steam228/GROUU/ARDUINO/GROUU_V3/docs/Board-Design.md

---
tags: [wellbouy, hardware, kicad]
---

# WellBouy — Board Design Notes

Keep-modular vs bring-on-board, one item per block, in bring-up order.
Companion to [[Bringup-Plan]]. ✅ decided · 🟡 mid-decision · ❓ needs info.

## 01 · MCU + LoRaWAN radio
- **Modules:** XIAO ESP32-S3 (socketed) + Wio-SX1262.
- **On-board:** header sockets, decoupling, BOOT/RST access, USB-C reachable.
- ✅ Both stay as modules (RF + USB + antenna already done/certified). Bare SX1262 only considered for a later rev.

## ADC (shared front-end)
- **Module:** ADS1115 16-bit I²C — Seeed Grove 4-ch (plug-and-play) or Adafruit PID 1085. Phidgets does **not** include an ADC, so this is required.
- **On-board:** ADS at 3.3 V, addr 0x48, I²C pullups; all sensor outputs scaled to ≤3.3 V before its inputs.
- ✅ Use ADS. ⚠️ Changes firmware pin map: analog sensors → ADS A0–A3, XIAO gains I²C, DS18B20 stays digital.
- 🔁 **ADS history:** the DFRobot Gravity I²C ADS1115 (the earlier "DFR0553" — it *is* the ADC, **not** a solar manager, so the solar-manager slot is still open) **died in bring-up**: reverse-polarity from the DFRobot-Gravity ↔ Grove **connector pinout mismatch** (they mate but VCC/GND differ). Confirmed dead — powered, bus healthy, wiring correct, **zero I²C ACK** (bit-bang verified). → Switching to a **Grove ADS1115** (Grove-to-Grove keyed = no mismatch), buying 2026-07-03.
- ⚠️ **Lessons → board TODO:** (1) **reverse-polarity protection** on every rail; (2) **keyed connectors**, and never mix Gravity↔Grove without checking pinout; (3) firmware **I²C bus-recovery / watchdog** — a bad device can hang the hardware `Wire` driver (bit-bang probe + bus-level check now live in `b03_tds` for debugging).

## 02 · Temperature — DS18B20
- **Module:** none (probe on cable).
- **On-board:** 4.7 kΩ pullup, probe connector, 3.3 V powered.
- ✅ Settled.

## 03 · TDS — DFRobot Gravity
- **Module:** DFRobot Gravity TDS conditioner board.
- **On-board:** 5 V (switched) feed, output divider to ADS, probe connector.
- 🟡 Module for rev A; integrating the AC-excitation front-end is a rev-B maybe.

## 04 · Turbidity — Seeed Grove
- **Module:** Seeed Grove turbidity sensor head/driver (replaced the DFRobot SEN0189).
- **On-board:** 10k/6.8k divider, 5 V (switched) feed, probe connector (U5 → A1).
- ✅ Divider on-board; head stays cabled.

## 05 · pH — Phidgets 1130
- **Module:** Phidgets 1130 adapter (analog conditioner, 0–5 V out, pH7 ≈ 2.5 V).
- **On-board:** 5 V (switched) feed, output divider to ADS, BNC/probe connector.
- 🟡 Keep module rev A (gigaΩ front-end + guard is easy to get wrong); integrate later only if needed.

## Connectors (all probes)
- ✅ Screw terminals / IP-rated (steady closed well, no Grove needed in the field). Grove only for bench.

## Power — Solar panel + battery + rails
- **Rails:** 3.3 V always-on (MCU, radio, ADS, DS18B20) + 5 V **switched** (analog conditioners, on ~1 s/cycle via GPIO load switch).
- **Test-phase module:** ❓ **DFR0553** — confirm it has MPPT/solar input and which rails (5 V only vs 5 V+3.3 V). If it's a real Solar Power Manager, it's the power core.
- **Fallback charger:** 🟡 **DFR1026** (Li-ion + 5 V boost, no MPPT). ⚠️ Bench-only until verified its 5 V **auto-restarts after full battery cutoff** (button/latch risk = no field auto-recovery).
- **On-board (custom rev):** our own high-side load switch for the 5 V sensor branch; later swap module for low-Iq buck/boost.
- **Battery:** 🟡 leaning 1S Li-ion 18650 (LiFePO4 if cold). Share battery node with XIAO BAT for the 3.3 V.
- **Panel:** ❓ none yet — size **after** bring-up measures sleep/active current; pick voltage to match the chosen charger.

## Rev-B feedback (from well-bouy01 fabrication + bring-up, 2026-07)
Lessons from building and bringing up the fabricated rev-A boards — the change list for rev-B.

- **ADS1115 hand-soldering is the #1 casualty. ✅ fix in rev-B.** The VSSOP-10 (0.5 mm pitch)
  ADS is brutal to hand-solder/rework — **3 boards damaged**, one ADS pad lifted during rework
  and killed a whole board mid-bring-up. → **Have JLCPCB SMT-assemble the ADS** (and the other
  fine-pitch/QFN parts), or move to a pre-assembled ADS1115 module footprint. If kept hand-built:
  larger/thermal-relieved pads + a paste stencil. This single change removes most of the build risk.
- **Terminal silk shows refdes (U2–U5), not function. ✅ fix in rev-B.** During bring-up the Grove
  turbidity got wired into **U3 (which is electrically the pH channel, A2)** because the silk only
  says "U3" — the numbering doesn't follow the sensor order. → Silk each screw terminal with its
  **function + ADS channel + pin order**, e.g. `TEMP 3V3·DAT·GND`, `TDS A0 5V·SIG·GND`,
  `TURB A1 5V·SIG·GND`, `pH A2 5V·SIG·GND`; label CN3 as `5V IN` and CN1/CN2 as `GROVE`.
- **Reverse-polarity P-FET (q_revp) is unprotected + easy to lose. 🟡 rev-B.** It burned when a
  live board was probed for continuity, and with it gone there's no reverse protection. → Add a
  **resettable fuse + TVS** on the 5 V input, and **test points** on v5v / v5v_sw / the ADS
  channels / SDA·SCL so bring-up doesn't require probing bare nets. Silk a "measure unpowered" note.
- **Turbidity sensor changed: DFRobot SEN0189 → Seeed Grove.** Same 5 V range, same 10k/6.8k
  divider, so no board change — but the BOM/labels reference Grove now (see §04).
- **Keep (worked well):** socketed XIAO + Wio-SX1262 as modules, switched-5 V load switch,
  3V3 always-on split, screw-terminal probes, single shared ADS front-end.
