steam228/GROUU/docs/index.md

---
layout: default
title: GROUU BOM PT_PT wip
---

# Set V0 GROUU
- - - -

## 1. Sonda de Solo - *Soil Probe*
- - - -
*Um conjunto de componentes formam um sensor wireless de medição de humidade e temperatura do solo. Os dados enviados por este sensor possibilitam tomada de decisão no que toca a opções de rega, entre outras informações importantes para o desenvolvimento das Plantas.*
*Dividido em dois componentes ligados por um fio, o primeiro será o corpo principal e o segundo apenas o encapsulamento de dois eletrodos adicionais, que quando ligados por fio ao corpo principal permitem a avaliação de humidade do solo, a uma profundidade superior.*

##### Componente Principal (corpo) contém:
- 2 electrodos;
- 1 Microcontrolador + Chip Wireless (dependendo do protocolo de comunicação pode assumir diferentes formas, neste caso apenas um ESP12)
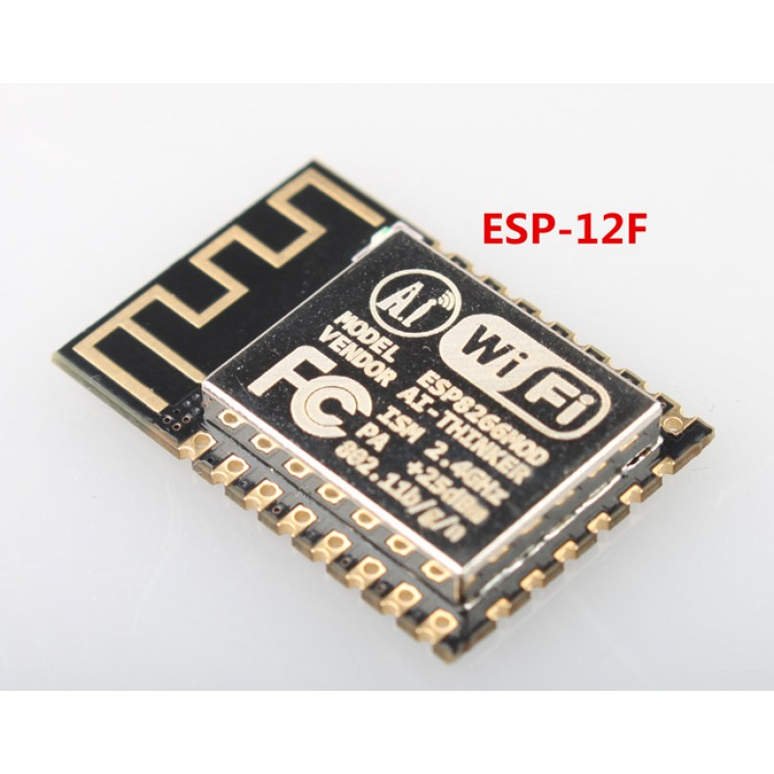
[picture p6: docs/Set V0 GROUU/00CDE53B-2D0E-4704-A9E1-9CB0C4399E5F 2.png]

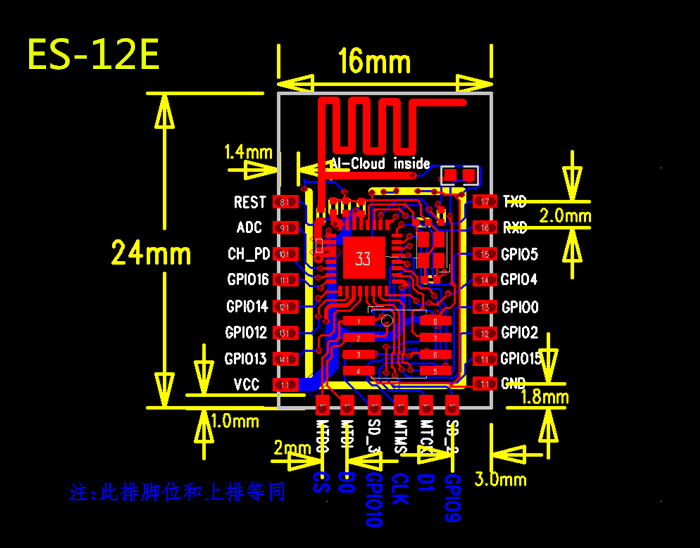
[picture p7: docs/Set V0 GROUU/8B35F060-8294-48BE-A186-7AB80FA3CB3D 2.png]


- Um termometro digital:
	- Com encapsulamento pp: [1pcs Direct waterproof DS18B20 digital temperature sensor (probe) a large number of original spot can be customised in Sensors from Electronic Components & Supplies on Aliexpress.com |
Alibaba Group](https://www.aliexpress.com/item/1pcs-Direct-waterproof-DS18B20-digital-temperature-sensor-probe-a-large-number-of-original-spot-can-be/32675444739.html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,searchweb201602_1_10065_10068_319_317_10696_453_10084_454_10083_433_10618_431_10304_10307_10820_10821_10301_537_536_10902_10059_10884_10887_321_322_10103,searchweb201603_16,ppcSwitch_0&algo_expid=053b9263-dde6-4dbb-8d99-83143a31b1db-0&algo_pvid=053b9263-dde6-4dbb-8d99-83143a31b1db) ou;
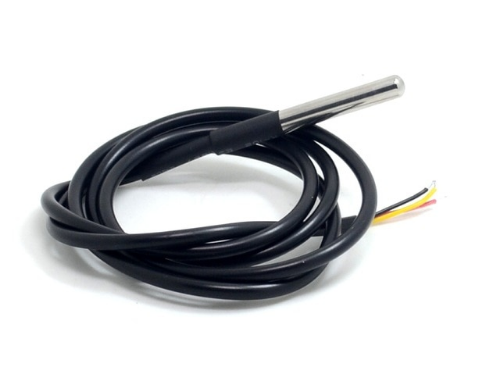
[picture p8: docs/Set V0 GROUU/Screenshot_2019-01-30 US $1 06 8% OFF 1pcs Direct waterproof DS18B20 digital temperature sensor (probe) a large number of o... 2.png]

	- integrar no desenho utilizando apenas componente: [Free Shipping 10pcs DALLAS DS18B20 18B20 TO 92 IC CHIP Thermometer Temperature Sensor-in Sensors from Electronic Components & Supplies on Aliexpress.com | Alibaba Group](https://www.aliexpress.com/item/Free-Shipping-10pcs-DALLAS-DS18B20-18B20-18S20-TO-92-IC-CHIP-Thermometer-Temperature-Sensor/32523899337.html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)*
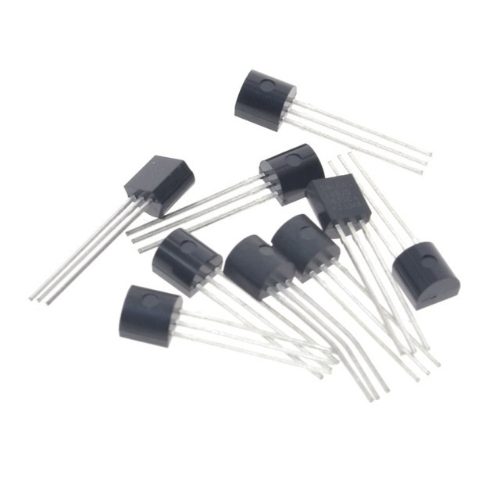
[picture p9: docs/Set V0 GROUU/Screenshot_2019-01-30 US $5 8 Free Shipping 10pcs DALLAS DS18B20 18B20 TO 92 IC CHIP Thermometer Temperature Sensor-in Sens... 2.png]


- Alguns componentes complementares: Resistências, condensadores e afins que podem compor a forma da restante placa de muitas formas diferentes, fazendo com que a maior condicionante seja o pp ESP12E;

##### Componente Secundária apenas com dois eletrodos ligados por fio à componente principal. esta é opcional e permite a mediação da humidade do solo a maior profundidade.


*Exemplos de outros formatos e configurações de Soil Moisture Sensors*
- - - -

## 2. “Encaminhador de Água” - *Water Router 1/4*
- - - -
*Serve para direccionar a água dividindo-a de um para 4. Assim, podemos juntar quantos quisermos em serie podendo desta forma aumentar a distribuição da água por mais zonas de rega.*

- Placa de Controle com:
	- ESP12E;
	- Alguns componentes complementares: Resistências, condensadores e afins que podem compor a forma da restante placa de muitas formas diferentes, fazendo com que a maior condicionante seja o pp ESP12E;
- Solenoid Valves: 1 para 4 12V NC (normally closed) [1Pcs DC 12V DN20 G3/4” 1 in 4 out Plastic Electromagnetic Valve Normally Closed Water Drain Valve-in Valve from Home Improvement on Aliexpress.com | Alibaba Group](https://www.aliexpress.com/item/1Pcs-DC-12V-DN20-G3-4-1-in-4-out-Plastic-Electromagnetic-Valve-Normally-Closed-Water/32897483874.html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,searchweb201602_1_10065_10068_319_317_10696_453_10084_454_10083_433_10618_431_10304_10307_10820_10821_10301_537_536_10902_10059_10884_10887_321_322_10103,searchweb201603_16,ppcSwitch_0&algo_expid=76eabde3-c4e3-4ab8-a5b5-27f0efe548b0-33&algo_pvid=76eabde3-c4e3-4ab8-a5b5-27f0efe548b0)
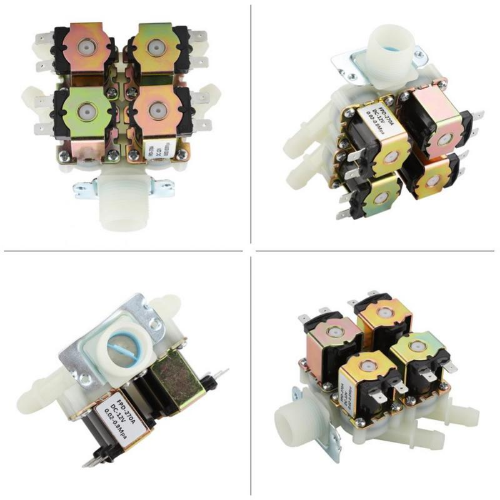
[picture p10: docs/Set V0 GROUU/Screenshot_2019-01-30 US $16 17 37% OFF 1Pcs DC 12V DN20 G3 4 1 in 4 out Plastic Electromagnetic Valve Normally Closed Wate... 2.png]

- - - -

## 3. Sensor de Nível da Água (Para adaptar a qualquer tanque de água) - *Water Level Sensor - Smart Tank*
- - - -
*Pretende-se a criação de uma unidade de sensor que possa ser adaptada à medição do volume existente em qualquer tanque. Bastará instalar e calibrar.*

- Placa de Controle com:
	- ESP12E;
	- Alguns componentes complementares: Resistências, condensadores e afins que podem compor a forma da restante placa de muitas formas diferentes, fazendo com que a maior condicionante seja o pp ESP12E;
- Sensor de nível de água pode ser conseguido de diferentes formas: (explos)
	- aplicar diferentes interruptores ligados por fio:[100V Liquid Water Level Sensor Horizontal Float Switch For Aquariums Fish Tank-in Flow Sensors from Tools on Aliexpress.com | Alibaba Group](https://www.aliexpress.com/item/100V-Liquid-Water-Level-Sensor-Horizontal-Float-Switch-For-Aquariums-Fish-Tank/32947871632.html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,searchweb201602_1_10065_10068_319_317_10696_453_10084_454_10083_433_10618_431_10304_10307_10820_10821_10301_537_536_10902_10059_10884_10887_321_322_10103,searchweb201603_6,ppcSwitch_0&algo_expid=cd4f33f5-30f1-44e8-972c-3e771defacdd-1&algo_pvid=cd4f33f5-30f1-44e8-972c-3e771defacdd)
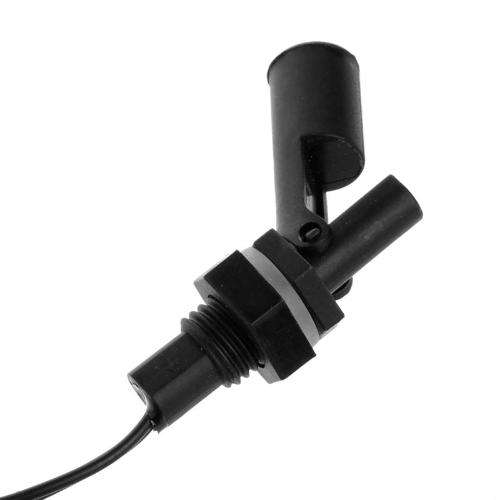
[picture p11: docs/Set V0 GROUU/Screenshot_2019-01-30 US $1 11 15% OFF 100V Liquid Water Level Sensor Horizontal Float Switch For Aquariums Fish Tank-in Fl... 2.png]


	- Usar um sensor InfraRed no topo: [Newest 15mA 5V Optical Infrared Water Liquid Level Sensor Liquid Water Level Control Switch Favorable Level Sensors-in Sensors from Electronic Components & Supplies on Aliexpress.com | Alibaba Group](https://www.aliexpress.com/item/Newest-15mA-5V-Optical-Infrared-Water-Liquid-Level-Sensor-Liquid-Water-Level-Control-Switch-Favorable-Level/32748475170.html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)
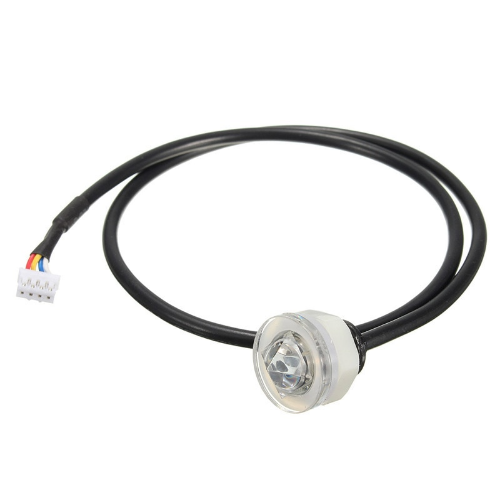
[picture p12: docs/Set V0 GROUU/Screenshot_2019-01-30 US $2 74 10% OFF Newest 15mA 5V Optical Infrared Water Liquid Level Sensor Liquid Water Level Control... 2.png]

- - - -

## 4. Controlador de Bomba de Água - *Water Motor Controller (to fit most 12V Solar water pumps)*
- - - -

*Trata-se de um controlador simples de motor, a colocar como interruptor na alimentação do Motor*

- Placa de Controle com:
	- ESP12E;
	- Alguns componentes complementares: Resistências, condensadores e afins que podem compor a forma da restante placa de muitas formas diferentes, fazendo com que a maior condicionante seja o pp ESP12E
- - - -

## 5. Bomba Doseadora Peristáltica - *Peristaltic Pump*
- - - -
*É uma bomba de pequenas dimensões que faz uma dosagem mais fina e precisa. Pode ser usado para regar um vaso ou para dosear outras substancias liquidas na água. Por exemplo um corrector de pH ou um fertilizante.*

- Placa de Controle com:
	- ESP12E;
	- Alguns componentes complementares: Resistências, condensadores e afins que podem compor a forma da restante placa de muitas formas diferentes, fazendo com que a maior condicionante seja o pp ESP12E
- Sistema de rolos ou elemento excêntrico que ao rodar pressione uma mangueira de silicone do tipo:
- NEMA14 ￼
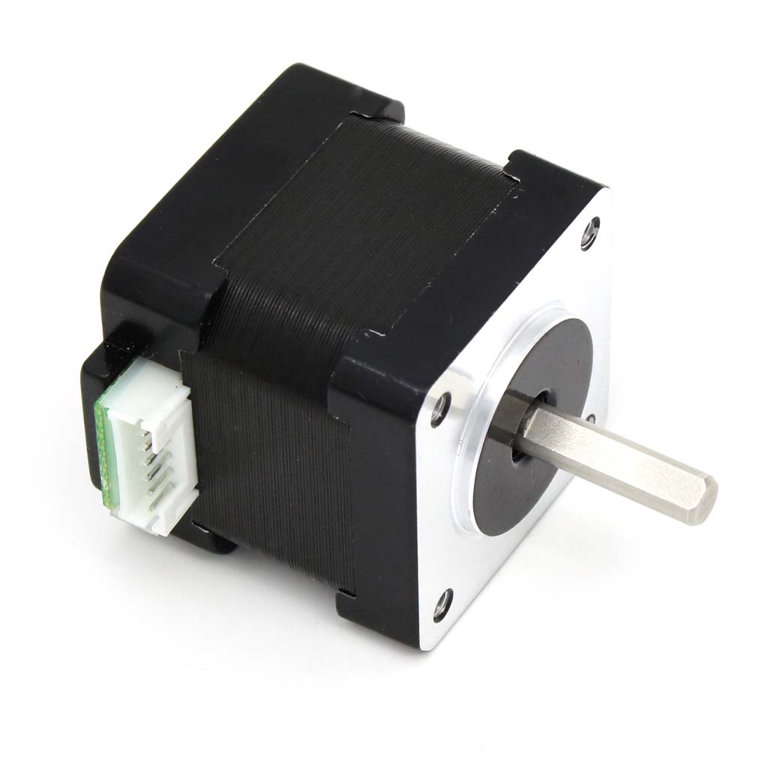
[picture p13: docs/Set V0 GROUU/MotorSide 2.jpg]

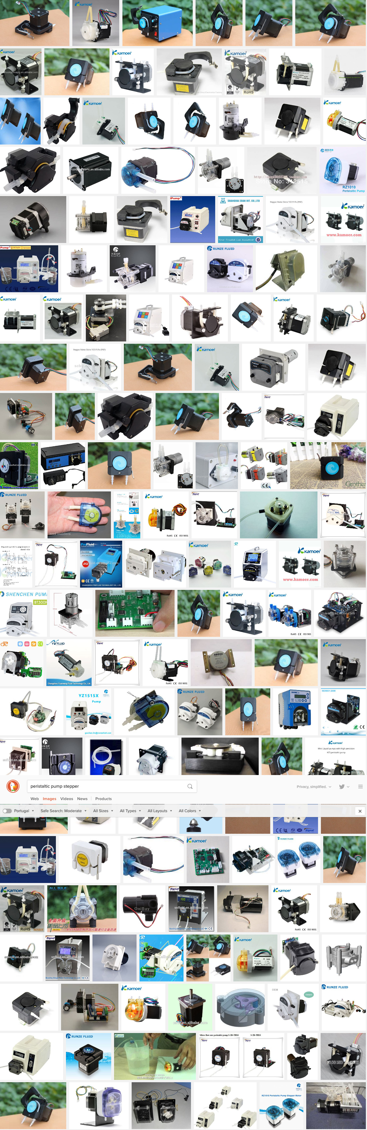
[picture p14: docs/Set V0 GROUU/Screenshot_2019-02-02 peristaltic pump stepper at DuckDuckGo.jpg]

*Exemplos de outros formatos e configurações de bombas peristalticas*

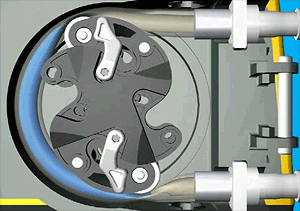
[picture p15: docs/Set V0 GROUU/Peristaltic_pump.gif]

*Como Funciona uma Bomba Peristática*
- - - -

￼
## 6. Carregador de Indução - *(Solar) Inductive Charger*
- - - -

- Placa de Controle com:
	- ESP12E;
	- Alguns componentes complementares: Resistências, condensadores e afins que podem compor a forma da restante placa de muitas formas diferentes, fazendo com que a maior condicionante seja o pp ESP12E
- Uma Bateria de Back-up;
- **Alimentação:**
	- Pode estar ligado à corrente eléctrica 220V e aí terá que ter um conversor ou transformador, tipo carregador de telemóvel;
	- Possui painéis solares: [198E 4W 5.5V Polysilicon Solar Panel Cell Sunlight Charger Road Lamps Outdoors  | eBay](https://www.ebay.com/itm/198E-4W-5-5V-Polysilicon-Solar-Panel-Cell-Sunlight-Charger-Road-Lamps-Outdoors-/273681207899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)
*Specification:
Colour: Black
Material: Polysilicon
Length: 18.5cm
Width: 7.4cm
Thickness: 0.2
Maximum power: 4 (W)
Operating current: 720 (A)
Operating voltage: 5.5 (V)
Working temperature: -20 ℃ - + 85 ℃
Mainly used in solar power road lights, garden lamps, uninterruptible power supply, solar mobile power gifts, etc.*
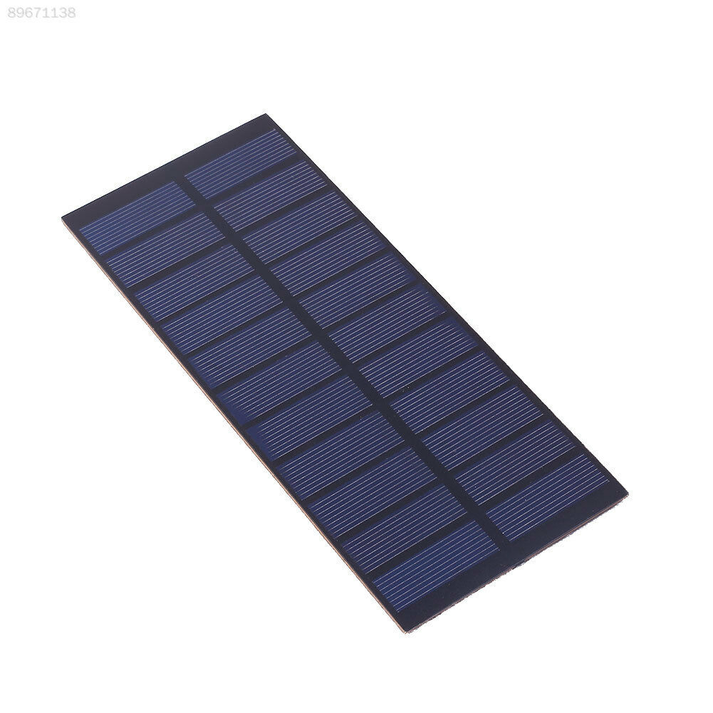
[picture p16: docs/Set V0 GROUU/s-l1600.jpg]

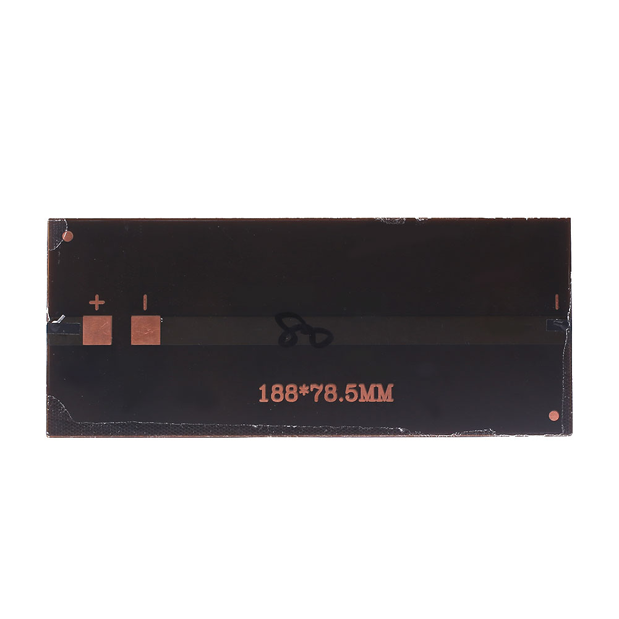
[picture p17: docs/Set V0 GROUU/158244_3.jpg]

- - - -

## 7. Núcleo - *Core*
- - - -
*Apenas um computador ligado à rede por Wireless*

- Raspberry Pi Zero W alimentado por transformador ou com bateria pp.
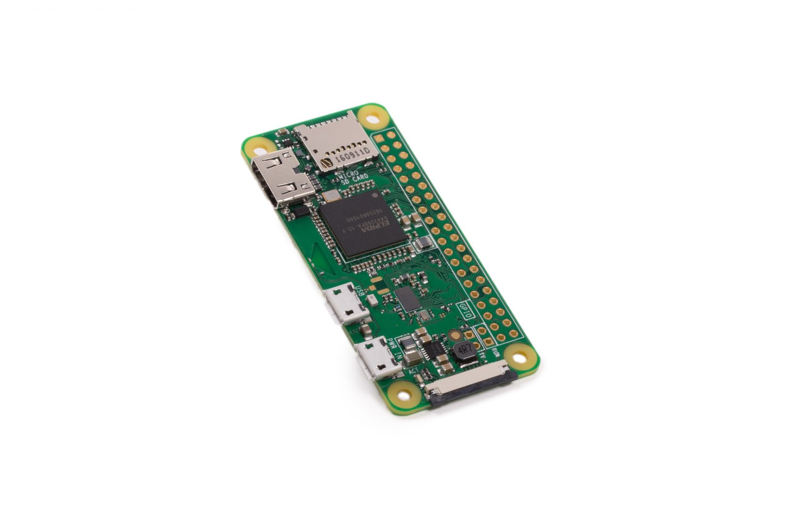
[picture p18: docs/Set V0 GROUU/Pi-Zero-W-Tilt-1-1620x1080.jpg]

(modelo 3D no GrabCAD) [3D CAD Model Collection | GrabCAD Community Library](https://grabcad.com/library/raspberry-pi-zero-w-board-1)
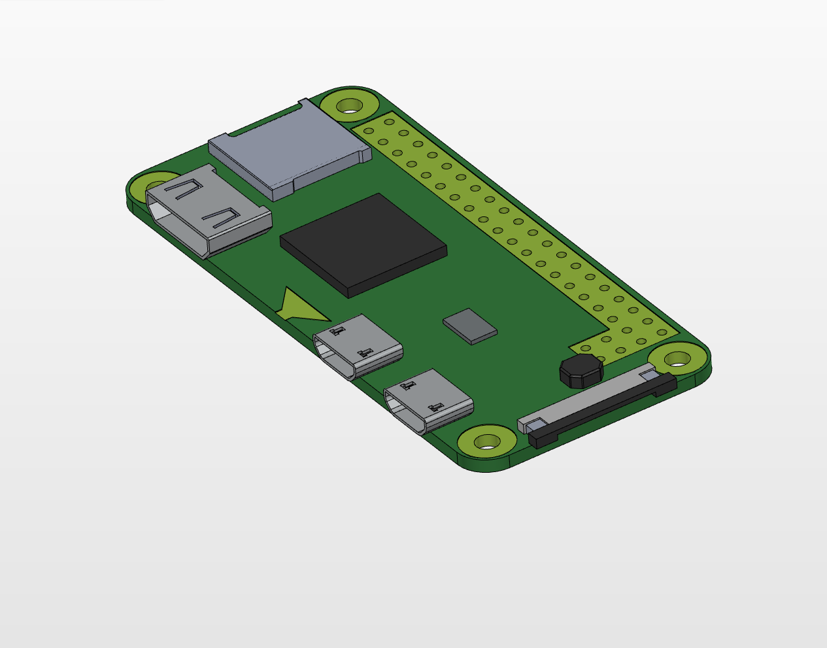
[picture p19: docs/Set V0 GROUU/Screenshot 2019-02-02 at 19.34.35.png]

- - - -

## Elementos Comuns a todos os módulos excepto Carregador.
- - - -

- 1 Inductive Charger - apenas o lado que recebe a carga:
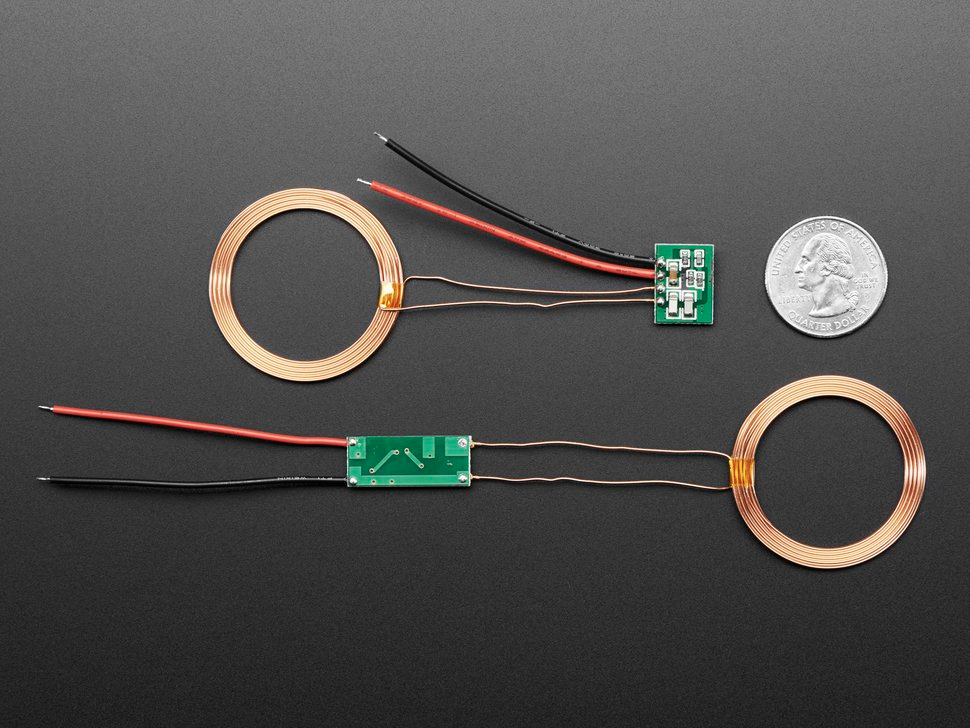
[picture p20: docs/Set V0 GROUU/C57A9D53-3890-4C2B-9CDF-74C4127D9533 2.png]

- 1 Bateria Li-On ou Li-Po 3,7V
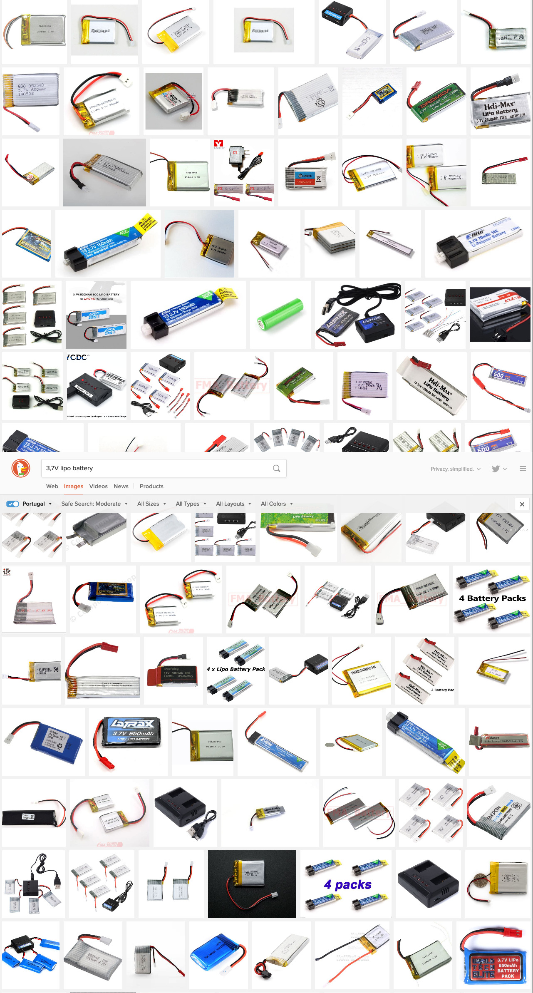
[picture p21: docs/Set V0 GROUU/Screenshot_2019-02-02 3,7V lipo battery at DuckDuckGo.jpg]


#phd #grouu
