steam228/GROUU/docs/docs_new/project/uploads/FEUP-presentation.md

---
title: "FEUP Presentation — 1st-Person Design & the Well-Water Sensor"
date: 2026-07-06
tags: [phd, coursework, presentation, feup, tech-lab, 1st-person-design, slides]
cssclasses: []
---

# 1st-Person Design in Practice

### An open-source well-water sensor

André Rocha
Technologies Lab · FEUP
*provisional status*

---

## Designing *within*

- **Tomico et al. (2012):** designer as inhabitant and **primary user**
- Knowledge is **situated** — produced through sustained, lived engagement
- Not designing *for* others, nor only *with* them

Why it works as a **research mode**:

- Accountability — you live the failure
- Authentic edge cases, need-driven inquiry

> 1st-person *research method* = the lens on a 1st-person *design practice*

<!-- → transition A→B: "I didn't pick this position — a trajectory delivered me to it." -->

---

## GROUU: one inward shift

<!-- Frame as a progression, not a taxonomy -->

- **3rd person** — universal greenhouse automation, open hardware at scale · *for*
- **2nd person** — FarmLabs: gathering community, open design's social-movement dimension · *with*
- **1st person** — researcher-as-practitioner · *within*

<small>1st / 2nd / 3rd-person perspectives: **Menichinelli (2025)**; origin Tomico et al. (2012)</small>

---

## Where it led — the question

- Open source design is theorised as **collective and distributed**
- So: is individually-situated **1st-person practice part of it — or outside it?**
- Hypothesis: the situated maker is a **node in the open ecosystem**, not a departure from it
- A register of participation **invisible to project-centric instruments** → *ecosystemic participation*

<!-- → transition B→C: "Not past tense — it's the live work of the prototype." -->

---

## The artifact

**Open-source well water sensor**

- Measures: TDS · turbidity · temperature · pH
- **XIAO ESP32-S3 + Wio-SX1262 (LoRaWAN)**
- → The Things Network → **RPi 4** pipeline
  (Mosquitto · Node-RED · InfluxDB · Grafana)
- Deployed at **my own well** — 1st-person by construction

---

## Status & goals

**Goal:** a working, field-deployed node.

| Milestone | State |
|---|---|
| Proposal · kits purchased | ✅ done |
| M1 — sensor integration (5V→3.3V, calibration) | ▶ next |
| M2 — enclosure & power | ◻ |
| M3 — well deployment + ≥1 week data | ◻ |

<small>Companion Media Tech survey (open hardware + AI-assisted making) uses this as its case study.</small>

---

## What it opens

- **Dual framing:** first-person *method* studying first-person *practice*
- **Enablers:** open hardware + LLM coding assistance make solo, technically-grounded work viable
- **Tensions:** AI dependency · sample-of-one

<!-- → transition C→D: "How I study this — linking making to analysis — is still being built." -->

---

## Process — *in progress*

<!-- placeholder, to be developed -->

Structured memory-digging
→ autoethnographic narrative
→ read through the person-perspective framework
→ where open hardware / AI intervened

**Next:** integration → enclosure → deployment

*[to be developed]*
