steam228/GROUU/docs/docs_new/project/uploads/Projects/GROUUWAN-LoRaWAN.md

---
tags: [grouu, lorawan, ttn, grouuwan, sensors]
status: moved
---

# GROUUWAN — LoRaWAN Sensor Network

> **This content has been moved to [[SensorNodes/LoRaWAN|LoRaWAN Sensor Network]].**
>
> Consolidated into `/SensorNodes/` alongside WiFi and Meshtastic node docs.
