steam228/GROUU/docs/docs_new/project/uploads/Projects/YouTube/Episode-01-Script.md

---
tags: [grouu, youtube, script, episode, portuguese]
status: done
---

# 🥦 Episode 01 — O Terreno da Verdade (Script)

← [[GROUU-Youtube|🌽 YouTube Channel]] · [[../../HOME|🌿 HOME]]

---

## Episode Info

| Field | Value |
|---|---|
| Title | Episódio 1: O Terreno da Verdade |
| Language | Portuguese |
| Status | ✅ Script complete |
| Theme | Honest accounting — 15 years of theory, abandoned land |

---

## Script

---

**[SEQUÊNCIA DE ABERTURA — PARA USAR EM TODOS OS EPISÓDIOS]**

*[Música rústica e envolvente]*

**HOST:** *(caminhando pelo terreno)* Bem-vindos ao GROUU. O meu nome é André Rocha, sou designer, professor e investigador, e isto é a história de como 15 anos de investigação sobre agricultura open-source finalmente encontram o seu terreno de teste. Literalmente.

**[TÍTULO DO EPISÓDIO: "Episódio 1: O Terreno da Verdade"]**

---

**[CUT PARA HOST NA SECRETÁRIA MAKER — SETUP PODCAST]**

**HOST:** *(olhando diretamente para a câmara)* Vou ser brutalmente honesto convosco. Há 15 anos que ando a investigar a aplicação de hardware e design open-source a agricultura... E sabem onde é que todo esse conhecimento tem estado a aplicar-se? Em documentos, em bookmarks do browser, em conversas de café, em pequenas experiências, em workshops com crianças...

*(pausa, sorriso irónico)*

O meu terreno? Está praticamente abandonado.

---

**[MONTAGEM DE IMAGENS DO TERRENO ATUAL]**

**HOST (VOICEOVER):** Esta é a realidade. Anos de boas intenções, alguns sucessos pontuais, algumas culturas que correram bem, mas depois... a vida acontece. O trabalho, os projetos, as desculpas.

---

**[VOLTA À SECRETÁRIA MAKER]**

**HOST:** Mas o GROUU vai mudar isso. Esta série não é sobre mostrar-vos a horta, o pomar ou o galinheiro perfeitos. É sobre finalmente pôr as mãos na terra e aplicar tudo o que tenho andado a estudar. É sobre compromisso real, não apenas teórico.

E vocês vão ver tudo. Os sucessos, os falhanços, as descobertas, e provavelmente umas quantas crises existenciais pelo caminho.

---

**[TRANSIÇÃO PARA EXTERIOR — ENTRADA DO TERRENO]**

**HOST:** *(com iPhone na mão, gravação próxima)* Então, este é o terreno. Não é grande, não é pequeno, é... nosso. E está numa situação interessante.

*(caminhando, mostrando árvores de fruto)*

Estas árvores de fruto já viram dias melhores. Digamos que precisam de atenção.

**[CLOSE-UP COM IPHONE DAS ÁRVORES]**

**HOST:** *(voz próxima, documental)* Vou documentar tudo desta forma também. Os detalhes, o que funciona, o que não funciona. Sem filtros.

---

**[VOLTA À CÂMARA PRINCIPAL]**

**HOST:** *(aproximando-se do poço)* Este poço sempre foi a nossa âncora. Água própria significa independência, mas também responsabilidade. Vamos ter de testar o caudal, a qualidade, e integrar isto num sistema de rega inteligente.

*(movendo-se para a eira)*

E isto aqui é uma eira tradicional portuguesa. Antigamente servia para secar e debulhar cereais. Agora? Talvez painéis solares, talvez uma estação meteorológica, talvez simplesmente um local para montar equipamento.

---

**[ENTRANDO NO PEQUENO CELEIRO]**

**HOST:** Esta estrutura já albergou galinhas, ovelhas, cabras. Agora está vazia, mas tem potencial enorme. Pode voltar a ter animais, ou pode manter-se como um espaço de armazenamento de pequenas alfaias. Mas precisa de alguns cuidados.

---

**[ÁREA FLORESTAL SOMBREADA]**

**HOST:** E finalmente, esta zona com pinheiros e oliveiras antigas. É o pulmão do terreno. Sombra, biodiversidade, e uma lição constante de que nem tudo tem de ser produtivo no sentido tradicional.

---

**[VOLTA À SECRETÁRIA MAKER]**

**HOST:** A ironia não me escapa. Quinze anos a estudar isto, e o meu próprio terreno está abandonado. Mas é precisamente por isso que o GROUU faz sentido.

Não vou fingir que sou um especialista. Vou mostrar-vos a minha jornada de aplicar conhecimento teórico à realidade prática. E a realidade prática é teimosa, imprevisível, e às vezes frustrante.

---

**[MOSTRANDO MAPAS E NOTAS]**

**HOST:** Aqui tenho anos de investigação. Artigos sobre sensores de solo open-source, sistemas de rega, monitorização ambiental... E ali fora tenho o laboratório perfeito para testar tudo isto.

---

**[ÚLTIMO PLANO EXTERIOR — PANORÂMICA DO TERRENO]**

**HOST (VOICEOVER):** Os meus vizinhos têm abordagens diferentes. Uns fazem agricultura tradicional, outros já a abandonaram há uns anos, alguns experimentam métodos biológicos. Vamos aprender com todos.

---

**[VOLTA À SECRETÁRIA]**

**HOST:** Então, o que vem a seguir? Nas próximas semanas vamos:
- Fazer análises ao solo
- Testar o poço
- Criar um plano de recuperação do terreno
- E lançar os primeiros projetos

O objetivo não é criar a quinta perfeita. É documentar honestamente como se transforma conhecimento teórico em ação prática. Com todos os tropeções pelo caminho.

Se têm experiência semelhante, se já passaram por isto, ou se simplesmente querem acompanhar esta jornada de compromisso tardio mas real, subscrevam e comentem.

Até à próxima. E desta vez, vai mesmo haver próxima.

**[SEQUÊNCIA FINAL COM INFO DO CANAL E PREVIEW DO PRÓXIMO EPISÓDIO]**

---

## 🔗 Related

- [[GROUU-Youtube|YouTube Channel]] — production plan + episode list
- [[../GROUU-Setup-Loureiro|GROUU Loureiro]] — the farm shown in this episode

---

## 🏷️ Tags

`#script` `#youtube` `#grouu` `#episode-01` `#portuguese` `#farming`
