steam228/GROUU/ARCHIVE/grouu-v0/photos/README.md

# V0 photos

Curated, **web-sized** build photos of GrouuPro — the greenhouse (built &amp; in
construction), the ventilation hatch, the fertigation cabinet, peristaltic pumps,
water/electricity inlets, the Arduino Yún control unit, sensor probes, and the
raised beds.

The **full-res originals** stay on the OneDrive backup (`FOTO/` + `DP/`) — see
[`../MANIFEST.md`](../MANIFEST.md). The same web-sized set is served on the docs
page at `docs/site/img/v0/`.
