steam228/GROUU/ARCHIVE/grouu-v0/drawings/apresentação 1.pdf

# estufa

# lab

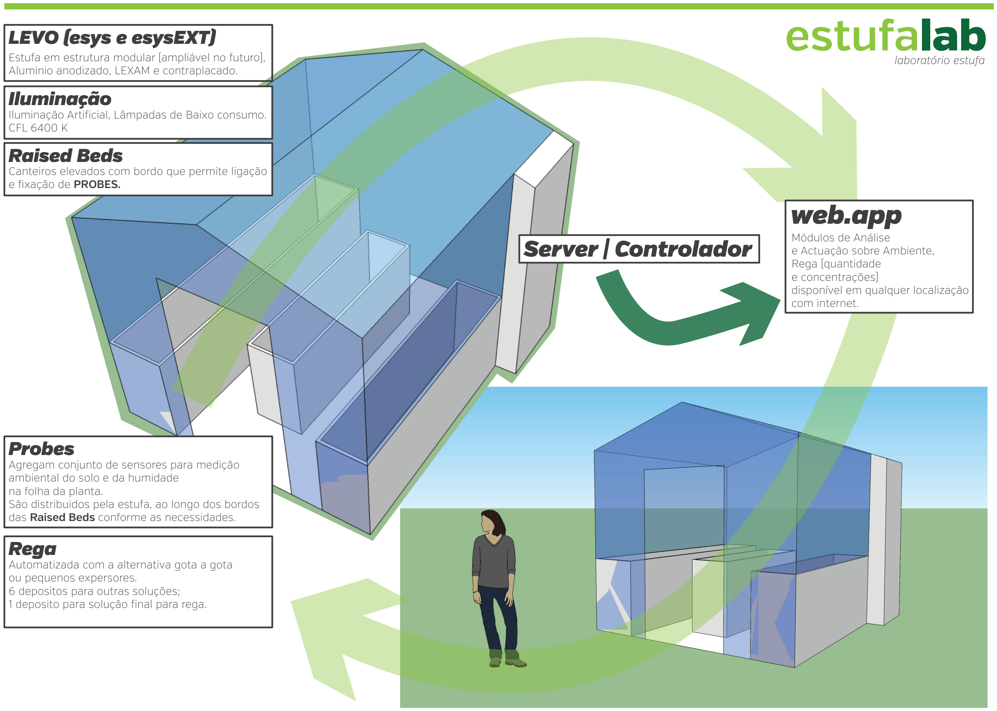
[picture p22: page 1]

laboratório estufa

# web.app

Módulos de Análise
e Actuação sobre Ambiente,
Rega (quantidade
e concentrações)
disponível em qualquer localização com internet.

# LEVO (esys e esysEXT)

Estufa em estrutura modular (ampliável no futuro), Aluminio anodizado, LEXAM e contraplacado.

# Iluminação

Iluminação Artificial, Lâmpadas de Baixo consumo. CFL 6400 K

# Raised Beds

Canteiros elevados com bordo que permite ligação e fixação de PROBES.

# Probes

Agregam conjunto de sensores para medição ambiental do solo e da humidade
na folha da planta.
São distribuidos pela estufa, ao longo dos bordos das Raised Beds conforme as necessidades.

# Rega

Automatizada com a alternativa gota a gota
ou pequenos expersores.
6 depositos para outras soluções;
1 deposito para solução final para rega.

# Server | Controlador
