steam228/GROUU/ARDUINO/GROUU_V3/hardware/processImgs/process01.jpg

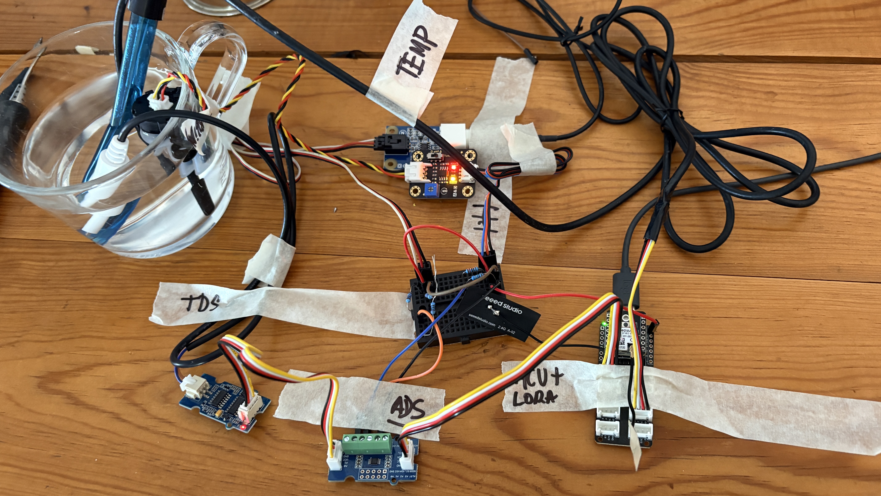
ARDUINO/GROUU_V3/hardware/processImgs/process01.jpg
