steam228/GROUU/docs/docs_new/project/uploads/Projects/1stPerson/Attachments/Screenshot 2026-04-01 at 11.31.33.png

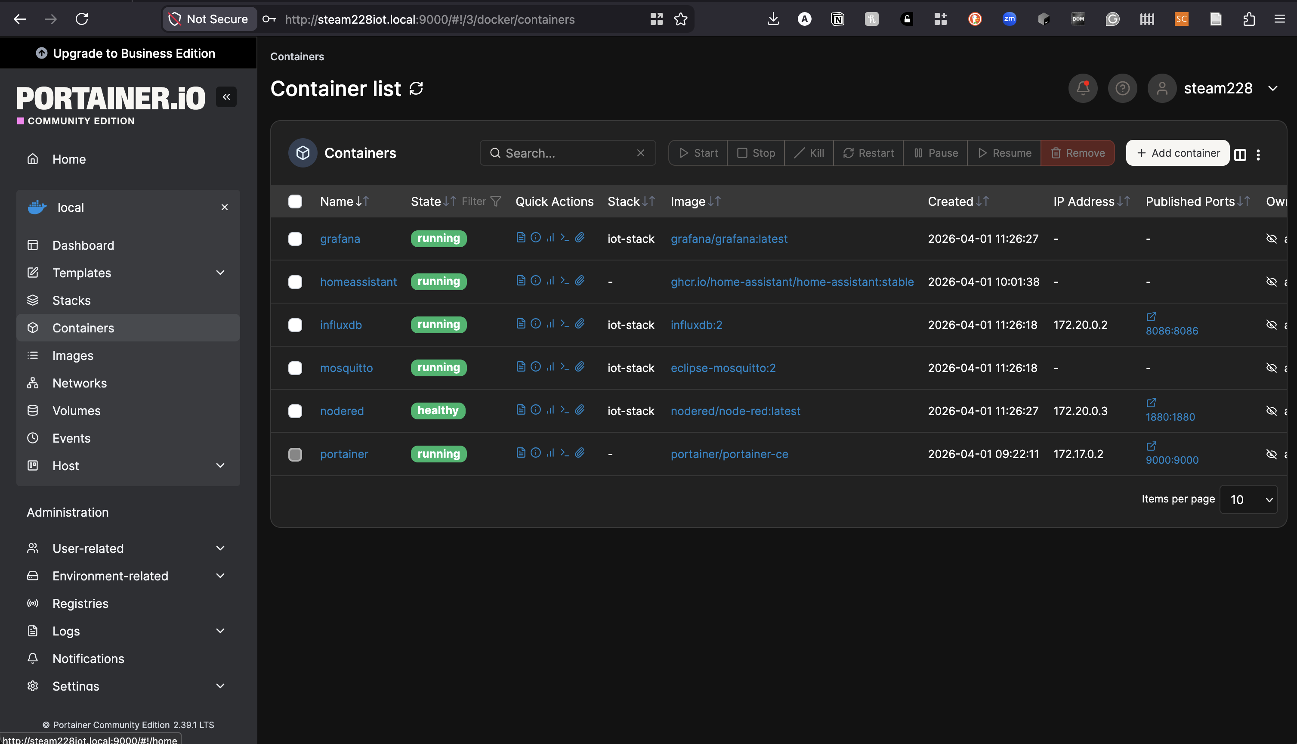
docs/docs_new/project/uploads/Projects/1stPerson/Attachments/Screenshot 2026-04-01 at 11.31.33.png
