steam228/GROUU/docs/site/img/alface/circuit-final.png

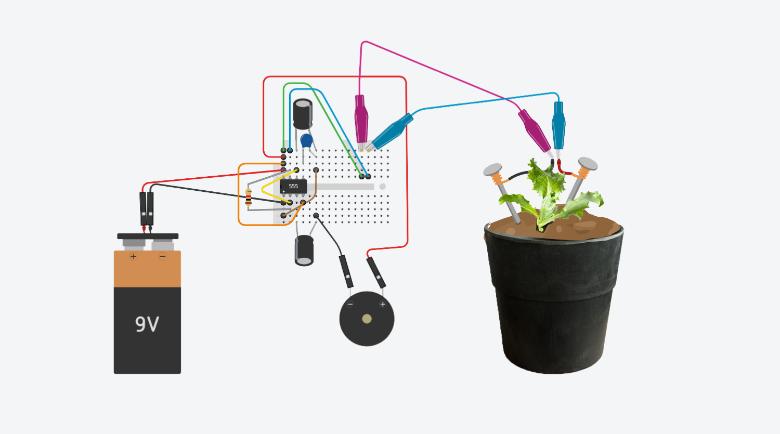
docs/site/img/alface/circuit-final.png
