steam228/GROUU/docs/site/img/alface/circuit-osc.png

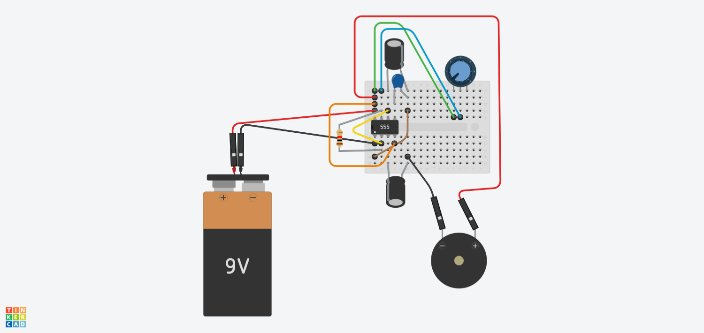
docs/site/img/alface/circuit-osc.png
