steam228/GROUU/docs/site/img/alface/hero.jpg

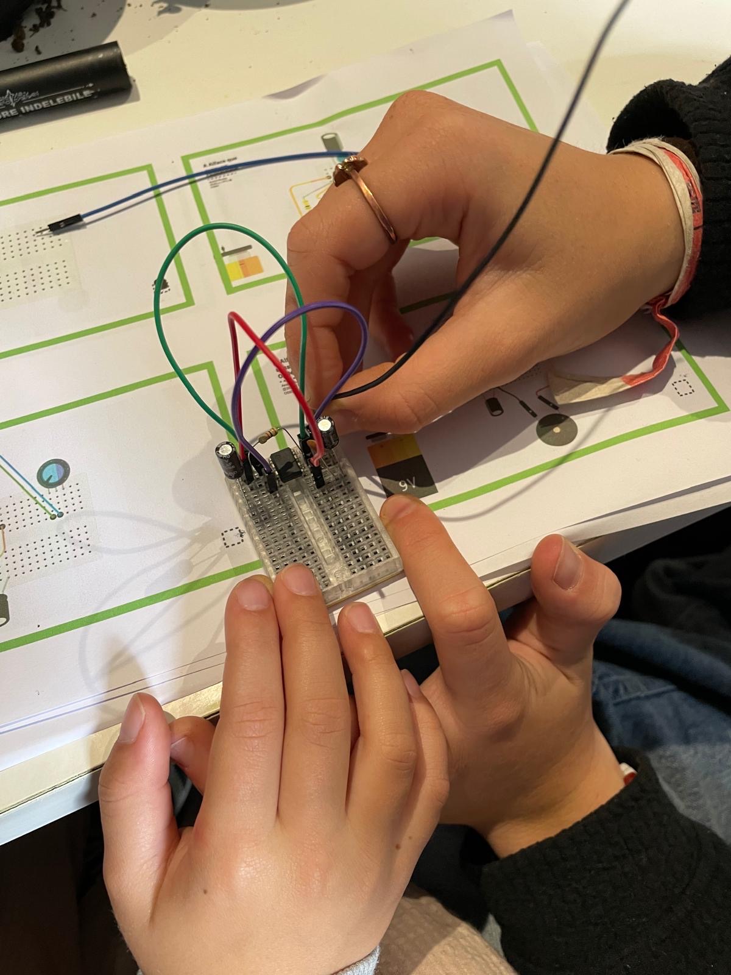
docs/site/img/alface/hero.jpg
