steam228/GROUU/docs/site/img/alface/osso-01.jpg

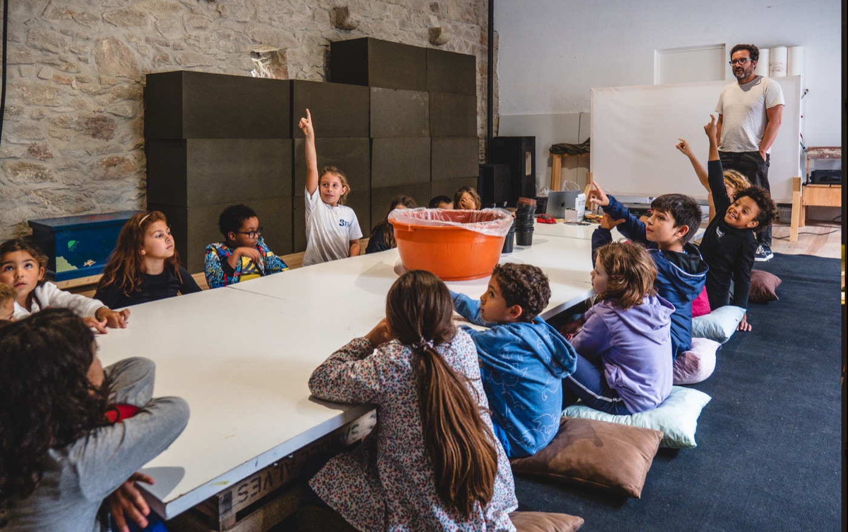
docs/site/img/alface/osso-01.jpg
