steam228/GROUU/docs/site/img/alface/osso-02.jpg

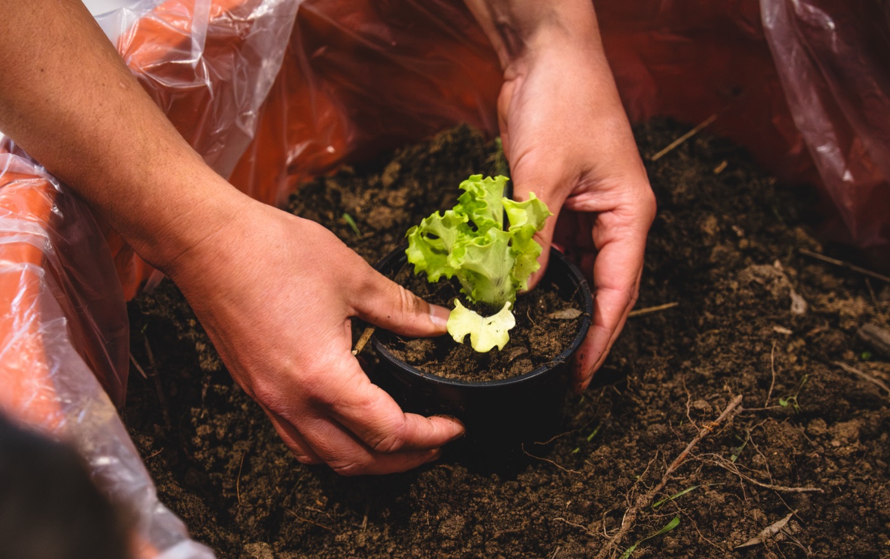
docs/site/img/alface/osso-02.jpg
