steam228/GROUU/docs/site/img/alface/osso-03.jpg

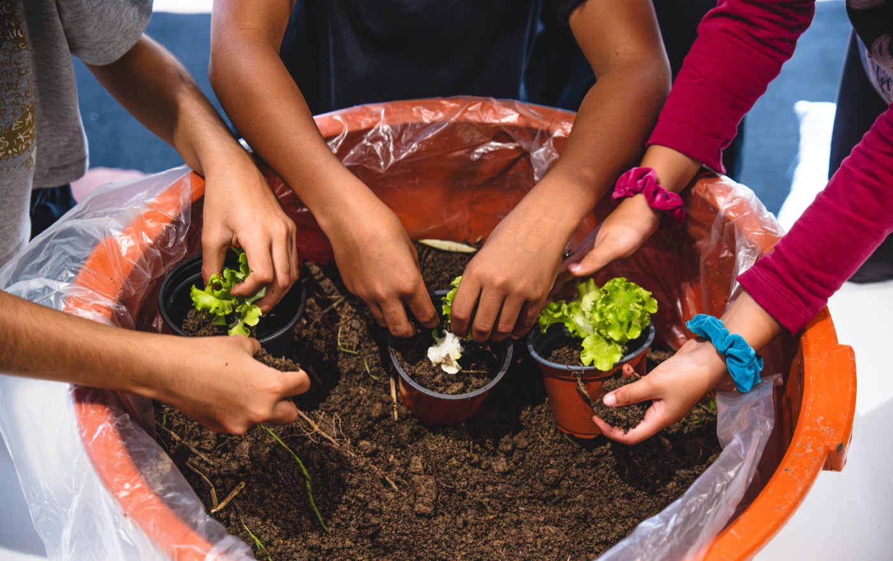
docs/site/img/alface/osso-03.jpg
