steam228/GROUU/docs/site/img/alface/osso-04.jpg

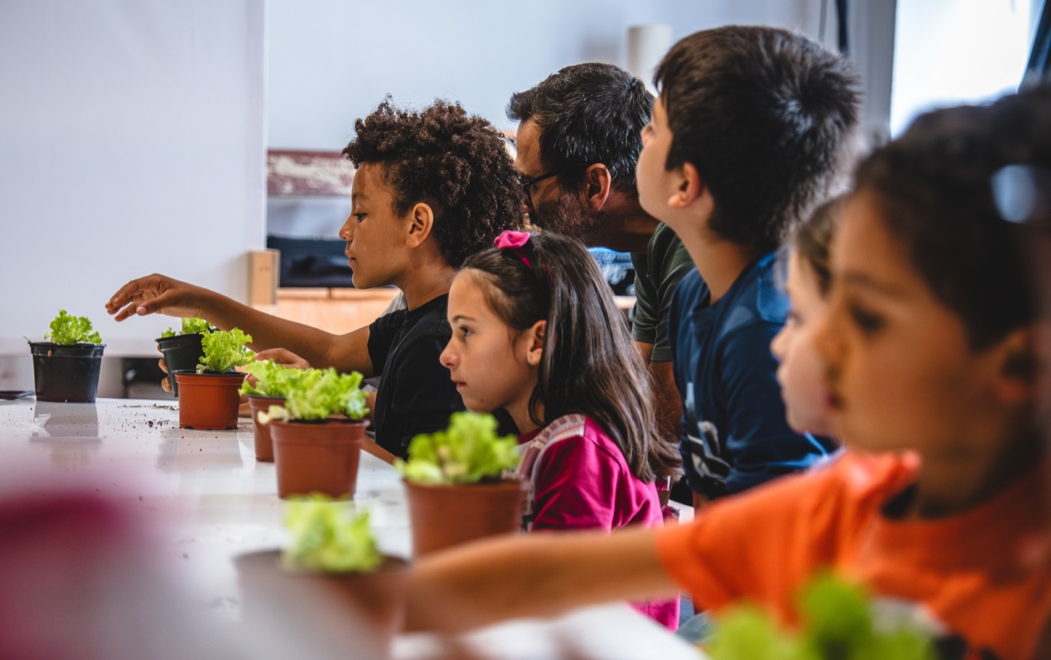
docs/site/img/alface/osso-04.jpg
