steam228/GROUU/docs/site/img/alface/osso-05.jpg

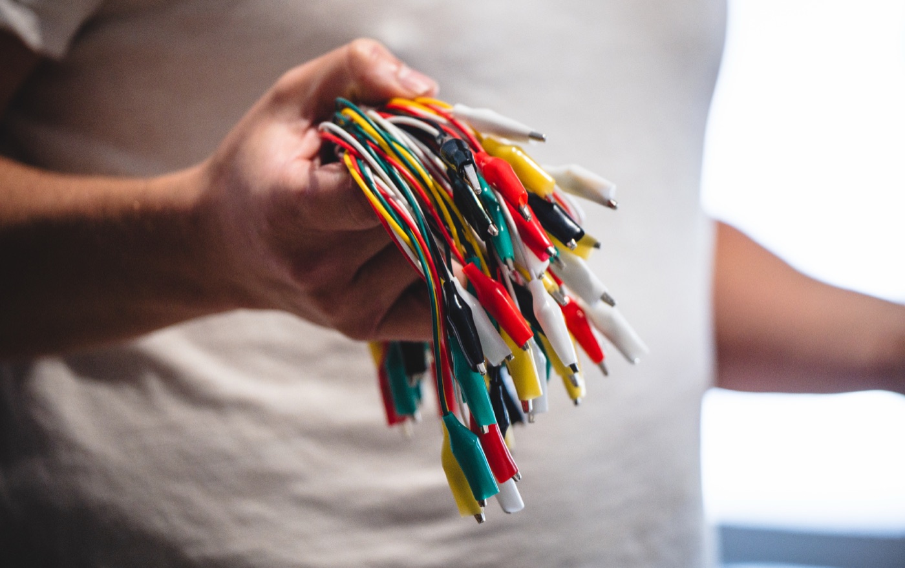
docs/site/img/alface/osso-05.jpg
