steam228/GROUU/docs/site/img/alface/osso-06.jpg

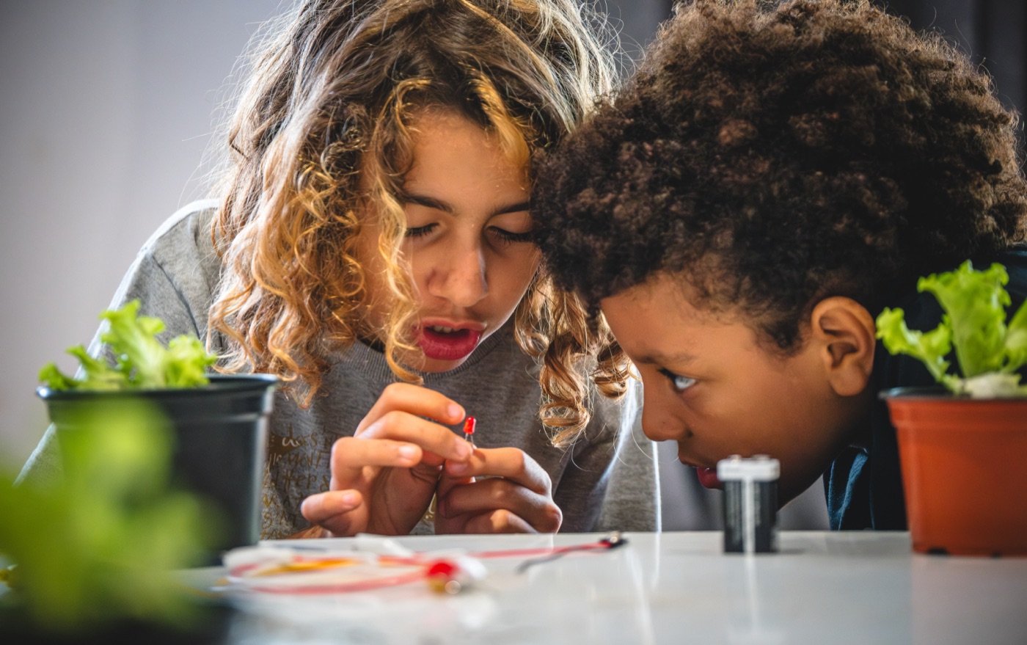
docs/site/img/alface/osso-06.jpg
