steam228/GROUU/docs/site/img/alface/osso-07.jpg

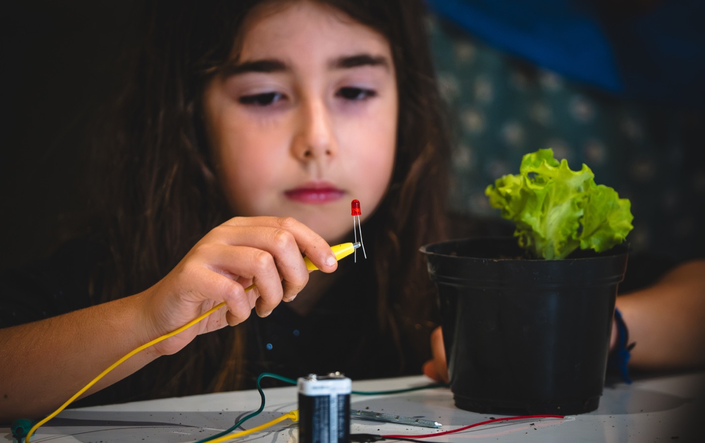
docs/site/img/alface/osso-07.jpg
