steam228/GROUU/docs/site/img/alface/osso-08.jpg

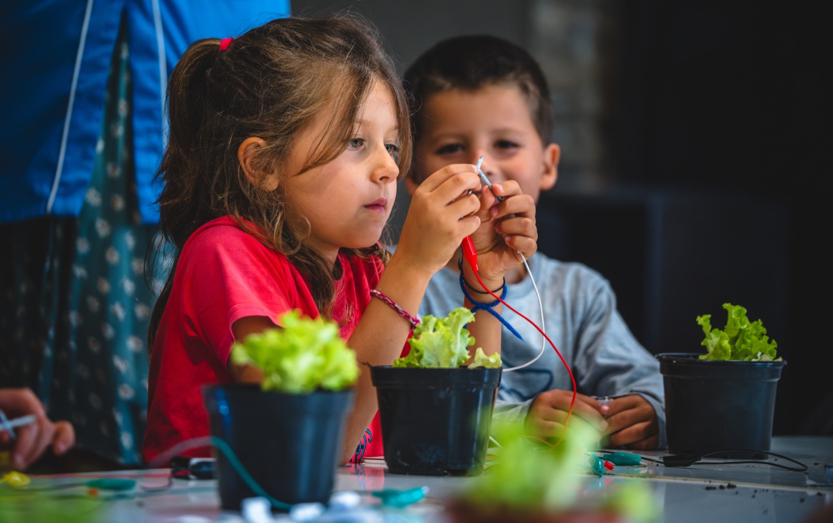
docs/site/img/alface/osso-08.jpg
