steam228/GROUU/docs/site/img/alface/osso-09.jpg

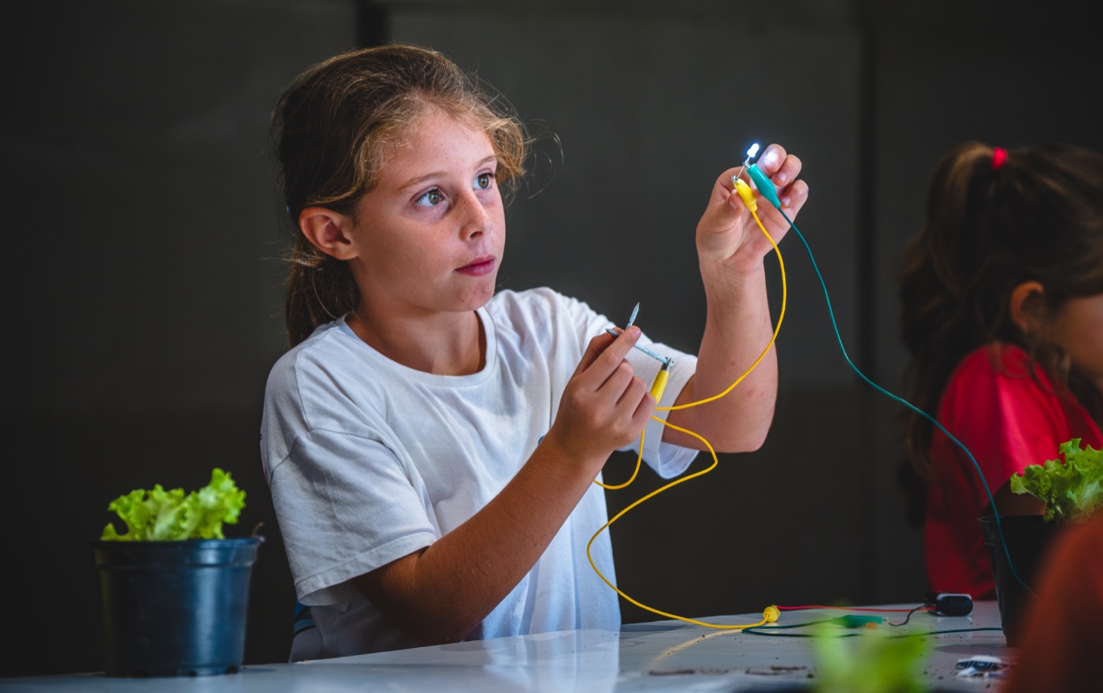
docs/site/img/alface/osso-09.jpg
