steam228/GROUU/docs/site/img/alface/osso-10.jpg

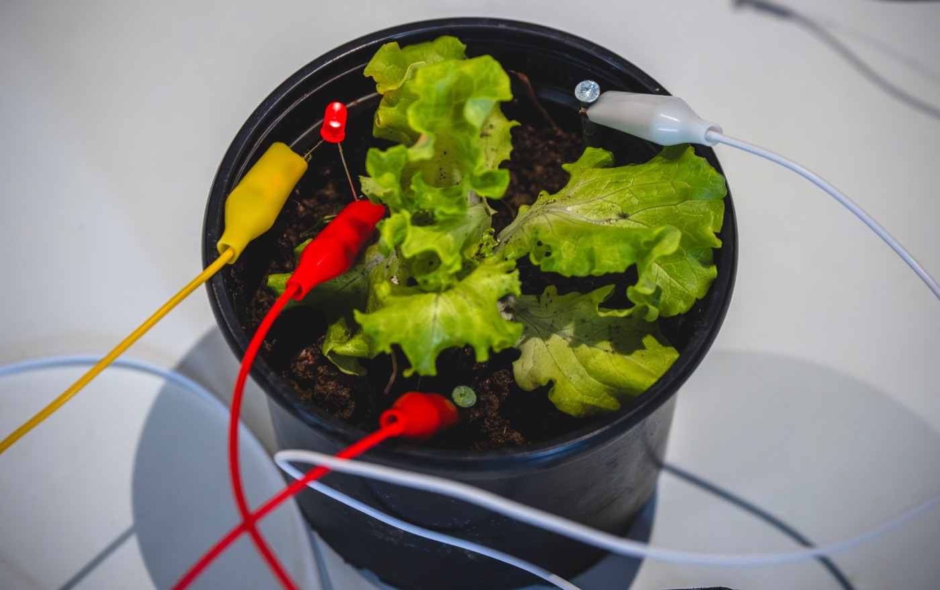
docs/site/img/alface/osso-10.jpg
