steam228/GROUU/docs/site/img/alface/osso-11.jpg

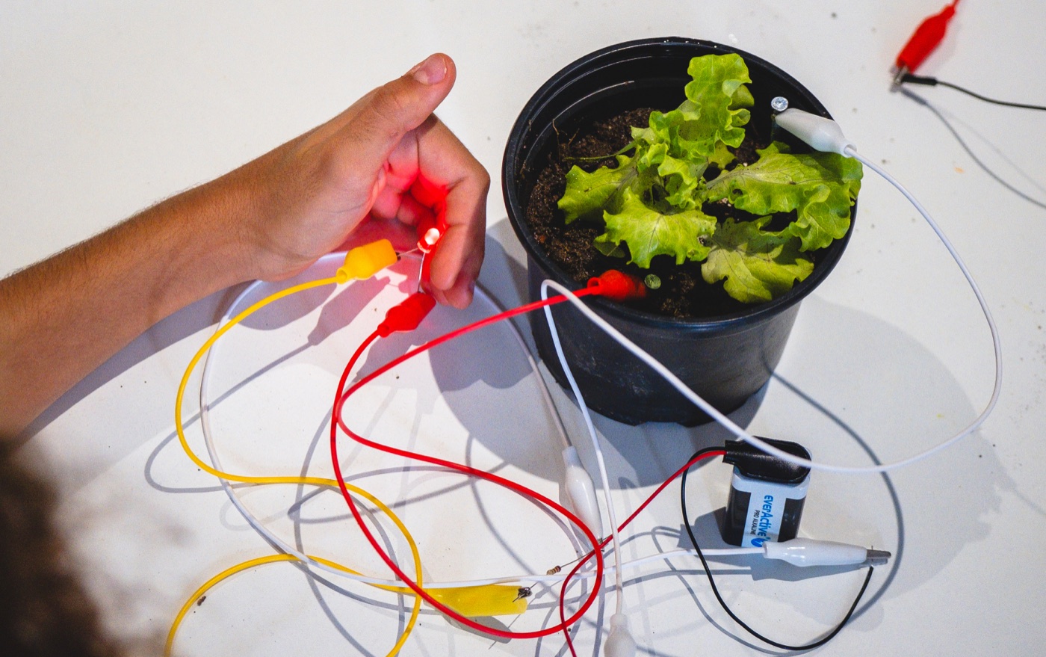
docs/site/img/alface/osso-11.jpg
