steam228/GROUU/docs/site/img/alface/osso-12.jpg

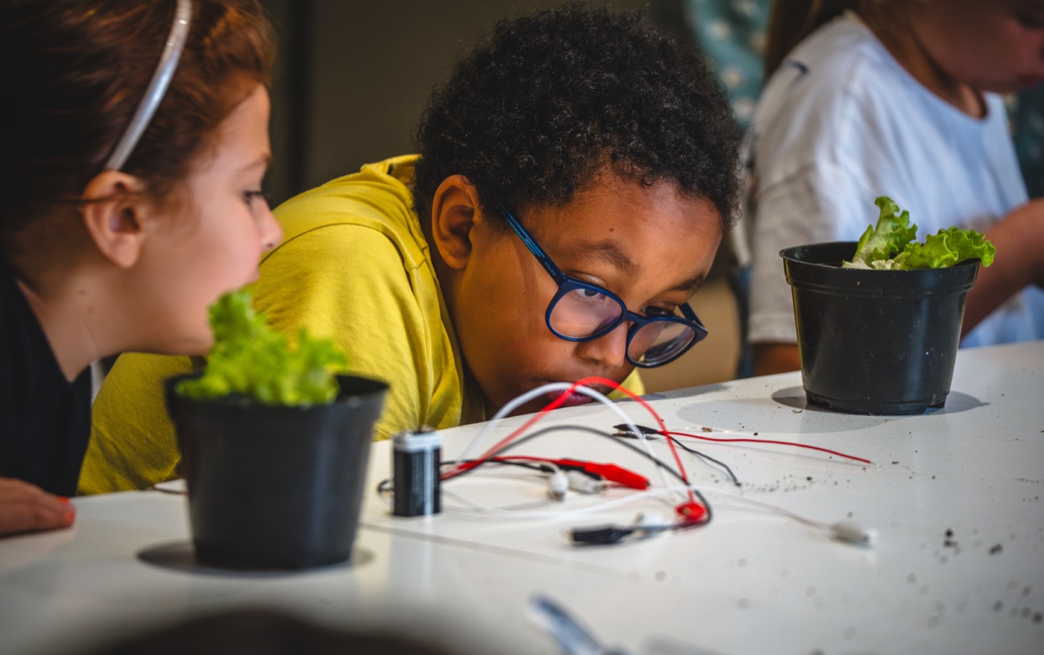
docs/site/img/alface/osso-12.jpg
