steam228/GROUU/docs/site/img/alface/osso-13.jpg

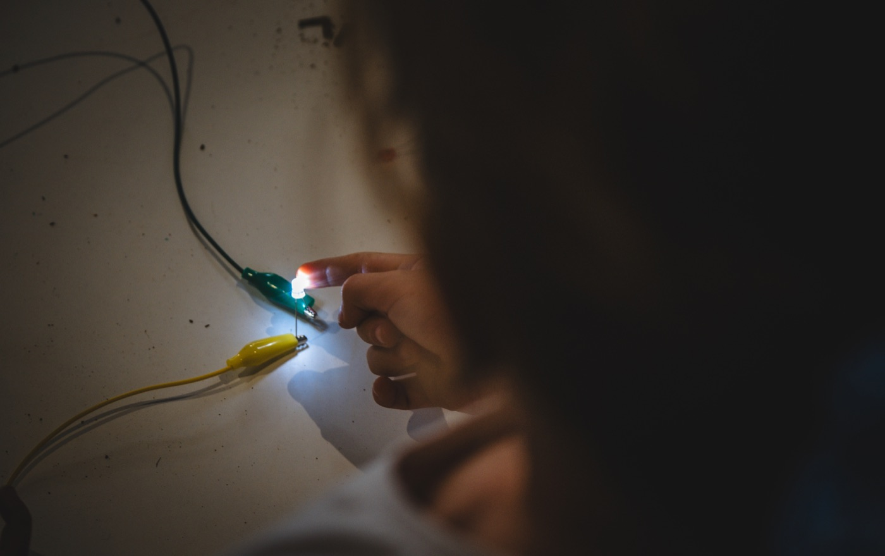
docs/site/img/alface/osso-13.jpg
