steam228/GROUU/docs/site/img/alface/osso-14.jpg

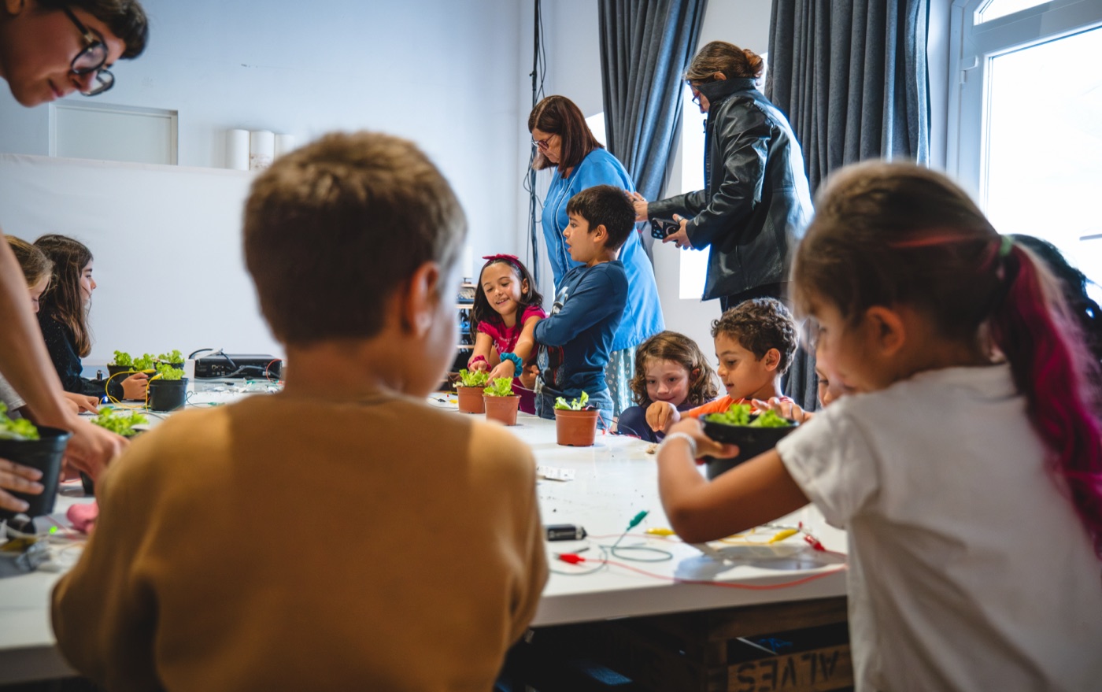
docs/site/img/alface/osso-14.jpg
