steam228/GROUU/docs/site/img/basic-node/node.jpg

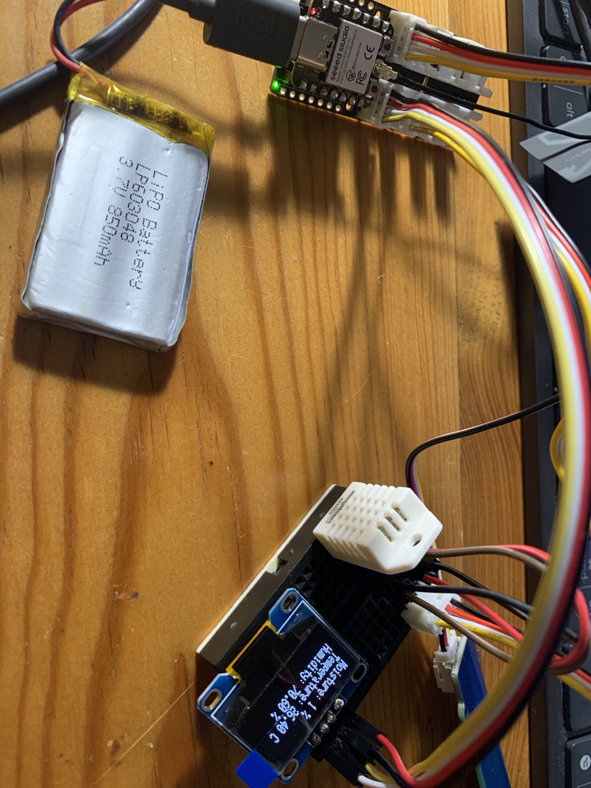
docs/site/img/basic-node/node.jpg
