steam228/GROUU/docs/site/img/basic-node/sketch.jpg

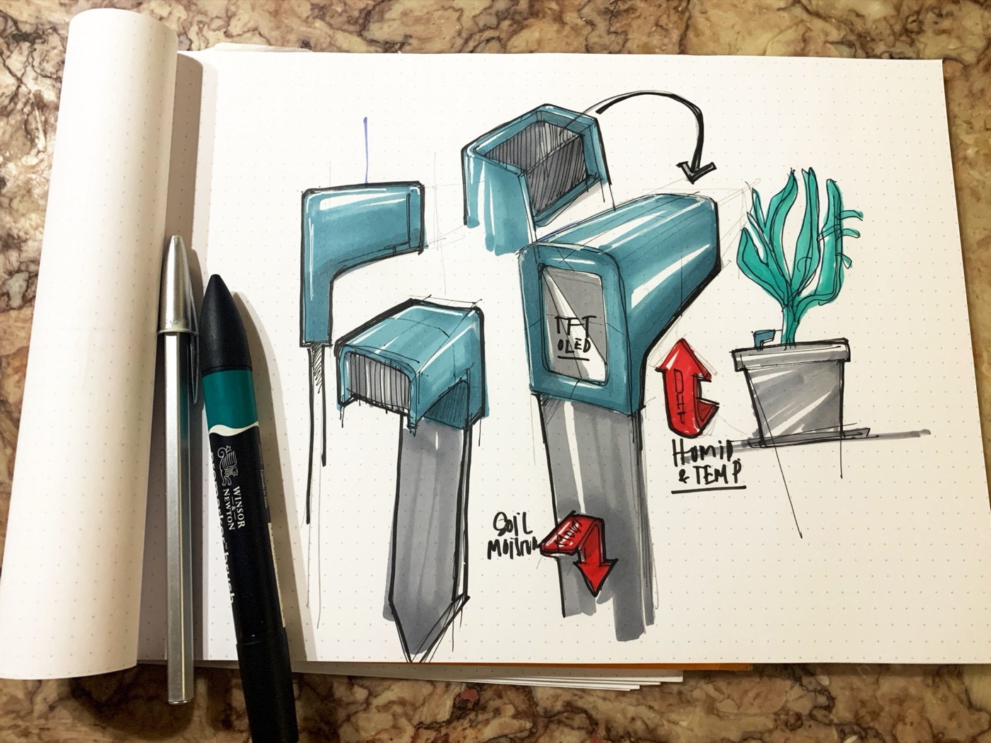
docs/site/img/basic-node/sketch.jpg
