steam228/GROUU/docs/site/img/nursery/3d.jpg

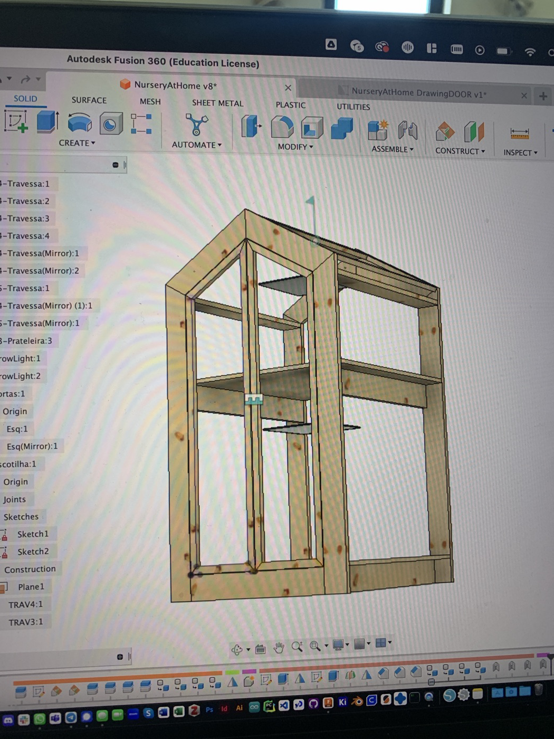
docs/site/img/nursery/3d.jpg
