steam228/GROUU/docs/site/img/nursery/hero.jpg

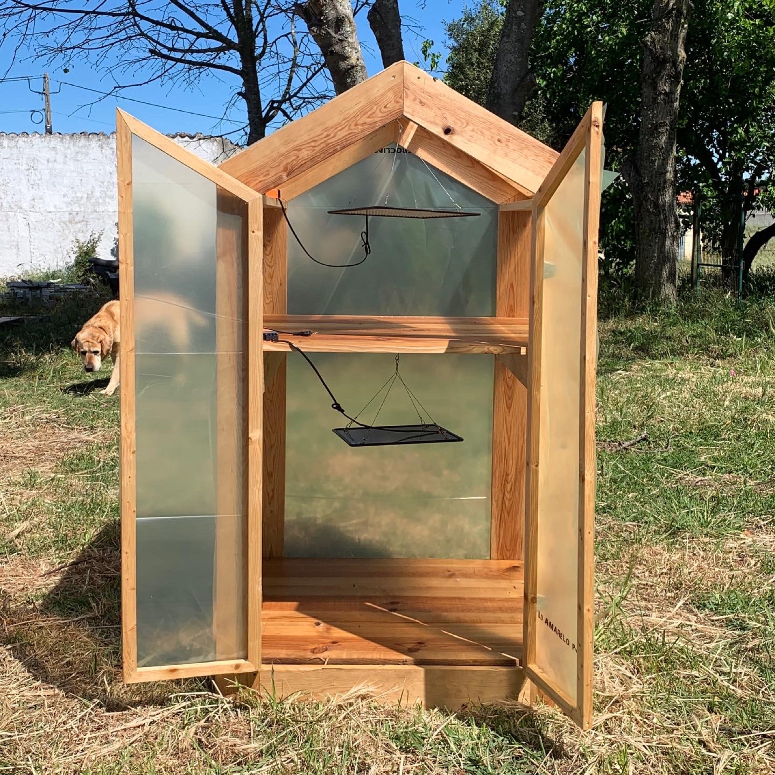
docs/site/img/nursery/hero.jpg
