steam228/GROUU/docs/site/img/server/dashboard.jpg

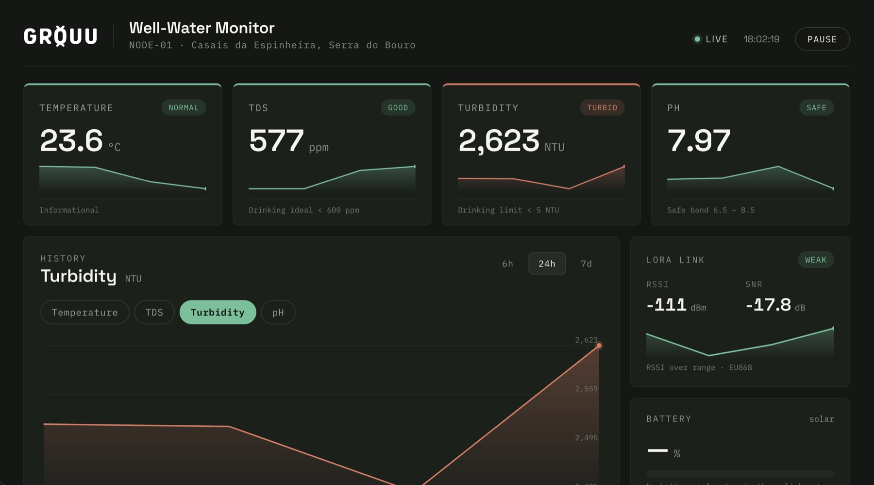
docs/site/img/server/dashboard.jpg
