steam228/GROUU/docs/site/img/v0/built2.jpg

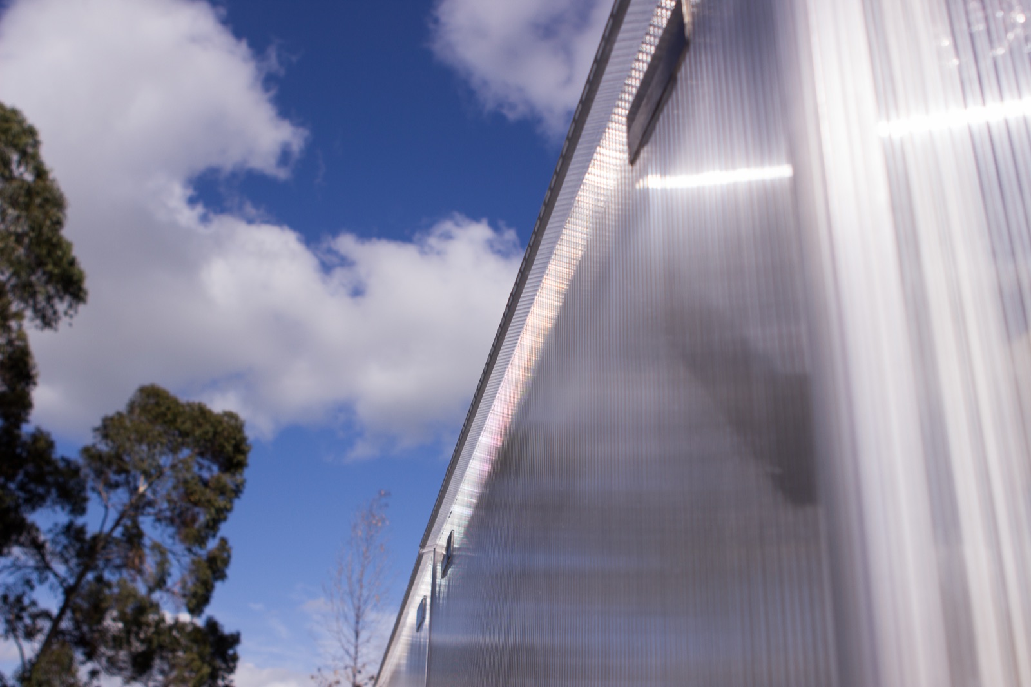
docs/site/img/v0/built2.jpg
