steam228/GROUU/docs/site/img/v0/built3.jpg

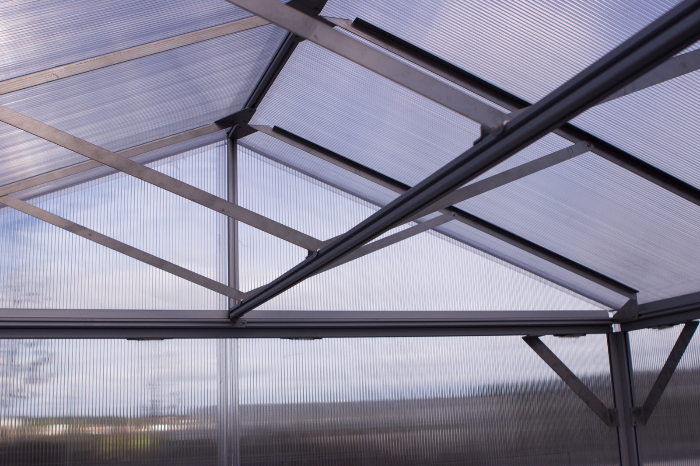
docs/site/img/v0/built3.jpg
