steam228/GROUU/docs/site/img/v0/built.jpg

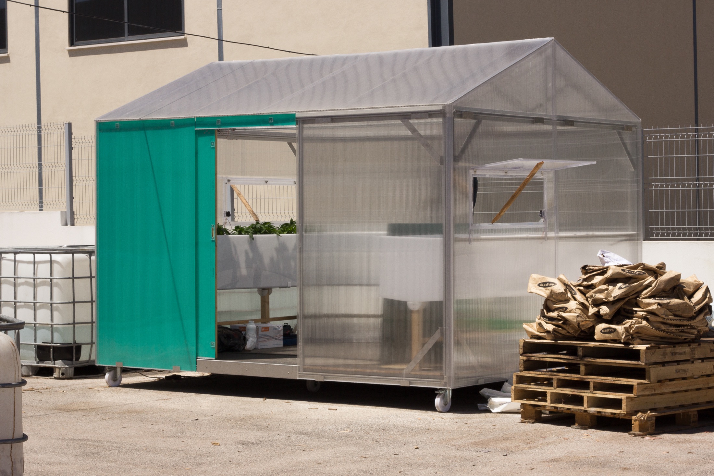
docs/site/img/v0/built.jpg
