steam228/GROUU/docs/site/img/v0/fertirrigation.jpg

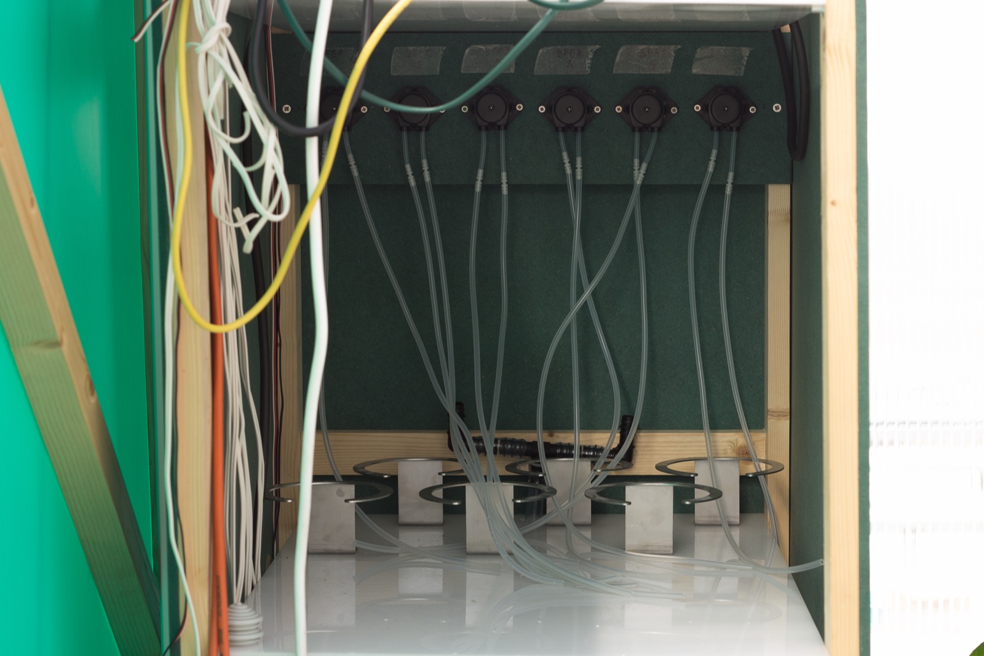
docs/site/img/v0/fertirrigation.jpg
