steam228/GROUU/docs/site/img/v0/probe2.jpg

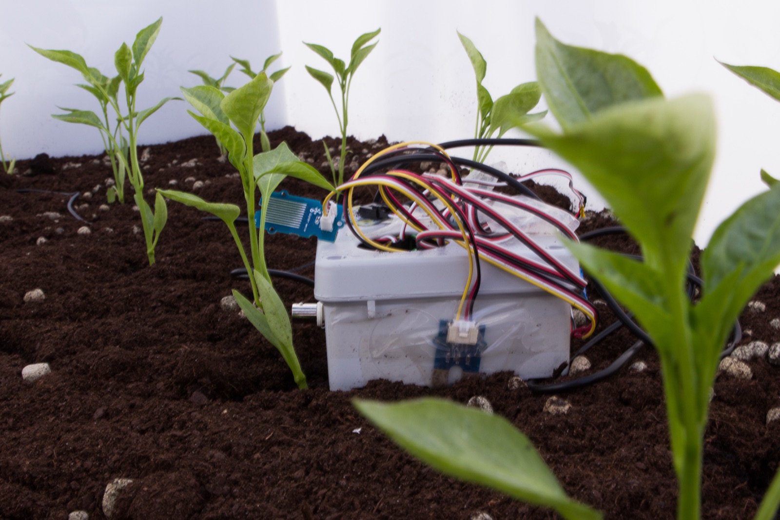
docs/site/img/v0/probe2.jpg
