steam228/GROUU/docs/site/img/v0/probe.jpg

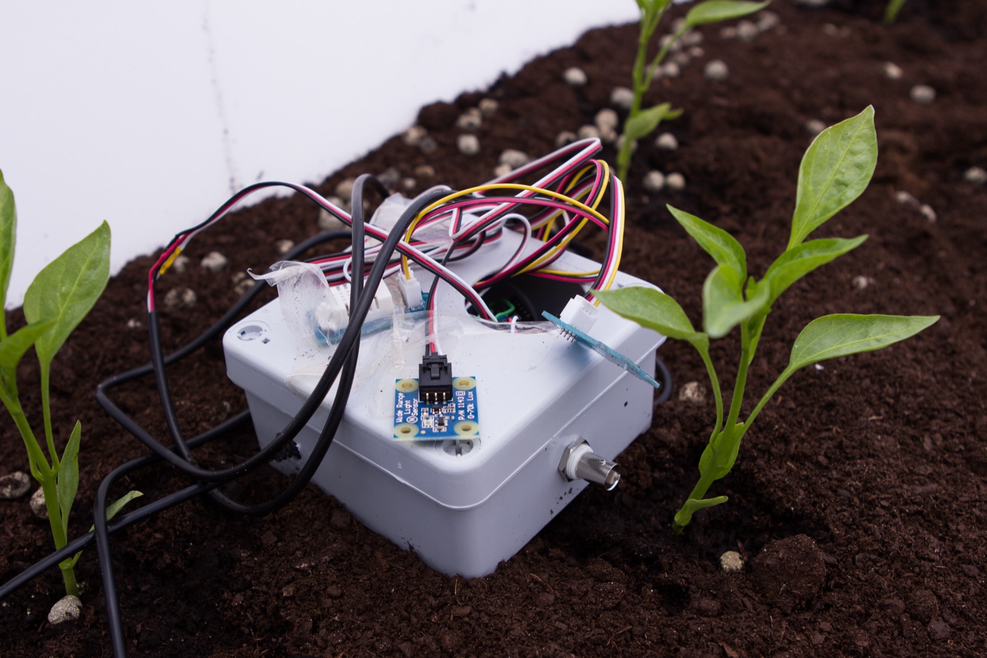
docs/site/img/v0/probe.jpg
