steam228/GROUU/docs/site/img/v0/pumps1.jpg

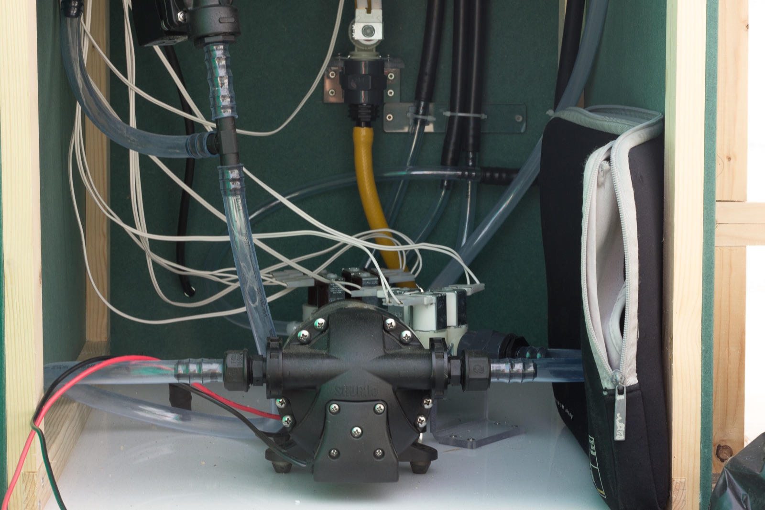
docs/site/img/v0/pumps1.jpg
