steam228/GROUU/docs/site/img/v0/raisedBeds1.jpg

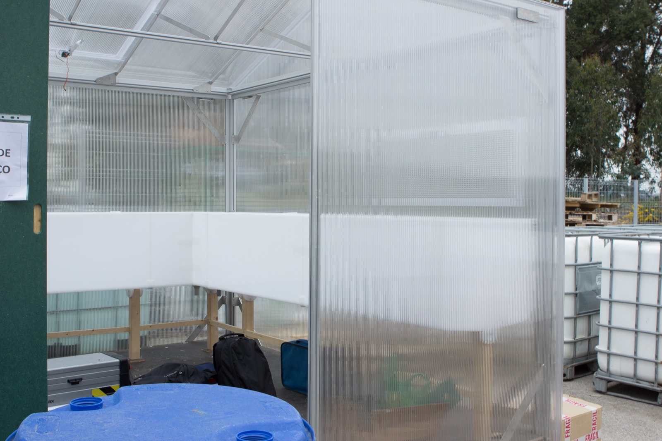
docs/site/img/v0/raisedBeds1.jpg
