steam228/GROUU/docs/site/img/v0/raisedBeds2.jpg

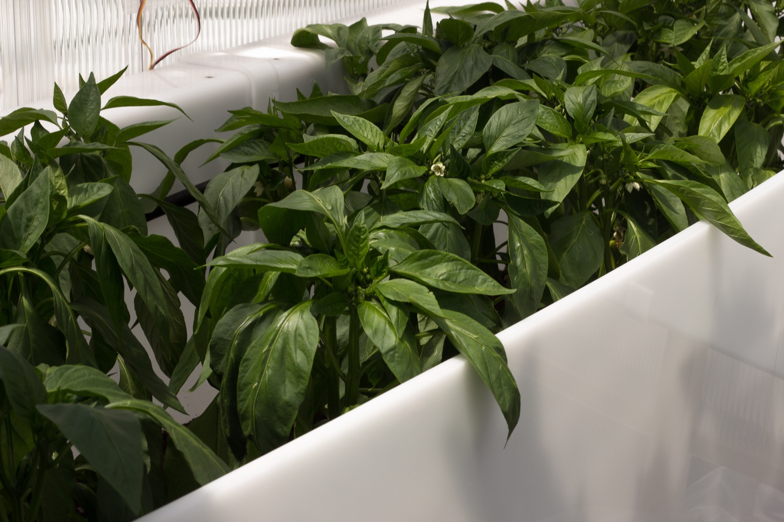
docs/site/img/v0/raisedBeds2.jpg
