steam228/GROUU/docs/site/img/v0/raisedBeds3.jpg

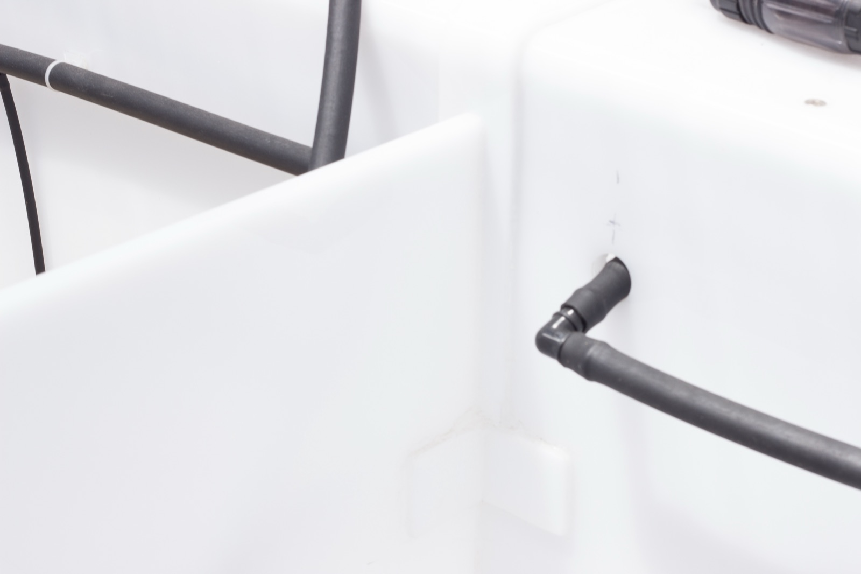
docs/site/img/v0/raisedBeds3.jpg
