steam228/GROUU/docs/site/img/v0/waterElectricityinlets.jpg

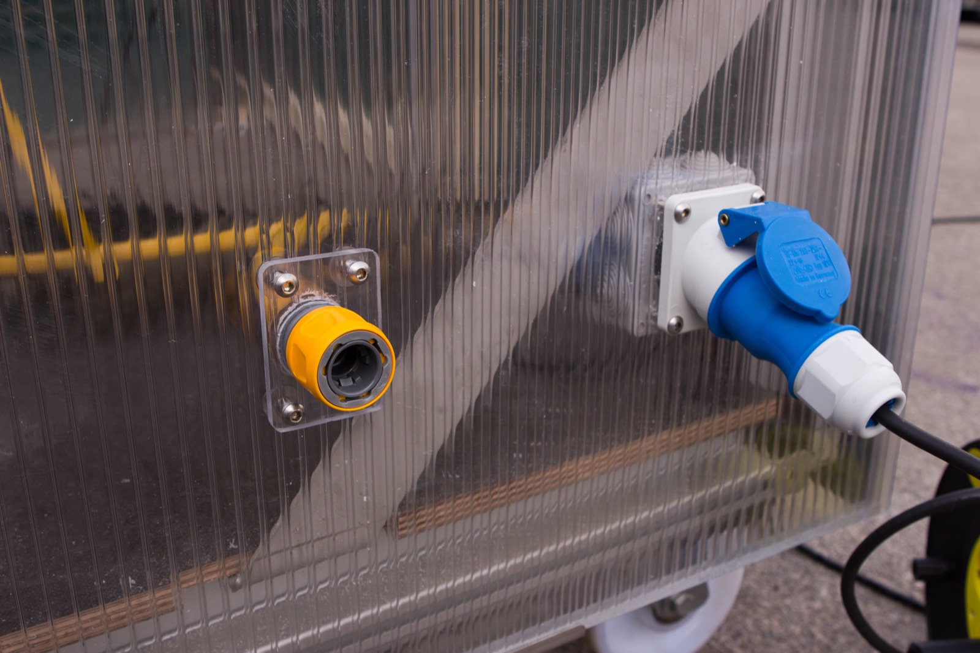
docs/site/img/v0/waterElectricityinlets.jpg
