steam228/GROUU/docs/site/img/v0/window1.jpg

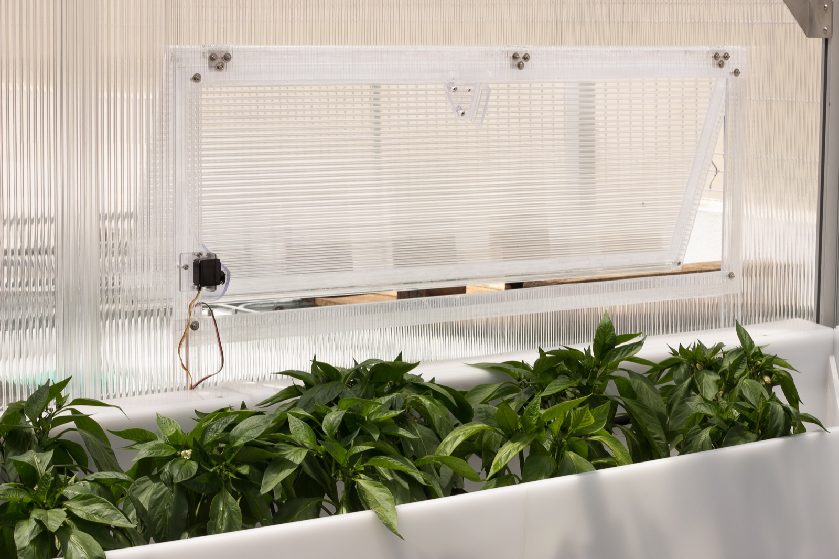
docs/site/img/v0/window1.jpg
