steam228/GROUU/docs/site/img/v0/window2.jpg

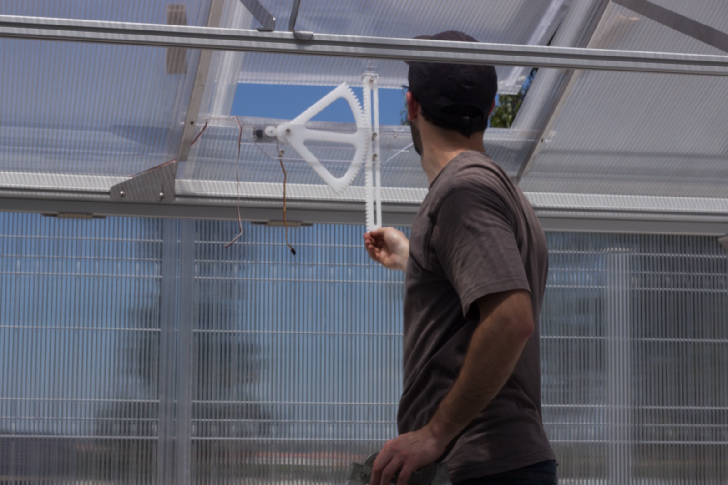
docs/site/img/v0/window2.jpg
