steam228/GROUU/docs/site/img/v0/yuncontrolUnit.jpg

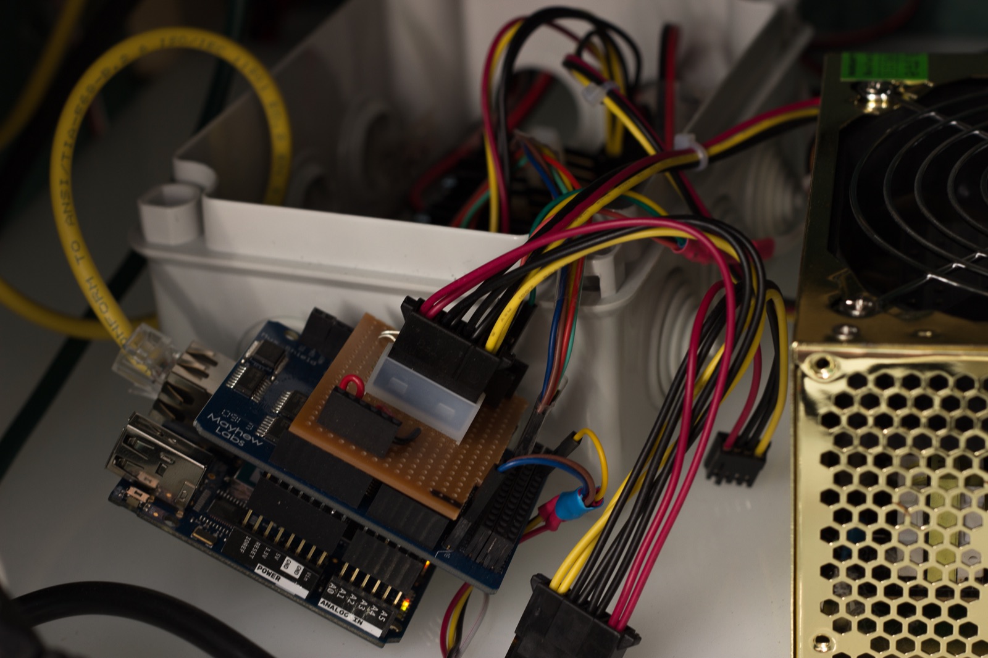
docs/site/img/v0/yuncontrolUnit.jpg
