steam228/GROUU/docs/site/img/wellbouy-board.png

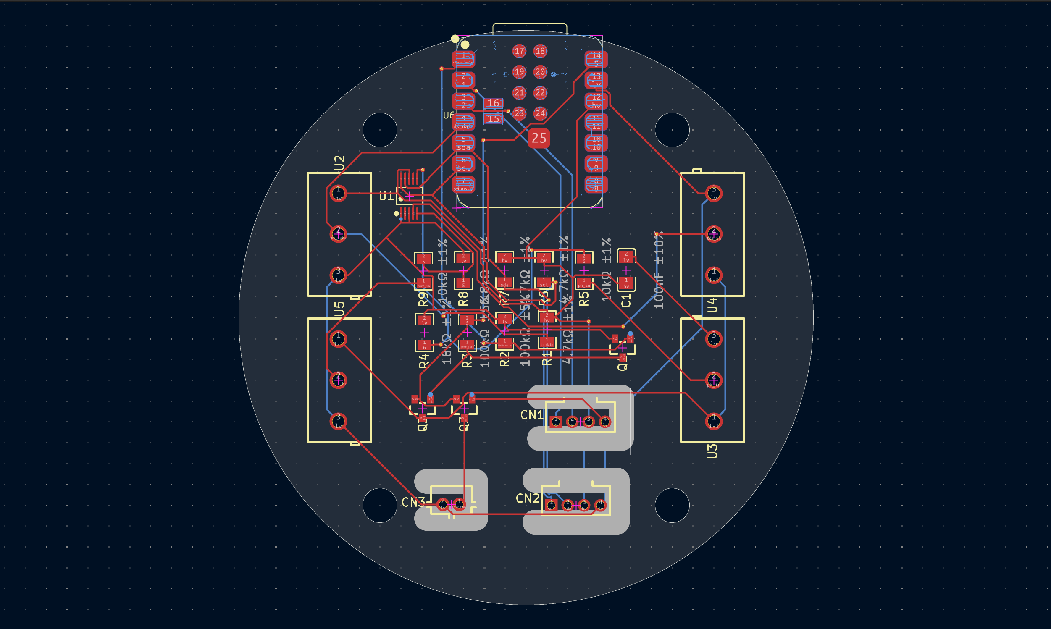
docs/site/img/wellbouy-board.png
