steam228/GROUU/docs/site/img/wellbouy/turbidity-sensor-open.jpg

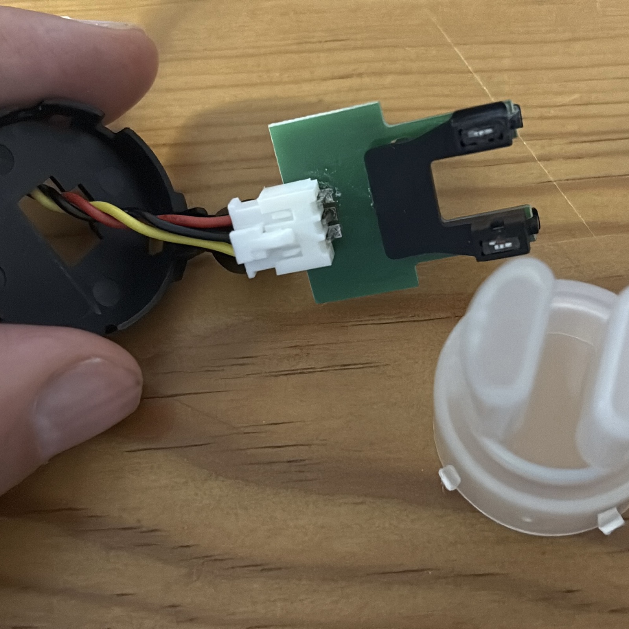
docs/site/img/wellbouy/turbidity-sensor-open.jpg
