steam228/GROUU/images/grouuPlants.png

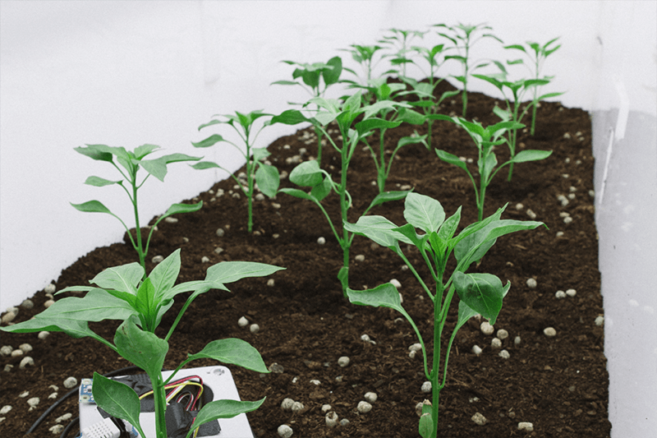
images/grouuPlants.png
