steam228/GROUU/images/IMG_0813.JPG

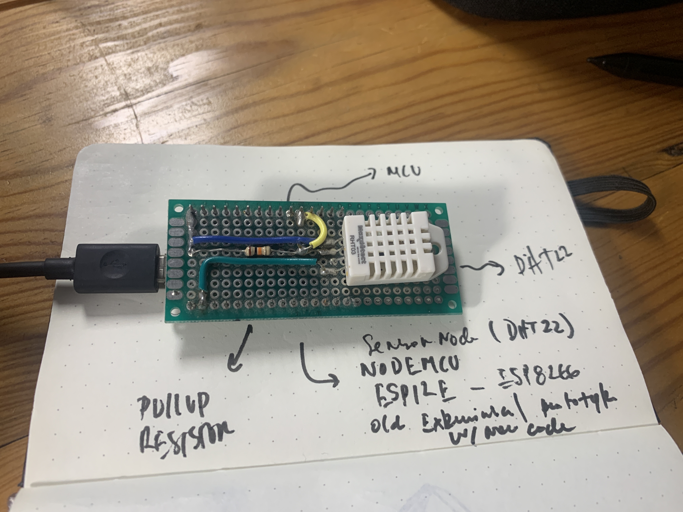
images/IMG_0813.JPG
