steam228/GROUU/images/jlcpcbBoards.jpg

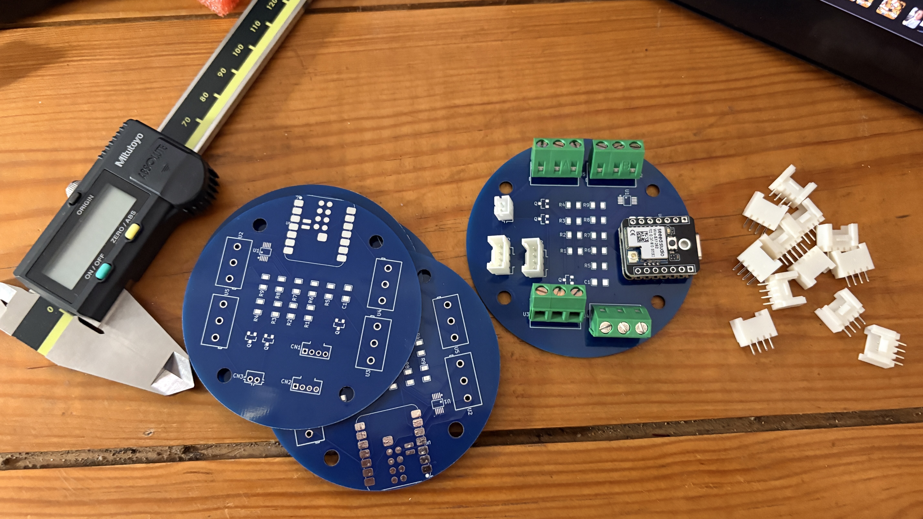
images/jlcpcbBoards.jpg
