steam228/GROUU/images/pcb1_2026-Jul-10_08-50-04PM-000_CustomizedView73725708349_jpg.jpg

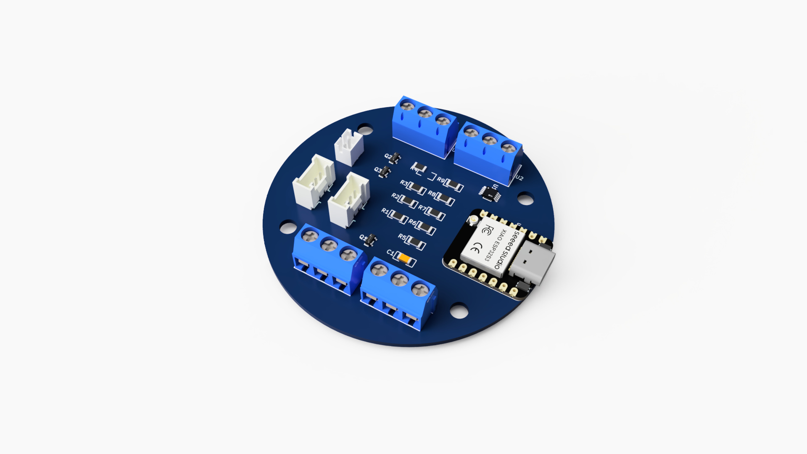
images/pcb1_2026-Jul-10_08-50-04PM-000_CustomizedView73725708349_jpg.jpg
