steam228/GROUU/images/pHCallibration.jpg

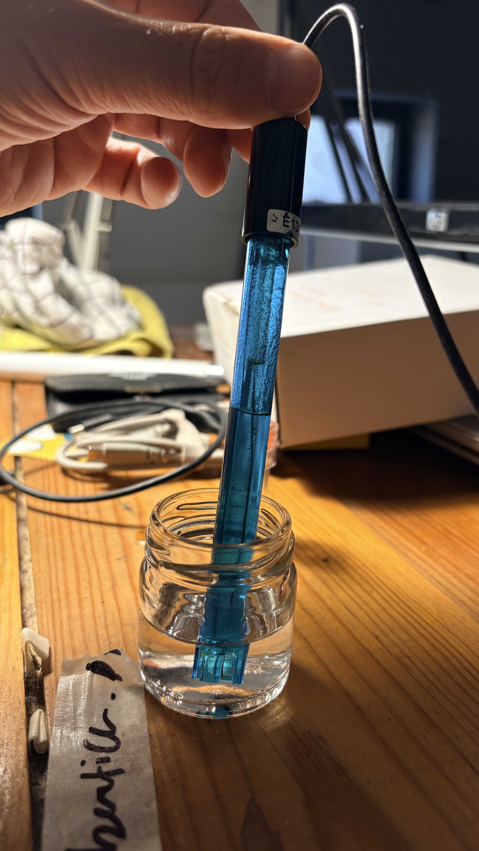
images/pHCallibration.jpg
