steam228/GROUU/images/sketch.jpg

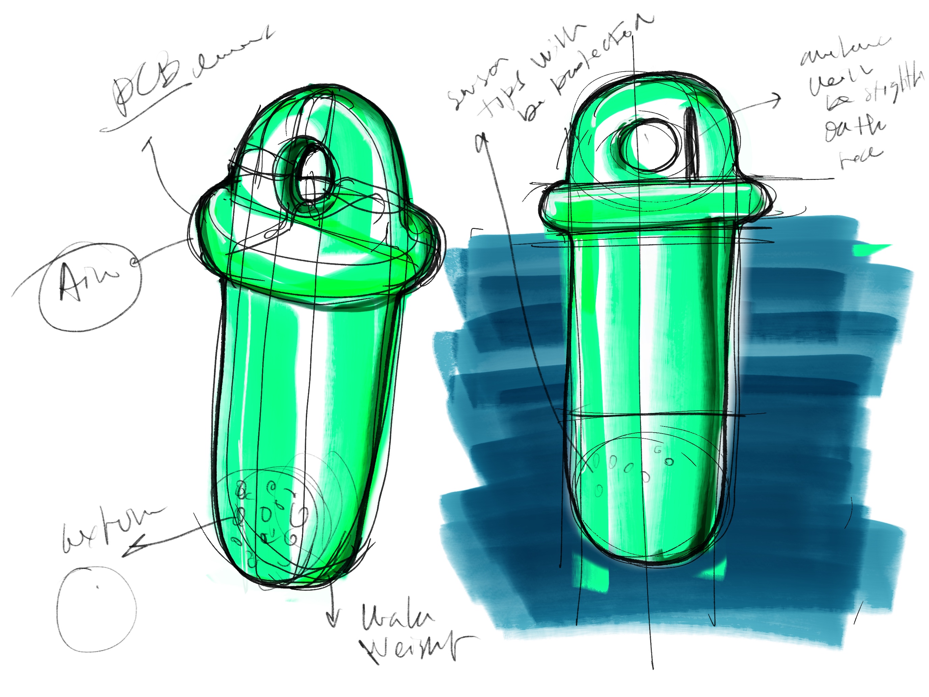
images/sketch.jpg
