steam228/GROUU/WORKSHOPS/AAlfaceOHM/Osso-Labirintos-WKS/imagens/555Metro001(1).png

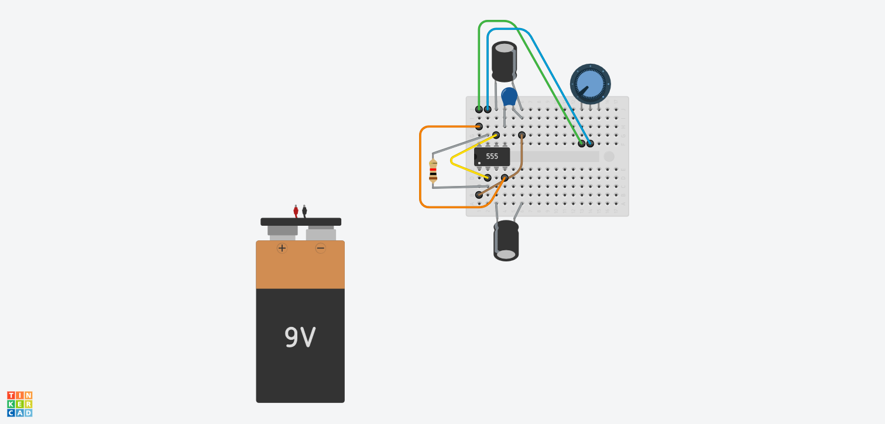
WORKSHOPS/AAlfaceOHM/Osso-Labirintos-WKS/imagens/555Metro001(1).png
