steam228/GROUU/WORKSHOPS/AAlfaceOHM/Osso-Labirintos-WKS/imagens/555Metro001(10).png

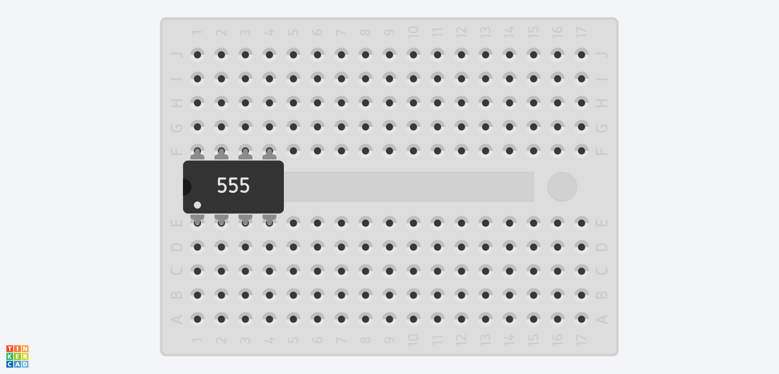
WORKSHOPS/AAlfaceOHM/Osso-Labirintos-WKS/imagens/555Metro001(10).png
