steam228/GROUU/WORKSHOPS/AAlfaceOHM/Osso-Labirintos-WKS/diagrams/03 - 555sqWaveGenV2 BOM.csv

Name | Quantity | Component
U1 | 1 | Timer
BAT1 | 1 | 9V Battery
C1, C2 | 2 | 10 uF, 16 V Polarized Capacitor
Rpot1, Rpot2 | 2 | 100 kΩ Potentiometer
PIEZO1 | 1 | Piezo
C3 | 1 | 100 nF Capacitor
