steam228/GROUU/design/3D/GROUU_V3/WellBouy/renders/components04.jpg.jpg

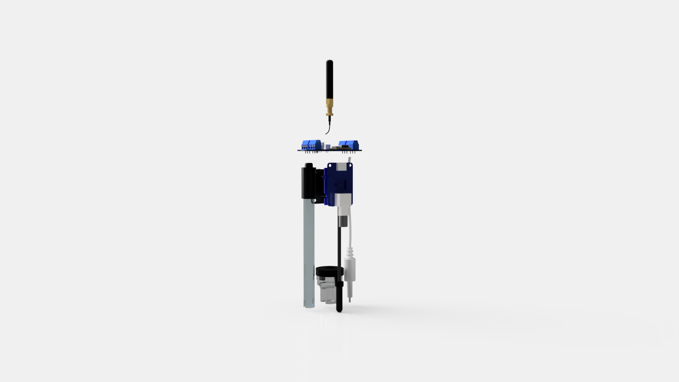
design/3D/GROUU_V3/WellBouy/renders/components04.jpg.jpg
