steam228/GROUU/design/3D/GROUU_V3/WellBouy/renders/components05.jpg.jpg

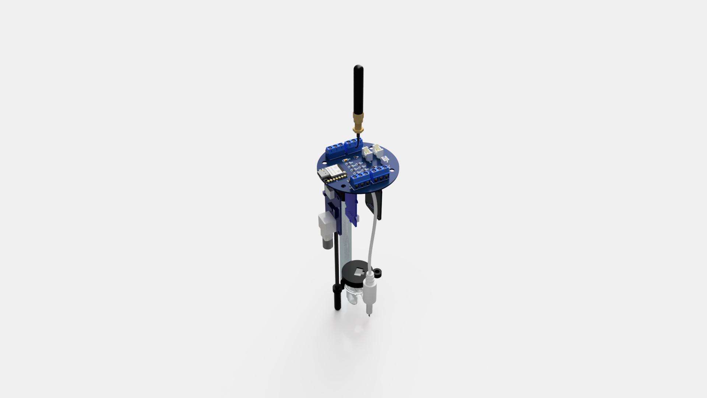
design/3D/GROUU_V3/WellBouy/renders/components05.jpg.jpg
