steam228/GROUU/docs/site/img/wellbouy/components-01.jpg

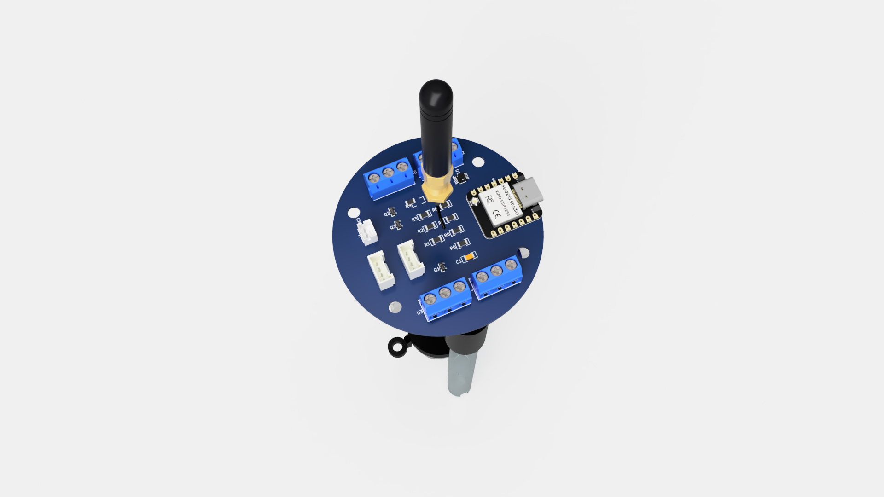
docs/site/img/wellbouy/components-01.jpg
