steam228/GROUU/docs/site/img/wellbouy/components-02.jpg

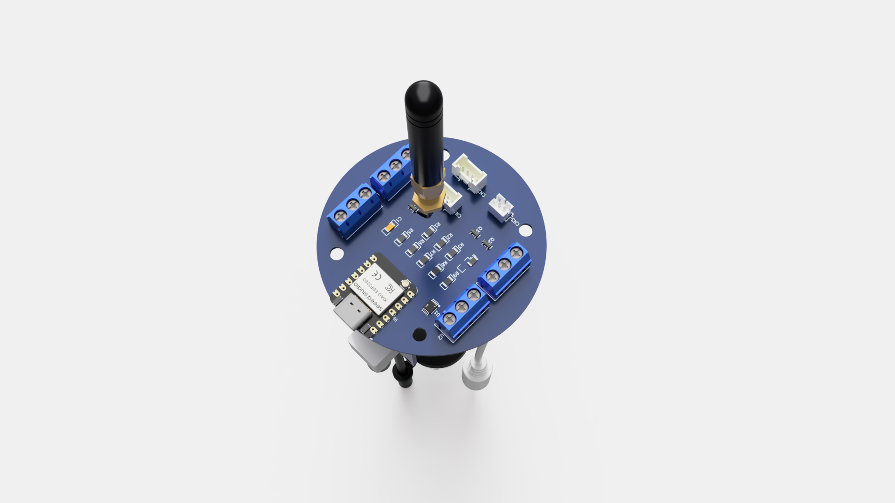
docs/site/img/wellbouy/components-02.jpg
