steam228/GROUU/ARDUINO/GROUU_V3/hardware/well-bouy01/mech/template_outline.dxf

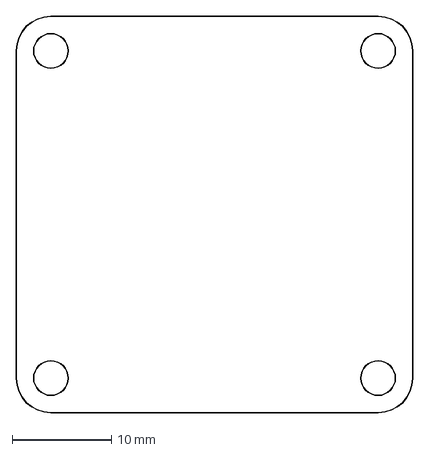
[picture p76: CAD file, 2026-07-10]
ARDUINO/GROUU_V3/hardware/well-bouy01/mech/template_outline.dxf
40.0 x 40.0 mm
