steam228/GROUU/ARDUINO/GROUU_V3/hardware/well-bouy01/mech/template_40x40.dxf

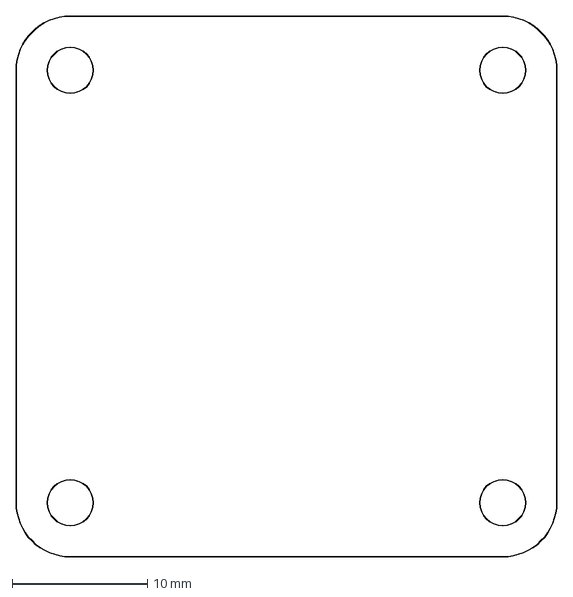
[picture p77: CAD file, 2026-07-10]
ARDUINO/GROUU_V3/hardware/well-bouy01/mech/template_40x40.dxf
40.0 x 40.0 mm
