steam228/GROUU/ARCHIVE/grouu-v0/solidworks/2013.09.28 Modelo Base de Estufa_AR.SLDASM

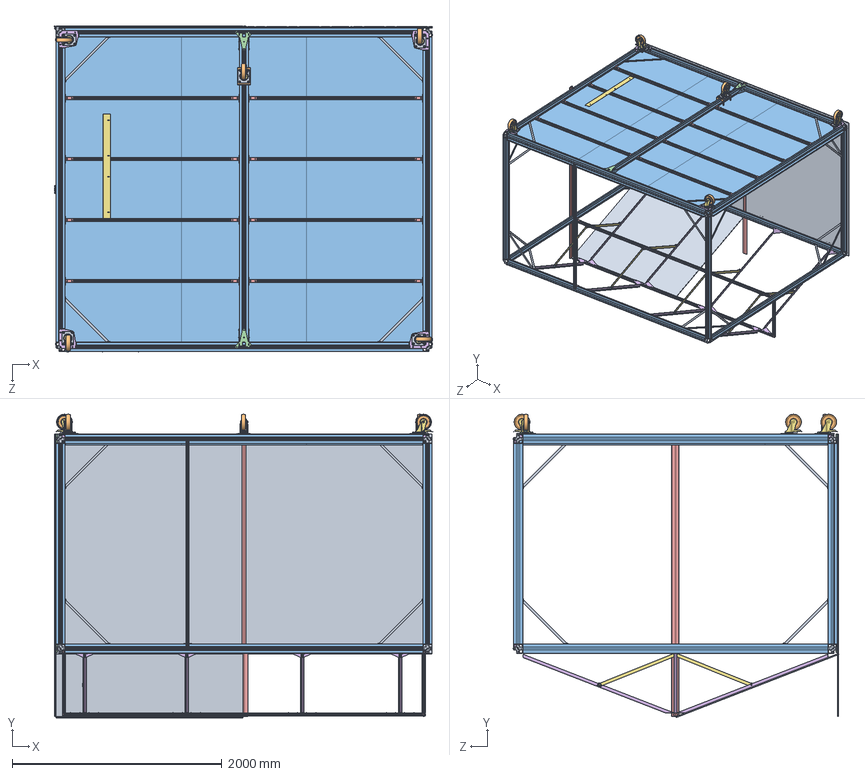
[picture p78: CAD file, 2026-07-17, an earlier design]
ARCHIVE/grouu-v0/solidworks/2013.09.28 Modelo Base de Estufa_AR.SLDASM
3605.4 x 2895.4 x 3109.3 mm
EXT1.C1 x 81
socket button head screw_iso x 340
EXT1.X x 52
E.3.1 CASQUILHO KERB x 104
spring pin slotted_hd_iso x 104
E1.X x 65
E1.CA x 112
E.3.3 PORCA DE CANAL x 200
EXT1.CC.1.A x 24
EXT1.CC.1.B x 48
EXT1.C2.1 x 4
EXT1.C2.2 x 2
EXT1.TAE1 x 20
EXT1.WFS.1 x 4
Suporte x 5
socket thin pilot cap screw_din x 16
prevailing torque nut thin insert_din x 16
E1.C1 x 4
Reforço de águas x 8
Reforço de águas II x 8
hex nut gradec_iso x 8
LT2UV102RS17_lateral1 x 3
EXT1.WFS.2
Pavimento Estufa x 6
BWF ESX108
BWF HSX108 x 2
Suporte150LEXAN
Suporte1000LEXAN
