steam228/GROUU/ARCHIVE/grouu-v0/solidworks/Dependencies/E1 ESYS + 2x E3.1.SLDASM

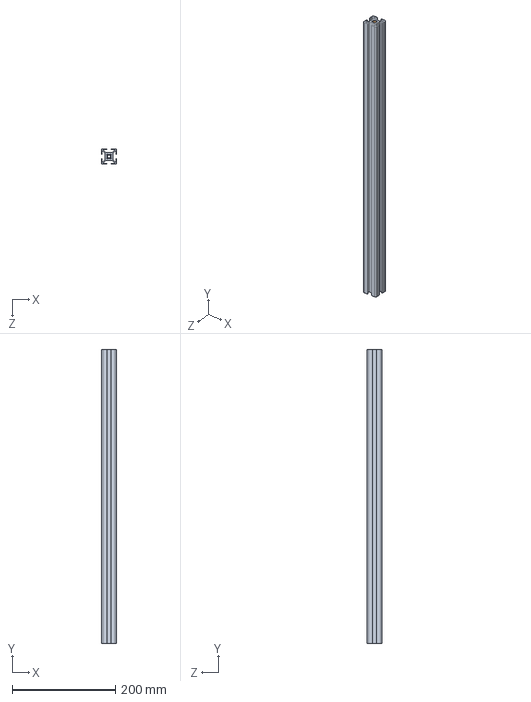
[picture p79: CAD file, 2026-07-17, an earlier design]
ARCHIVE/grouu-v0/solidworks/Dependencies/E1 ESYS + 2x E3.1.SLDASM
30.0 x 570.0 x 30.0 mm
E.1 ESYS
E.3.1 CASQUILHO KERB x 2
