steam228/GROUU/ARCHIVE/grouu-v0/solidworks/Detached Modules/2014.03.24 Conjunto Lateral - ELIPSE pequena/2014.03.24 Conjunto Lateral - ELIPSE pequena.SLDASM

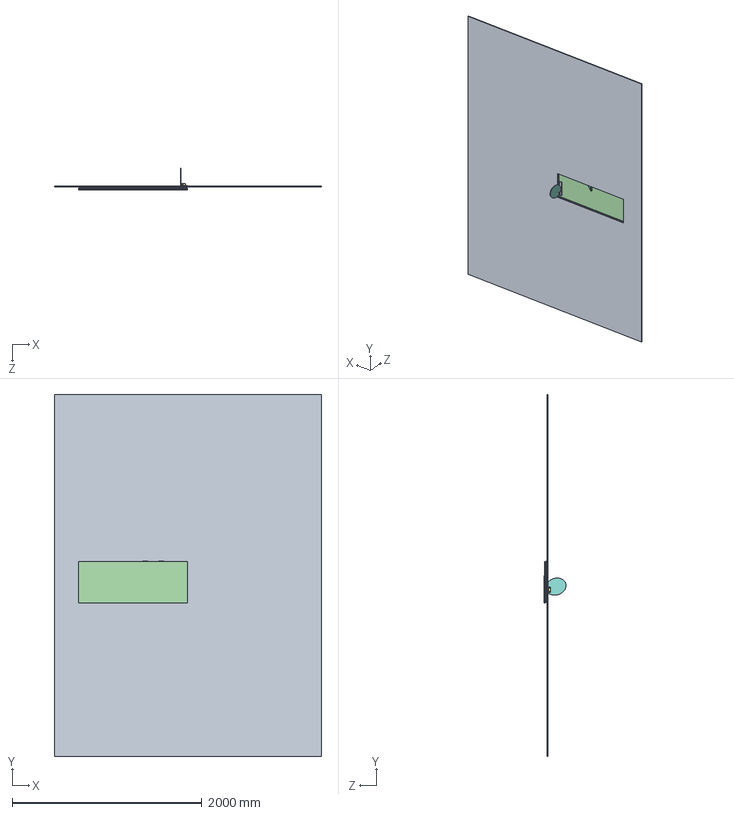
[picture p80: CAD file, 2026-07-17, an earlier design]
ARCHIVE/grouu-v0/solidworks/Detached Modules/2014.03.24 Conjunto Lateral - ELIPSE pequena/2014.03.24 Conjunto Lateral - ELIPSE pequena.SLDASM
2818.8 x 3815.6 x 233.8 mm
2014.02.26 PC lateral
2014.02.26 Suport LEXAN (lateral)
2014.02.26 Suport LEXAN (escotilha)
2014.02.26 PC Escotilha
2014.02.25 Dobradiça x 4
2014.03.24 Apoio Motor Lateral
2014.02.26 motor
2014.03.24 ELIPSE motor
2014.03.24 Batente Janela
