steam228/GROUU/ARCHIVE/grouu-v0/solidworks/Detached Modules/2014.04.22 Conjunto Escotilha - simples/2014.04.22 Conjunto Escotilha - simples.SLDASM

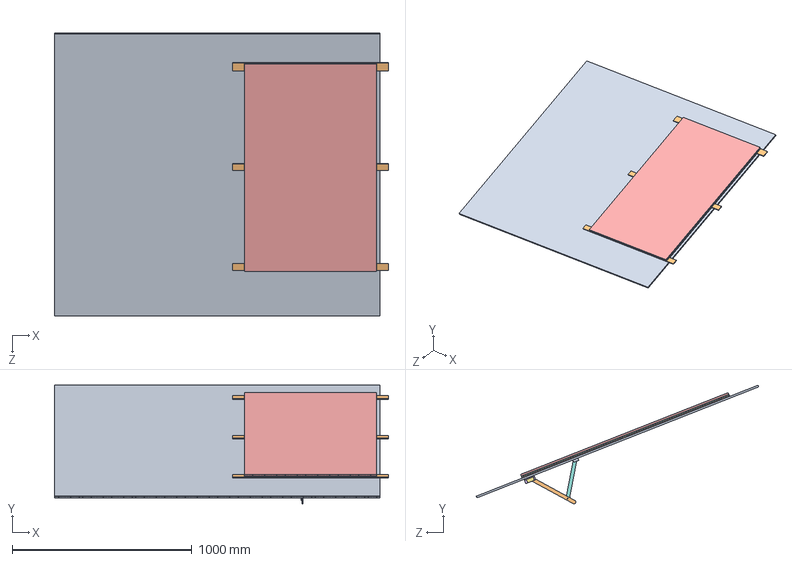
[picture p81: CAD file, 2026-07-17, an earlier design]
ARCHIVE/grouu-v0/solidworks/Detached Modules/2014.04.22 Conjunto Escotilha - simples/2014.04.22 Conjunto Escotilha - simples.SLDASM
1856.0 x 659.3 x 1570.0 mm
2014.04.22 Placa Lexan Telhado
2014.04.22 PC tecto
2014.04.22 Dobradiça x 4
2014.04.22 PC escotilha
2014.04.22 Placa Lexan escotilha
2014.02.25 Apoio Motor
2014.02.26 motor
2014.04.22 Alavanca
2014.04.22 Apoio Alavanca
2014.04.22 Alavanca - batente
