steam228/GROUU/ARCHIVE/grouu-v0/solidworks/Detached Modules/2014.05.05 Cremalheira/2014.05.05 Cremalheira.SLDASM

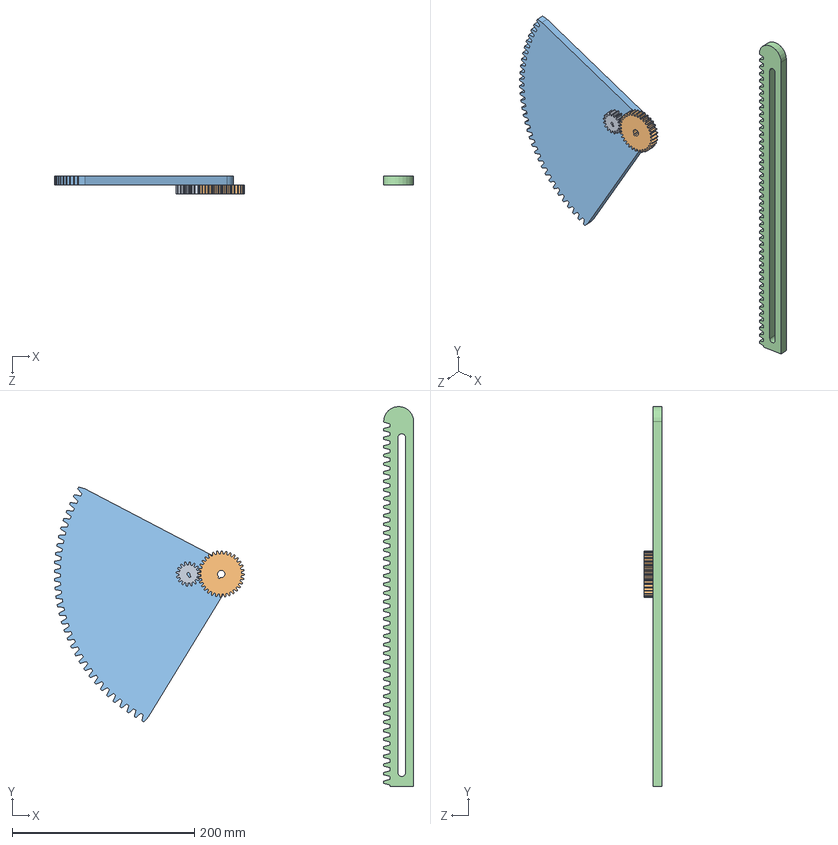
[picture p82: CAD file, 2026-07-17, an earlier design]
ARCHIVE/grouu-v0/solidworks/Detached Modules/2014.05.05 Cremalheira/2014.05.05 Cremalheira.SLDASM
394.0 x 416.5 x 20.0 mm
2014.05.05 roda pequena
2014.05.05 roda grande
2014.05.05 Roda cremalheira
2014.05.05 rack spur
