steam228/GROUU/ARCHIVE/grouu-v0/solidworks/Detached Modules/2014.05.05 Cremalheira/Dependencies/2014.04.23 Gear.SLDASM

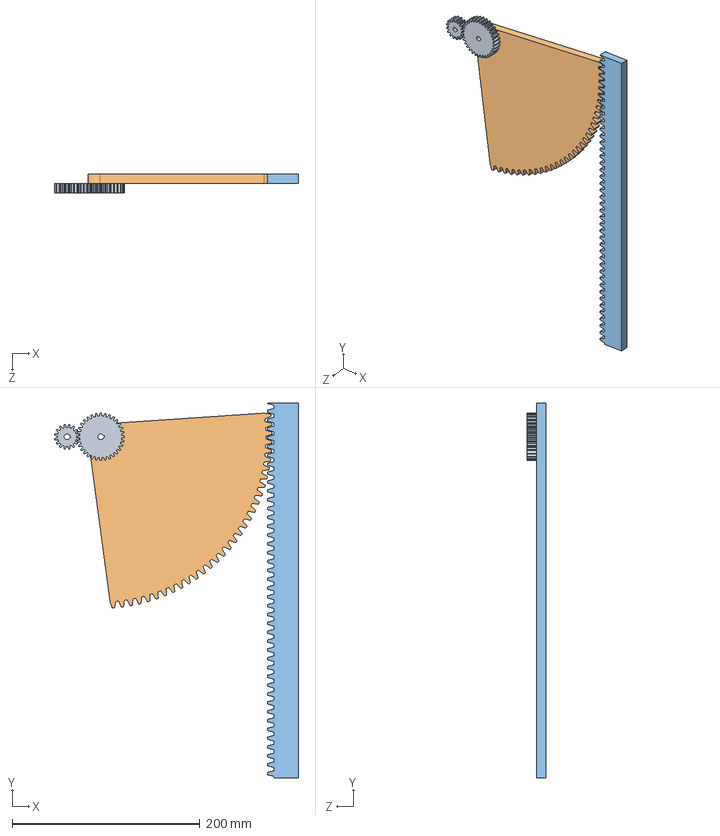
[picture p83: CAD file, 2026-07-17, an earlier design]
ARCHIVE/grouu-v0/solidworks/Detached Modules/2014.05.05 Cremalheira/Dependencies/2014.04.23 Gear.SLDASM
260.3 x 400.0 x 20.0 mm
spur gear_iso x 2
2014.04.24 Roda 90º
rack spur rectangular_iso
