steam228/GROUU/ARCHIVE/grouu-v0/solidworks/Detached Modules/2014.05.09 Conjunto Cremalheira/2014.05.09 Conjunto Cremalheira.SLDASM

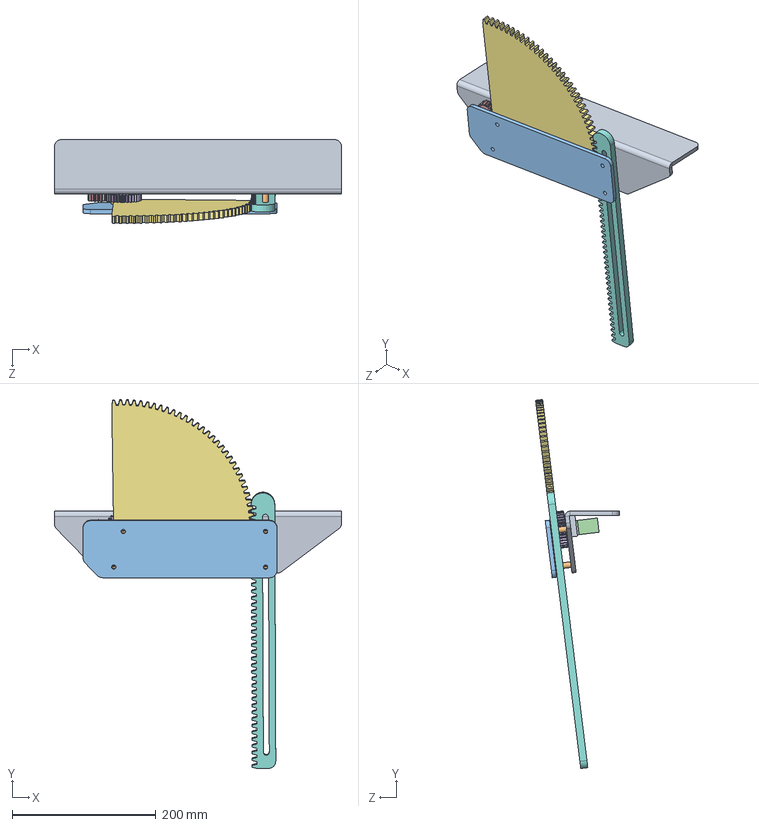
[picture p84: CAD file, 2026-07-17, an earlier design]
ARCHIVE/grouu-v0/solidworks/Detached Modules/2014.05.09 Conjunto Cremalheira/2014.05.09 Conjunto Cremalheira.SLDASM
400.0 x 513.8 x 116.9 mm
2014.05.09 Apoio Cremalheira
2014.05.09 Tubo Latão x 4
2014.05.09 Tampa Cremalheira
2014.02.26 motor
2014.05.05 roda pequena
2014.05.05 roda grande
2014.05.05 Roda cremalheira
2014.05.05 rack spur
2014.05.09 Pino Motor x 2
