steam228/GROUU/ARCHIVE/grouu-v0/solidworks/Detached Modules/Esteretoromia do Pavimento/Esteretoromia do Pavimento.SLDASM

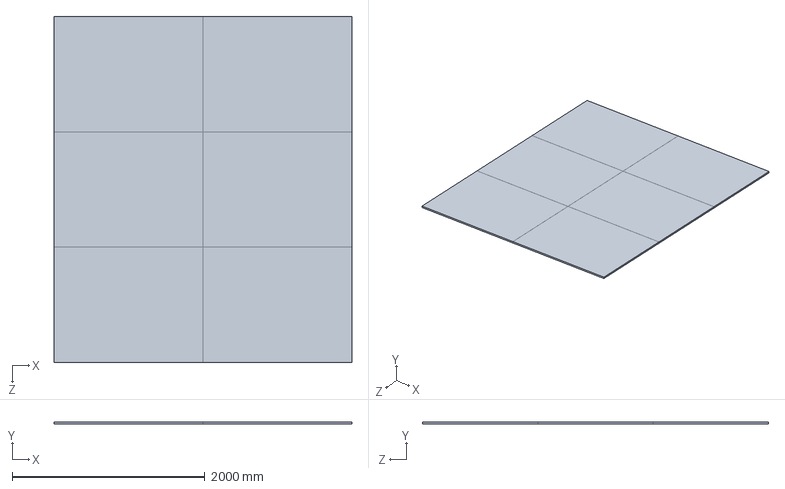
[picture p85: CAD file, 2026-07-17, an earlier design]
ARCHIVE/grouu-v0/solidworks/Detached Modules/Esteretoromia do Pavimento/Esteretoromia do Pavimento.SLDASM
3089.0 x 22.0 x 3589.1 mm
Pavimento 1Unid x 6
