steam228/GROUU/ARCHIVE/grouu-v0/solidworks/Detached Modules/Estudos para Raised beds/Dependencies/Travessa Tipo ESYS Pre-Assembled.SLDASM

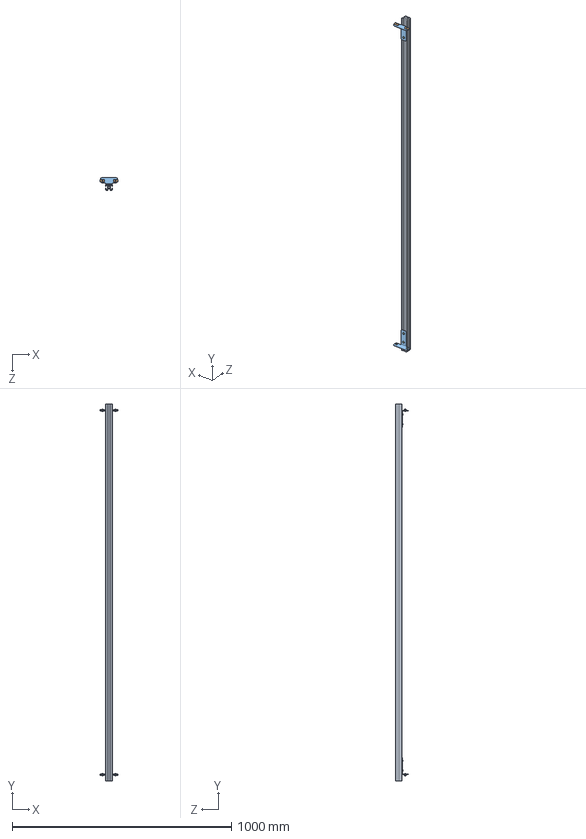
[picture p86: CAD file, 2026-07-17, an earlier design]
ARCHIVE/grouu-v0/solidworks/Detached Modules/Estudos para Raised beds/Dependencies/Travessa Tipo ESYS Pre-Assembled.SLDASM
80.0 x 1720.0 x 60.0 mm
E1.X
E.3.3 PORCA DE CANAL x 8
EXT1.TAE1 x 2
socket button head screw_iso x 8
