steam228/GROUU/ARCHIVE/grouu-v0/solidworks/Detached Modules/Estudos para Raised beds/Dependencies/E1.X.SLDASM

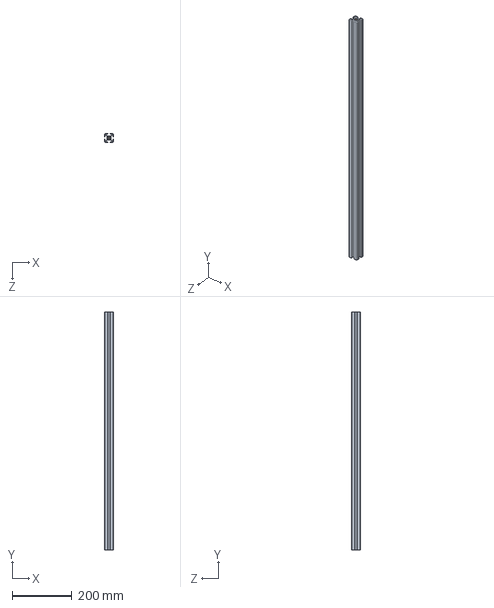
[picture p87: CAD file, 2026-07-17, an earlier design]
ARCHIVE/grouu-v0/solidworks/Detached Modules/Estudos para Raised beds/Dependencies/E1.X.SLDASM
30.0 x 800.0 x 30.0 mm
E1.X
E1.CA x 2
