steam228/GROUU/ARCHIVE/grouu-v0/solidworks/Detached Modules/Estudos para Raised beds/Dependencies/Esttufa Base 3000x3500x2500.SLDASM

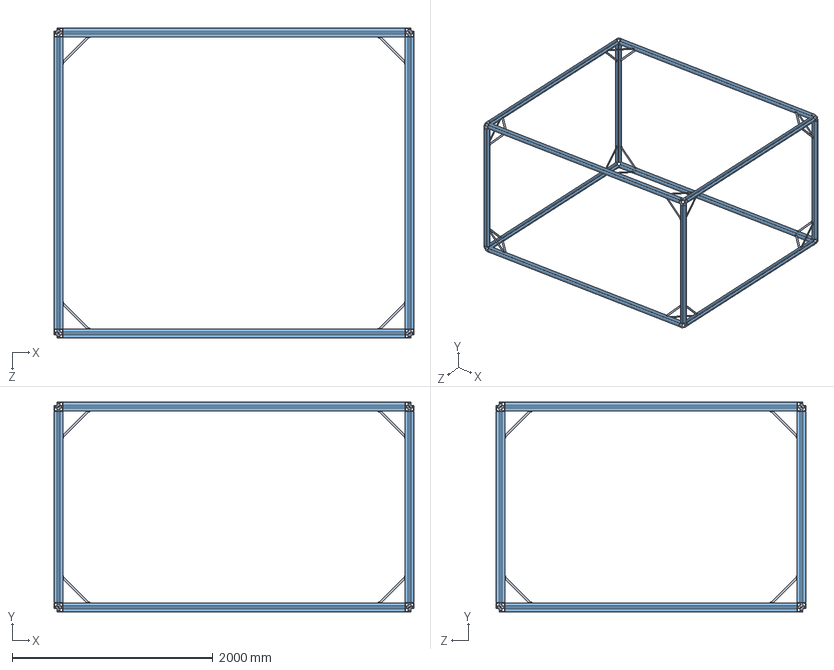
[picture p88: CAD file, 2026-07-17, an earlier design]
ARCHIVE/grouu-v0/solidworks/Detached Modules/Estudos para Raised beds/Dependencies/Esttufa Base 3000x3500x2500.SLDASM
3590.9 x 2090.9 x 3090.9 mm
EXT1.C1 x 81
socket button head screw_iso x 160
EXT1.X x 48
E.3.1 CASQUILHO KERB x 96
spring pin slotted_hd_iso x 96
E1.X x 48
E1.CA x 96
E.3.3 PORCA DE CANAL x 48
EXT1.CC.1.A x 24
EXT1.CC.1.B x 48
