steam228/GROUU/ARCHIVE/grouu-v0/solidworks/Detached Modules/Estudos para Raised beds/Dependencies/Modelo Base de Estufa.SLDASM

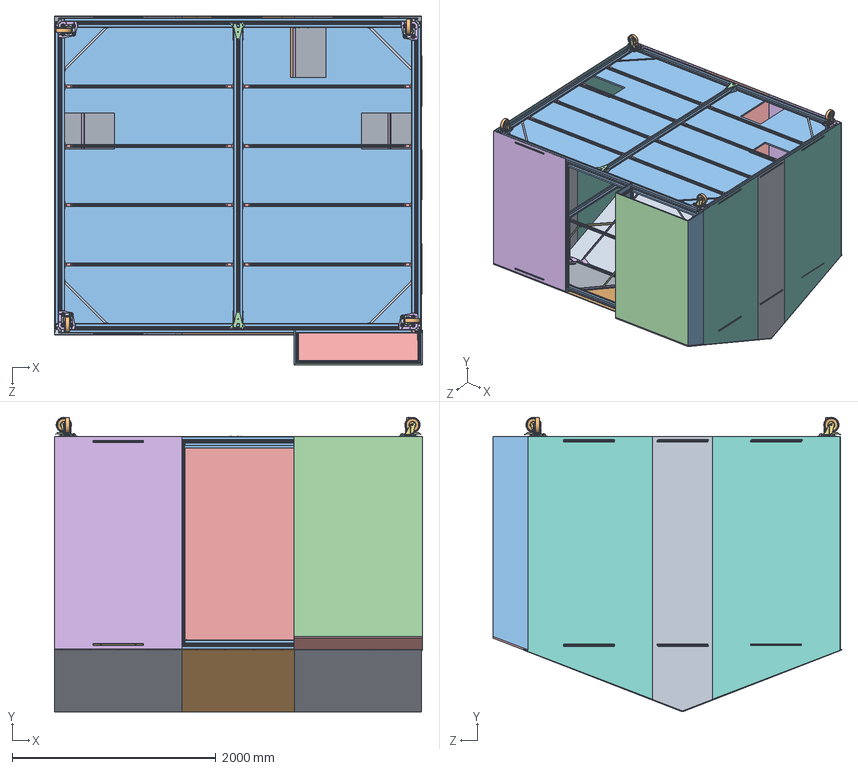
[picture p89: CAD file, 2026-07-17, an earlier design]
ARCHIVE/grouu-v0/solidworks/Detached Modules/Estudos para Raised beds/Dependencies/Modelo Base de Estufa.SLDASM
3615.5 x 2893.5 x 3428.4 mm
EXT1.C1 x 81
socket button head screw_iso x 396
EXT1.X x 52
E.3.1 CASQUILHO KERB x 104
spring pin slotted_hd_iso x 104
E1.X x 75
E1.CA x 130
E.3.3 PORCA DE CANAL x 251
EXT1.CC.1.A x 24
EXT1.CC.1.B x 48
EXT1.C2.1 x 4
EXT1.C2.2 x 2
EXT1.TAE1 x 24
EXT1.WFS.1 x 4
Suporte x 4
socket thin pilot cap screw_din x 16
prevailing torque nut thin insert_din x 16
LT2UV82RS15 LEXAN PARA ESTUFAS SUBCONFIGS ii
LT2UV82RS15 LEXAN PARA ESTUFAS SUBCONFIGS x 3
EXT1.LEXAN8MM.1 x 18
LT2UV82RS15 LEXAN PARA ESTUFAS SUBCONFIGS iv ag x 4
LT2UV82RS15 LEXAN PARA ESTUFAS SUBCONFIGS iii x 2
E1.C1 x 10
VISA MULTIWALL cx exterior - lateral x 2
WISA MULTIWALL cx exterior -frente
WISA MULTIWALL cx exterior -agua
Reforço de águas x 8
Reforço de águas II x 8
hex nut gradec_iso x 8
LT2UV82RS15 LEXAN PARA ESTUFAS SUBCONFIGS Telhado i x 4
LT2UV82RS15 LEXAN PARA ESTUFAS SUBCONFIGS Telhado ii x 2
WISA - Multifloor
