steam228/GROUU/ARCHIVE/grouu-v0/solidworks/Detached Modules/2014.03.24 Conjunto Lateral - ELIPSE pequena/Dependencies/2014.02.26 Conjunto escotilha Lateral.SLDASM

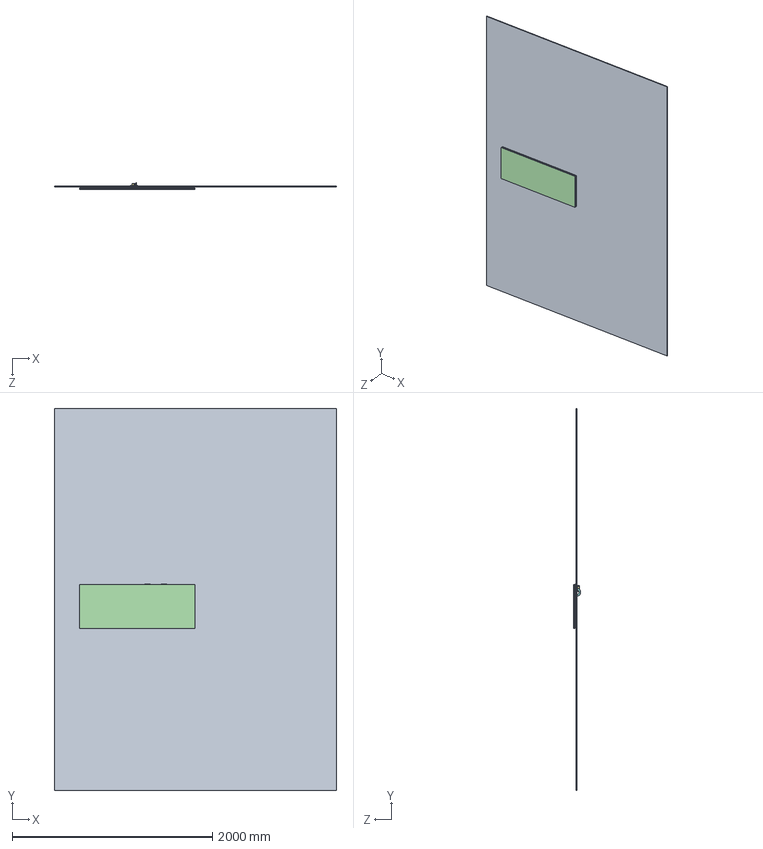
[picture p90: CAD file, 2026-07-17, an earlier design]
ARCHIVE/grouu-v0/solidworks/Detached Modules/2014.03.24 Conjunto Lateral - ELIPSE pequena/Dependencies/2014.02.26 Conjunto escotilha Lateral.SLDASM
2818.8 x 3815.6 x 74.7 mm
2014.02.26 PC lateral
2014.02.26 Suport LEXAN (lateral)
2014.02.26 Suport LEXAN (escotilha)
2014.02.26 PC Escotilha
2014.02.25 Dobradiça x 4
2014.02.26 Apoio Motor
2014.02.26 motor
2014.02.28 Gancho motor lateral
