steam228/GROUU/(list of files, cad)

Other CAD files:
ARCHIVE/grouu-v0/solidworks/Detached Modules/2014.04.23 Conjunto Escotilha - circular/2014.04.23 Conjunto Escotilha - circular.SLDASM
ARCHIVE/grouu-v0/solidworks/Detached Modules/Estudos para Raised beds/Estudos para Raised beds.SLDASM
ARCHIVE/grouu-v0/solidworks/Detached Modules/2014.03.24 Conjunto Lateral - ELIPSE pequena/Dependencies/2014.03.24 Conjunto Lateral - ELIPSE.SLDASM
ARCHIVE/grouu-v0/solidworks/Dependencies/4911231.sldprt
ARCHIVE/grouu-v0/solidworks/Dependencies/4911232.sldprt
ARCHIVE/grouu-v0/solidworks/Dependencies/4911233.sldprt
ARCHIVE/grouu-v0/solidworks/Dependencies/BWF ESX108.SLDPRT
ARCHIVE/grouu-v0/solidworks/Dependencies/BWF HSX108.SLDPRT
ARCHIVE/grouu-v0/solidworks/Dependencies/Caixa exterior esys.SLDASM
ARCHIVE/grouu-v0/solidworks/Dependencies/Canto Simples.SLDASM
ARCHIVE/grouu-v0/solidworks/Dependencies/E.1 ESYS.SLDPRT
ARCHIVE/grouu-v0/solidworks/Dependencies/E.3.1 CASQUILHO KERB.SLDPRT
ARCHIVE/grouu-v0/solidworks/Dependencies/E.3.3 PORCA DE CANAL.SLDPRT
ARCHIVE/grouu-v0/solidworks/Dependencies/E.EXT.SLDASM
ARCHIVE/grouu-v0/solidworks/Dependencies/E1.C1.SLDPRT
ARCHIVE/grouu-v0/solidworks/Dependencies/E1.CA.SLDPRT
ARCHIVE/grouu-v0/solidworks/Dependencies/E1.P.SLDPRT
ARCHIVE/grouu-v0/solidworks/Dependencies/EEXT3.X PERFIL ESYS EXT.SLDPRT
ARCHIVE/grouu-v0/solidworks/Dependencies/EXT1.C1.SLDPRT
ARCHIVE/grouu-v0/solidworks/Dependencies/EXT1.C1.X.SLDASM
ARCHIVE/grouu-v0/solidworks/Dependencies/EXT1.C2.1.SLDPRT
ARCHIVE/grouu-v0/solidworks/Dependencies/EXT1.C2.2.SLDPRT
ARCHIVE/grouu-v0/solidworks/Dependencies/EXT1.CC.1.A.SLDPRT
ARCHIVE/grouu-v0/solidworks/Dependencies/EXT1.CC.1.B.SLDPRT
ARCHIVE/grouu-v0/solidworks/Dependencies/EXT1.LEXAN8MM.1.SLDPRT
ARCHIVE/grouu-v0/solidworks/Dependencies/EXT1.TAE1.SLDPRT
ARCHIVE/grouu-v0/solidworks/Dependencies/EXT1.WFS.1 Pré-Montagem.SLDASM
ARCHIVE/grouu-v0/solidworks/Dependencies/EXT1.WFS.1.SLDPRT
ARCHIVE/grouu-v0/solidworks/Dependencies/EXT1.WFS.2.SLDPRT
ARCHIVE/grouu-v0/solidworks/Dependencies/EXT1.X.SLDASM
ARCHIVE/grouu-v0/solidworks/Dependencies/Estrutura Base II.SLDASM
ARCHIVE/grouu-v0/solidworks/Dependencies/Estrutura Base III.SLDASM
ARCHIVE/grouu-v0/solidworks/Dependencies/LT2UV102RS17.SLDPRT
ARCHIVE/grouu-v0/solidworks/Dependencies/LT2UV102RS17_lateral1.SLDPRT
ARCHIVE/grouu-v0/solidworks/Dependencies/LT2UV82RS15 LEXAN PARA ESTUFAS SUBCONFIGS Telhado i.SLDPRT
ARCHIVE/grouu-v0/solidworks/Dependencies/LT2UV82RS15 LEXAN PARA ESTUFAS SUBCONFIGS Telhado ii.SLDPRT
ARCHIVE/grouu-v0/solidworks/Dependencies/LT2UV82RS15 LEXAN PARA ESTUFAS SUBCONFIGS ii.SLDPRT
ARCHIVE/grouu-v0/solidworks/Dependencies/LT2UV82RS15 LEXAN PARA ESTUFAS SUBCONFIGS iii.SLDPRT
ARCHIVE/grouu-v0/solidworks/Dependencies/LT2UV82RS15 LEXAN PARA ESTUFAS SUBCONFIGS iv ag.SLDPRT
ARCHIVE/grouu-v0/solidworks/Dependencies/LT2UV82RS15 LEXAN PARA ESTUFAS SUBCONFIGS.SLDPRT
ARCHIVE/grouu-v0/solidworks/Dependencies/Pavimento Estufa.SLDPRT
ARCHIVE/grouu-v0/solidworks/Dependencies/Pavimento.SLDASM
ARCHIVE/grouu-v0/solidworks/Dependencies/Reforço de Cumeeira.SLDASM
ARCHIVE/grouu-v0/solidworks/Dependencies/Reforço de águas II.SLDPRT
ARCHIVE/grouu-v0/solidworks/Dependencies/Reforço de águas.SLDASM
ARCHIVE/grouu-v0/solidworks/Dependencies/Reforço de águas.SLDPRT
ARCHIVE/grouu-v0/solidworks/Dependencies/Reforço de águasII.SLDASM
ARCHIVE/grouu-v0/solidworks/Dependencies/SR5624 491123 MOSS.SLDASM
ARCHIVE/grouu-v0/solidworks/Dependencies/Suporte.SLDPRT
ARCHIVE/grouu-v0/solidworks/Dependencies/Suporte1000LEXAN.SLDPRT
ARCHIVE/grouu-v0/solidworks/Dependencies/Suporte150LEXAN.SLDPRT
ARCHIVE/grouu-v0/solidworks/Dependencies/Suporte2000LEXAN.SLDPRT
ARCHIVE/grouu-v0/solidworks/Dependencies/Suporte300LEXAN.SLDPRT
ARCHIVE/grouu-v0/solidworks/Dependencies/Travessa Tipo Pre-Assembled.SLDASM
ARCHIVE/grouu-v0/solidworks/Dependencies/VISA MULTIWALL cx exterior - lateral.SLDPRT
ARCHIVE/grouu-v0/solidworks/Dependencies/WISA - Multifloor.SLDPRT
ARCHIVE/grouu-v0/solidworks/Dependencies/WISA MULTIWALL cx exterior -agua.SLDPRT
ARCHIVE/grouu-v0/solidworks/Dependencies/WISA MULTIWALL cx exterior -frente.SLDPRT
ARCHIVE/grouu-v0/solidworks/Dependencies/X config for EXT + ESYS.SLDASM
ARCHIVE/grouu-v0/solidworks/Dependencies/roda.SLDASM
ARCHIVE/grouu-v0/solidworks/Detached Modules/2014.03.24 Conjunto Lateral - ELIPSE pequena/Dependencies/2014.02.25 Dobradiça.SLDPRT
ARCHIVE/grouu-v0/solidworks/Detached Modules/2014.03.24 Conjunto Lateral - ELIPSE pequena/Dependencies/2014.02.25 Perfil em T.SLDPRT
ARCHIVE/grouu-v0/solidworks/Detached Modules/2014.03.24 Conjunto Lateral - ELIPSE pequena/Dependencies/2014.02.26 PC Escotilha.SLDPRT
ARCHIVE/grouu-v0/solidworks/Detached Modules/2014.03.24 Conjunto Lateral - ELIPSE pequena/Dependencies/2014.02.26 PC lateral.SLDPRT
ARCHIVE/grouu-v0/solidworks/Detached Modules/2014.03.24 Conjunto Lateral - ELIPSE pequena/Dependencies/2014.02.26 Suport LEXAN (escotilha).SLDPRT
ARCHIVE/grouu-v0/solidworks/Detached Modules/2014.03.24 Conjunto Lateral - ELIPSE pequena/Dependencies/2014.02.26 Suport LEXAN (lateral).SLDPRT
ARCHIVE/grouu-v0/solidworks/Detached Modules/2014.03.24 Conjunto Lateral - ELIPSE pequena/Dependencies/2014.02.26 motor.SLDPRT
ARCHIVE/grouu-v0/solidworks/Detached Modules/2014.03.24 Conjunto Lateral - ELIPSE pequena/Dependencies/2014.02.28 Gancho motor lateral.SLDPRT
ARCHIVE/grouu-v0/solidworks/Detached Modules/2014.03.24 Conjunto Lateral - ELIPSE pequena/Dependencies/2014.03.24 Apoio Motor Lateral.SLDPRT
ARCHIVE/grouu-v0/solidworks/Detached Modules/2014.03.24 Conjunto Lateral - ELIPSE pequena/Dependencies/2014.03.24 Batente Janela.SLDPRT
ARCHIVE/grouu-v0/solidworks/Detached Modules/2014.03.24 Conjunto Lateral - ELIPSE pequena/Dependencies/2014.03.24 ELIPSE motor.SLDPRT
ARCHIVE/grouu-v0/solidworks/Detached Modules/2014.04.22 Conjunto Escotilha - simples/Dependencies/2014.02.25 Apoio Motor.SLDPRT
ARCHIVE/grouu-v0/solidworks/Detached Modules/2014.04.22 Conjunto Escotilha - simples/Dependencies/2014.02.26 motor.SLDPRT
ARCHIVE/grouu-v0/solidworks/Detached Modules/2014.04.22 Conjunto Escotilha - simples/Dependencies/2014.04.22 Alavanca - batente.SLDPRT
ARCHIVE/grouu-v0/solidworks/Detached Modules/2014.04.22 Conjunto Escotilha - simples/Dependencies/2014.04.22 Alavanca.SLDPRT
ARCHIVE/grouu-v0/solidworks/Detached Modules/2014.04.22 Conjunto Escotilha - simples/Dependencies/2014.04.22 Apoio Alavanca.SLDPRT
ARCHIVE/grouu-v0/solidworks/Detached Modules/2014.04.22 Conjunto Escotilha - simples/Dependencies/2014.04.22 Dobradiça.SLDPRT
ARCHIVE/grouu-v0/solidworks/Detached Modules/2014.04.22 Conjunto Escotilha - simples/Dependencies/2014.04.22 PC escotilha.SLDPRT
ARCHIVE/grouu-v0/solidworks/Detached Modules/2014.04.22 Conjunto Escotilha - simples/Dependencies/2014.04.22 PC tecto.SLDPRT
ARCHIVE/grouu-v0/solidworks/Detached Modules/2014.04.22 Conjunto Escotilha - simples/Dependencies/2014.04.22 Placa Lexan Telhado.SLDPRT
ARCHIVE/grouu-v0/solidworks/Detached Modules/2014.04.22 Conjunto Escotilha - simples/Dependencies/2014.04.22 Placa Lexan escotilha.SLDPRT
ARCHIVE/grouu-v0/solidworks/Detached Modules/2014.04.23 Conjunto Escotilha - circular/Dependencies/2014.02.25 Apoio Motor.SLDPRT
ARCHIVE/grouu-v0/solidworks/Detached Modules/2014.04.23 Conjunto Escotilha - circular/Dependencies/2014.02.26 motor.SLDPRT
ARCHIVE/grouu-v0/solidworks/Detached Modules/2014.04.23 Conjunto Escotilha - circular/Dependencies/2014.04.22 Alavanca - batente.SLDPRT
ARCHIVE/grouu-v0/solidworks/Detached Modules/2014.04.23 Conjunto Escotilha - circular/Dependencies/2014.04.22 Alavanca.SLDPRT
ARCHIVE/grouu-v0/solidworks/Detached Modules/2014.04.23 Conjunto Escotilha - circular/Dependencies/2014.04.22 Apoio Alavanca.SLDPRT
ARCHIVE/grouu-v0/solidworks/Detached Modules/2014.04.23 Conjunto Escotilha - circular/Dependencies/2014.04.22 Dobradiça.SLDPRT
ARCHIVE/grouu-v0/solidworks/Detached Modules/2014.04.23 Conjunto Escotilha - circular/Dependencies/2014.04.22 PC escotilha.SLDPRT
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
