steam228/GROUU/WORKSHOPS/AAlfaceOHM/Osso-Labirintos-WKS/PrintOssoOHMMM.pdf

# A Alface que sussurra OHMMMMM

# André Rocha (ESELx / IPL) @ OSSO

# A Alface que sussurra OHMMMMM

André Rocha
(ESELx / IPL) @
OSSO

# A Alface que sussurra OHMMMMM

André Rocha
(ESELx / IPL) @
OSSO

# A Alface que sussurra OHMMMMM

André Rocha
(ESELx / IPL) @
OSSO

# A Alface que sussurra OHMMMMM

André Rocha
(ESELx / IPL) @
OSSO

# A Alface que sussurra OHMMMMM

André Rocha
(ESELx / IPL) @
OSSO

# A Alface que sussurra OHMMMMM

André Rocha
(ESELx / IPL) @
OSSO

# A Alface que sussurra OHMMMMM

André Rocha
(ESELx / IPL) @
OSSO

# A Alface que sussurra OHMMMMM

André Rocha
(ESELx / IPL) @
OSSO

# A Alface que sussurra OHMMMMM

André Rocha
(ESELx / IPL) @
OSSO

# A Alface que sussurra OHMMMMM

André Rocha
(ESELx / IPL) @
OSSO

# A Alface que sussurra OHMMMMM

André Rocha
(ESELx / IPL) @
OSSO

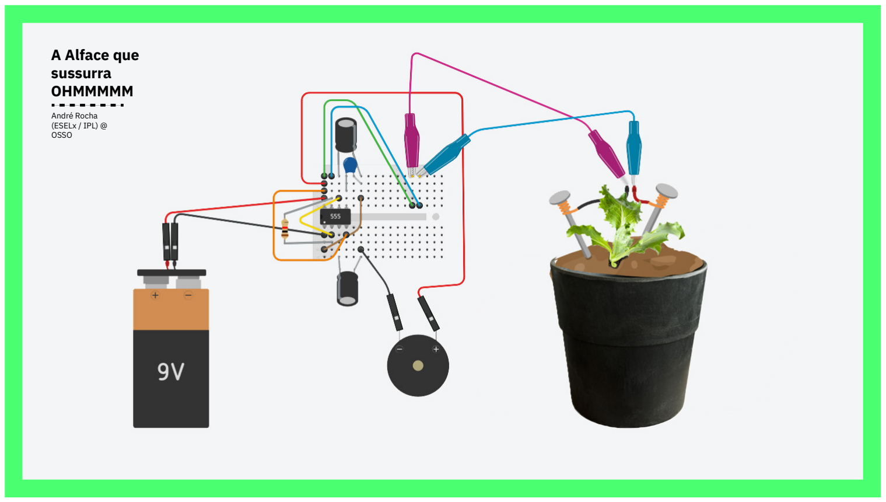
[picture p91: figure]
A Alface que sussurra OHMMMMM; André Rocha (ESELx / IPL) @ OSSO

# A Alface que sussurra OHMMMMM

André Rocha
(ESELx / IPL) @
OSSO
