steam228/GROUU/docs/site/img/alface/fab-build.jpg

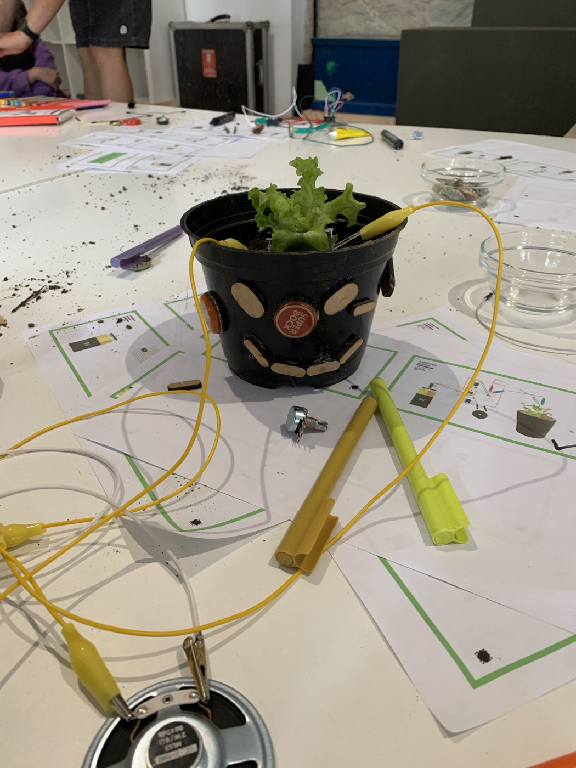
docs/site/img/alface/fab-build.jpg
