steam228/GROUU/docs/site/img/nursery/build.jpg

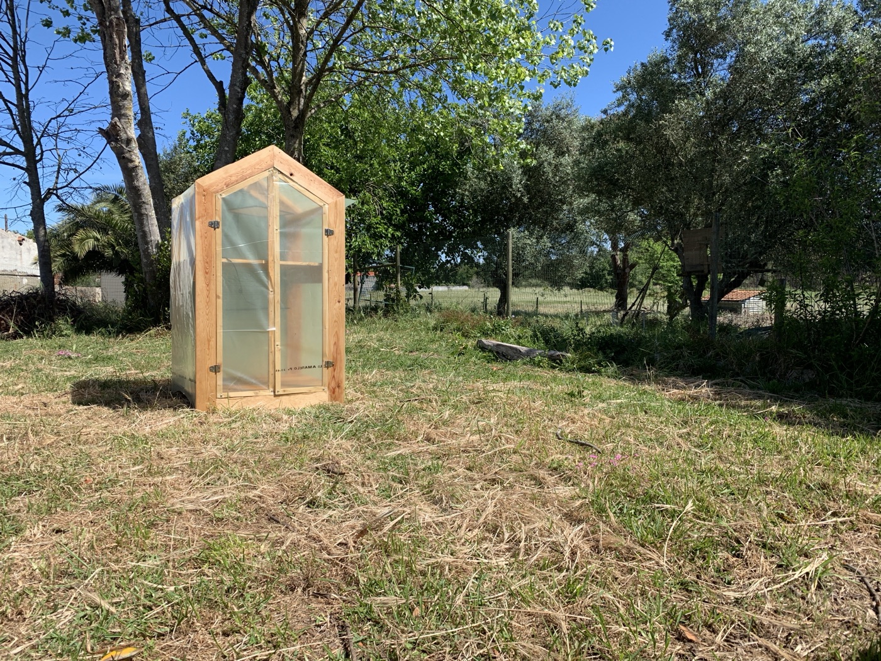
docs/site/img/nursery/build.jpg
