steam228/GROUU/docs/site/img/v0/building2.jpg

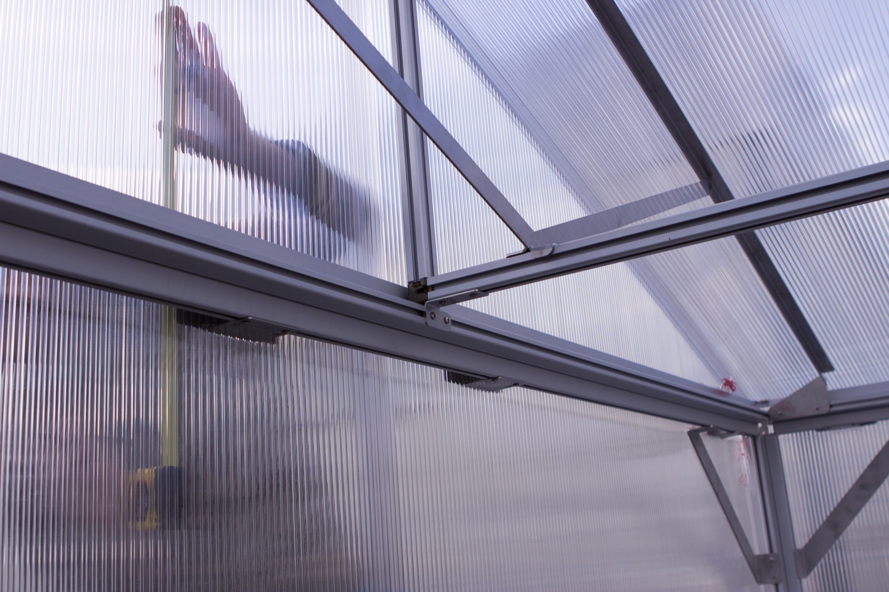
docs/site/img/v0/building2.jpg
