steam228/GROUU/docs/site/img/v0/construction.jpg

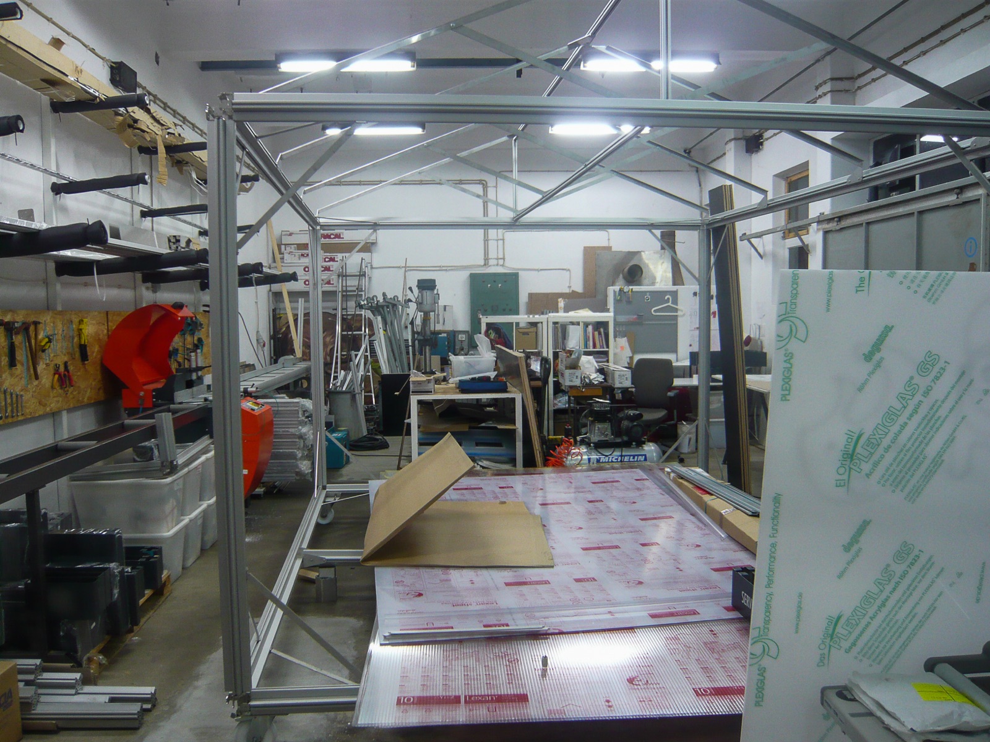
docs/site/img/v0/construction.jpg
