steam228/GROUU/docs/site/img/wellbouy/boards-solder-accidents.jpg

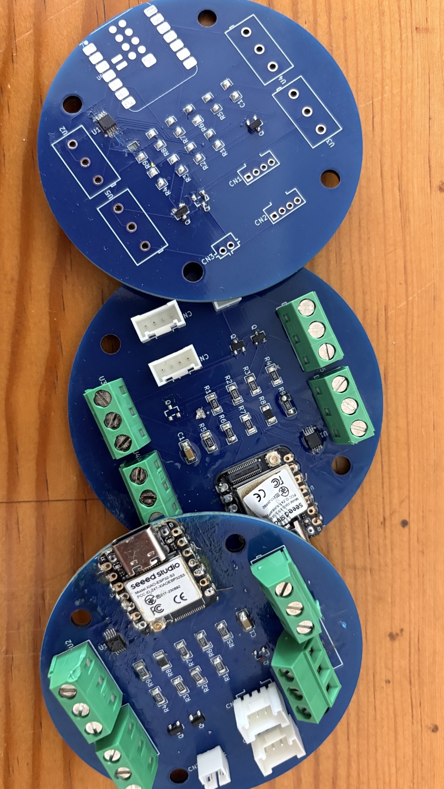
docs/site/img/wellbouy/boards-solder-accidents.jpg
