steam228/GROUU/docs/site/img/wellbouy/bringup-bench.jpg

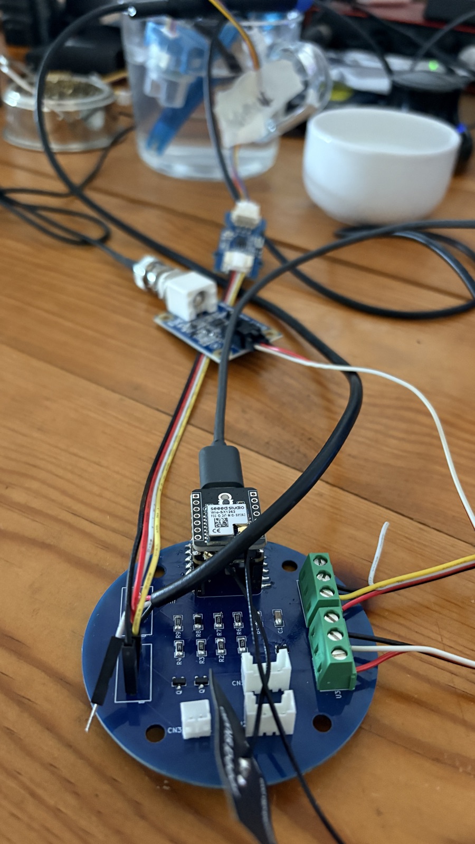
docs/site/img/wellbouy/bringup-bench.jpg
