steam228/GROUU/docs/site/img/wellbouy/bringup-sensors-mug.jpg

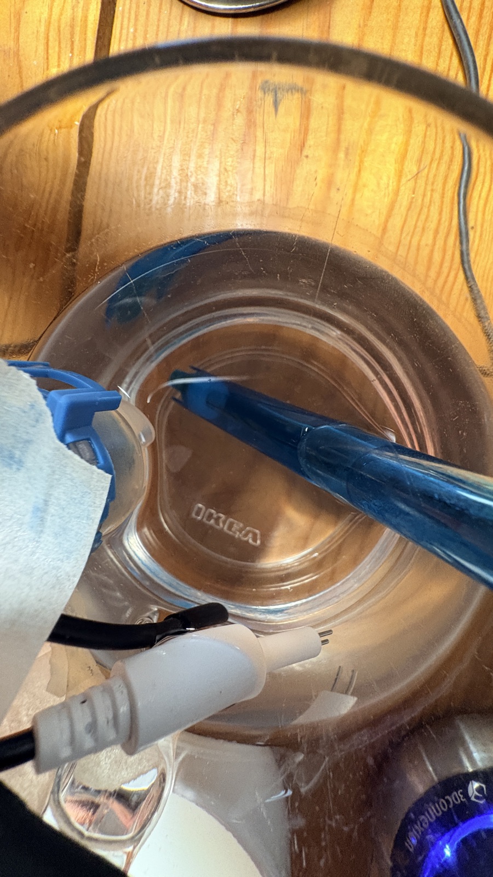
docs/site/img/wellbouy/bringup-sensors-mug.jpg
