steam228/GROUU/WORKSHOPS/habibiWorksJuly2018/Materials/day1.pdf

## 3. Act - Program a Logical Reaction

## Make that information become Visual again on the form

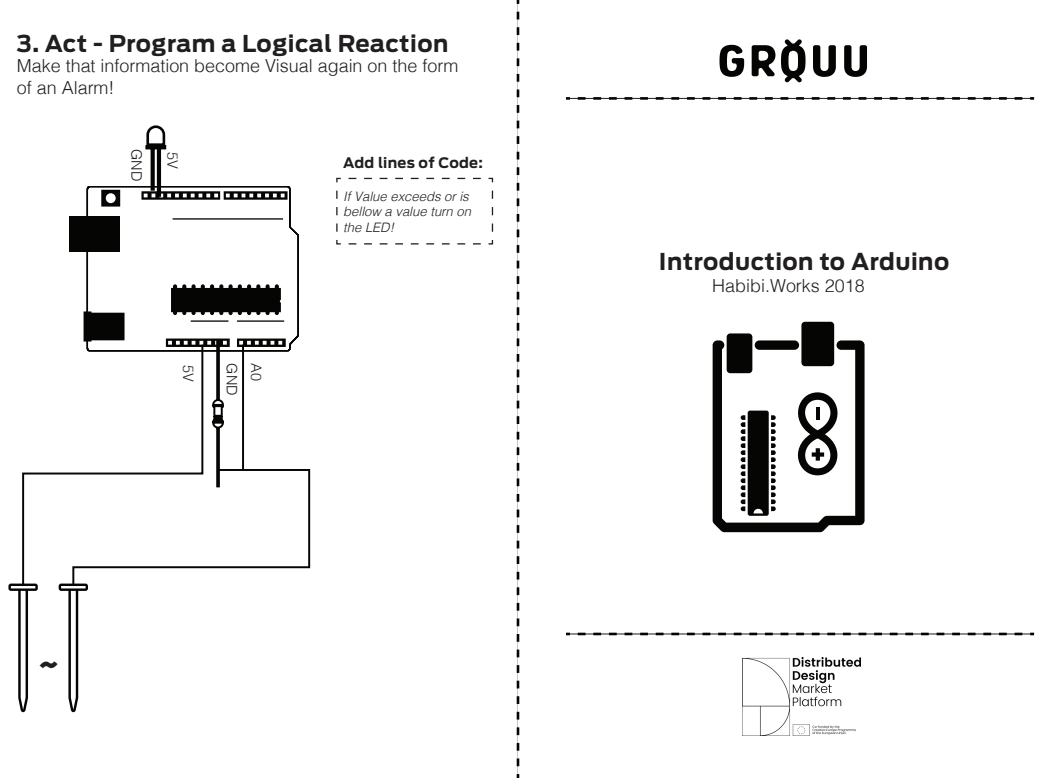
[picture p99: page 1]
GND

of an Alarm!

Add lines of Code:
If Value exceeds or is
bellow a value turn on
the LED!

Introduction to Arduino
Habibi.Works 2018

1. Electricity - OHM’s Law | 2. Arduino Analog Input
A Visual Moisture Sensor | Extract values from the sensor by introducing Computation

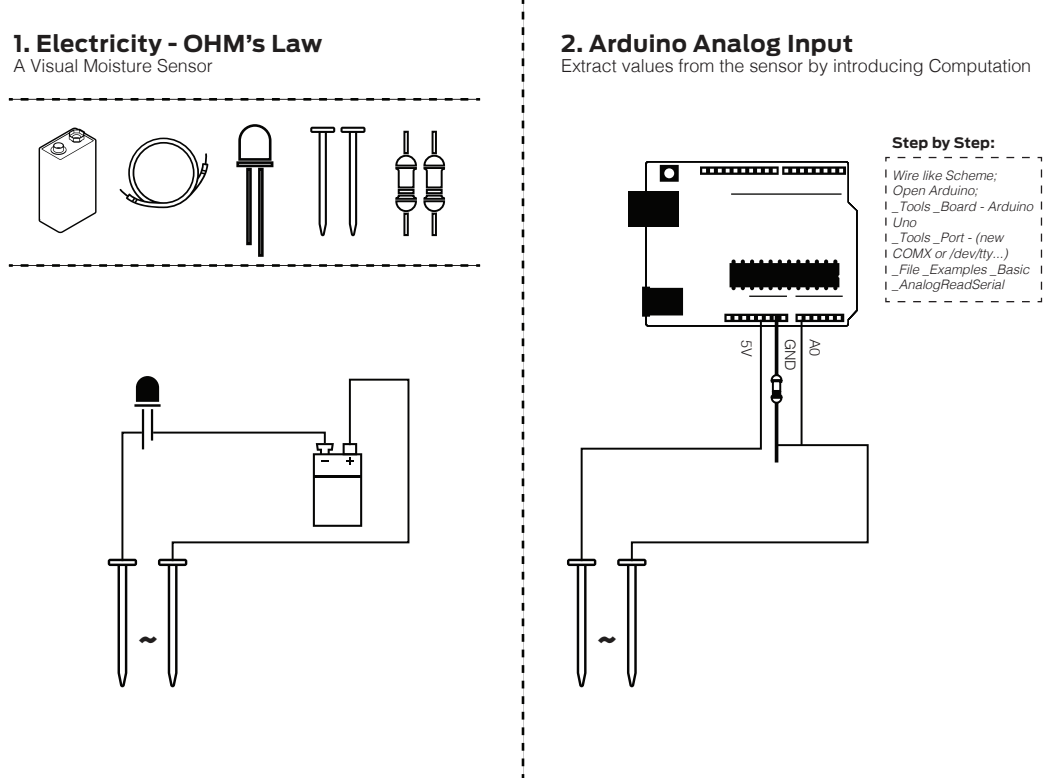
[picture p100: page 2]
GND

Step by Step:
Wire like Scheme;
Open Arduino;
_Tools _Board - Arduino
Uno
_Tools _Port - (new
COMX or /dev/tty...)
_File _Examples _Basic
_AnalogReadSerial
