steam228/GROUU/WORKSHOPS/AAlfaceOHM/Osso-Labirintos-WKS/diagrams/03 - 555sqWaveGenV2.pdf

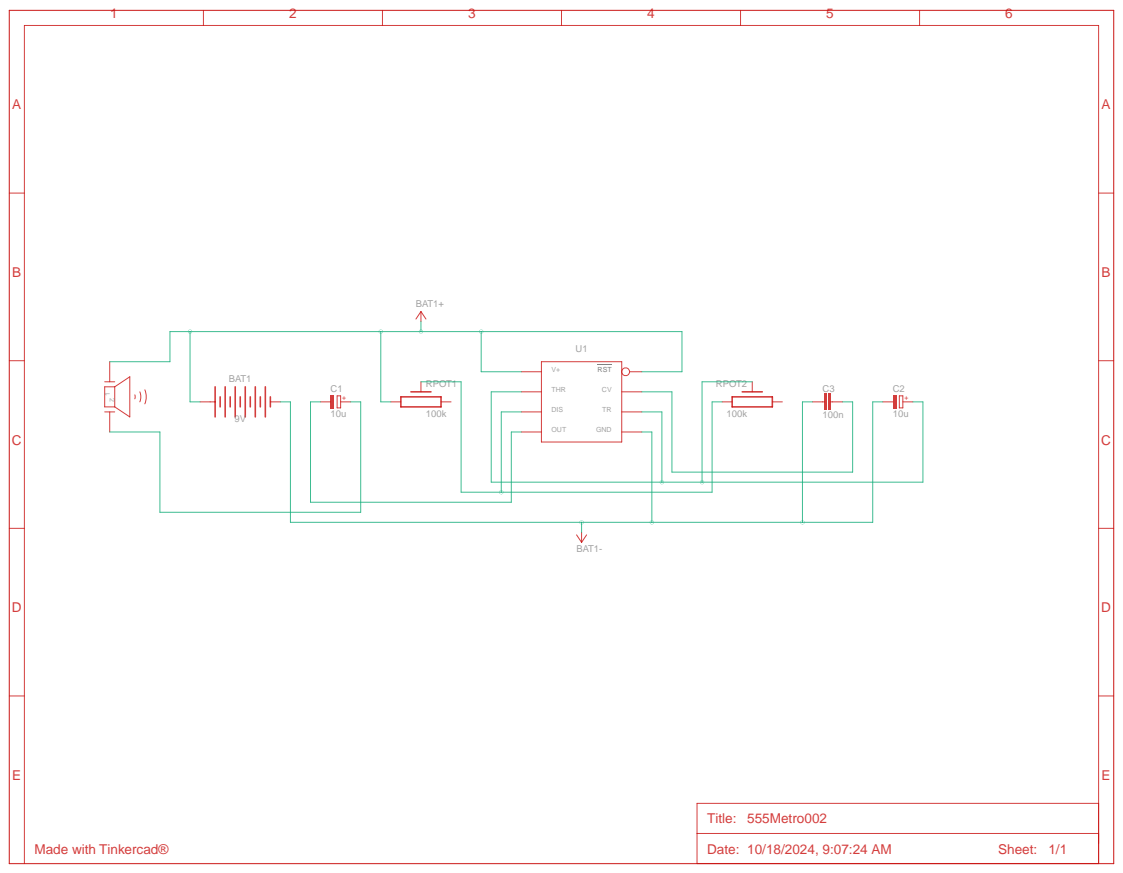
[picture p101: page 1]
Title: 555Metro002; Date: 10/18/2024, 9:07:24 AM; Sheet: 1/1; BAT1; RPOT1; GND; RST; OUT; THR; DIS; RPOT2; BAT1+; BAT1-

Made with Tinkercad®
