steam228/GROUU/WORKSHOPS/AAlfaceOHM/Osso-Labirintos-WKS/diagrams/01 - simple moisture.pdf

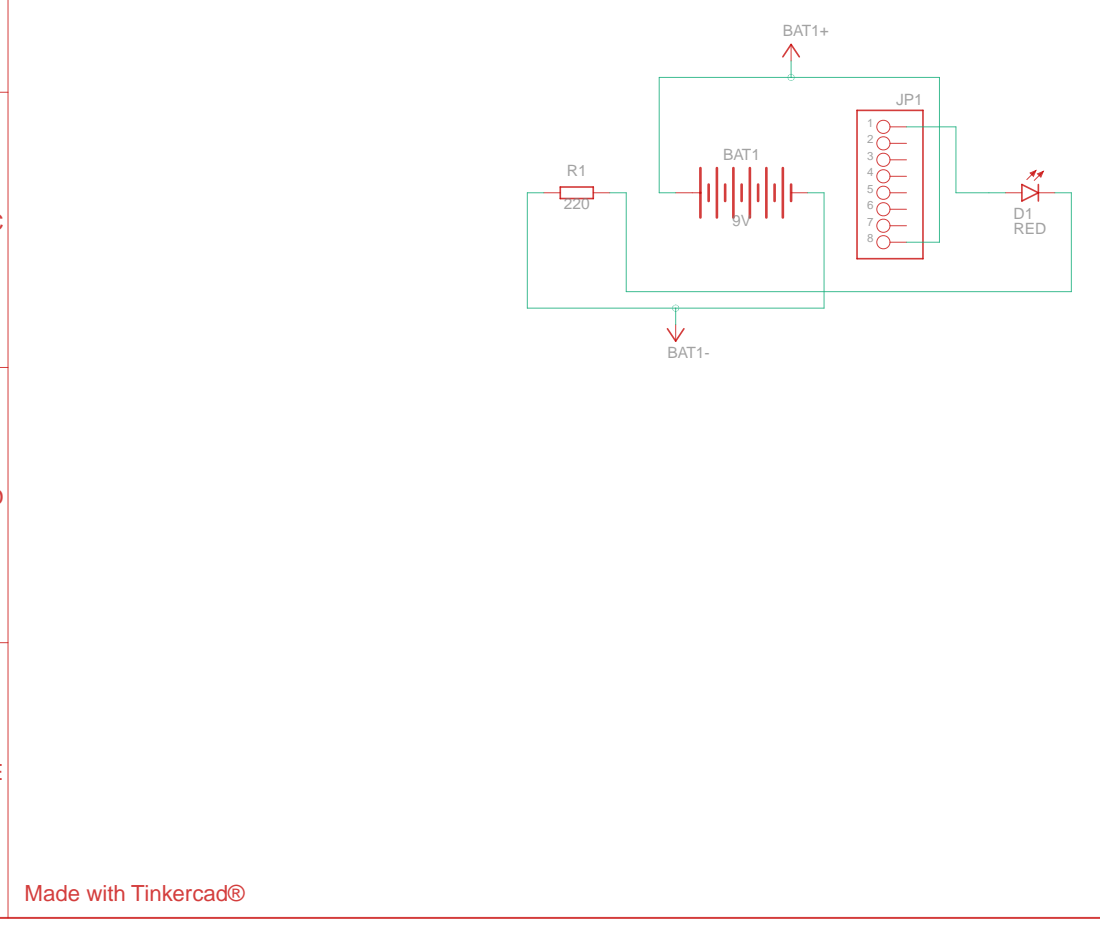
[picture p102: page 1]
Date: 10/18/2024, 9:08:02 AM; Sheet: 1/1; BAT1; D1 RED; BAT1+; BAT1-

Title: simple moisture

Made with Tinkercad®
