steam228/GROUU/ARCHIVE/grouu-v0/drawings/Modelo Base de Estufa - Sheet1.pdf

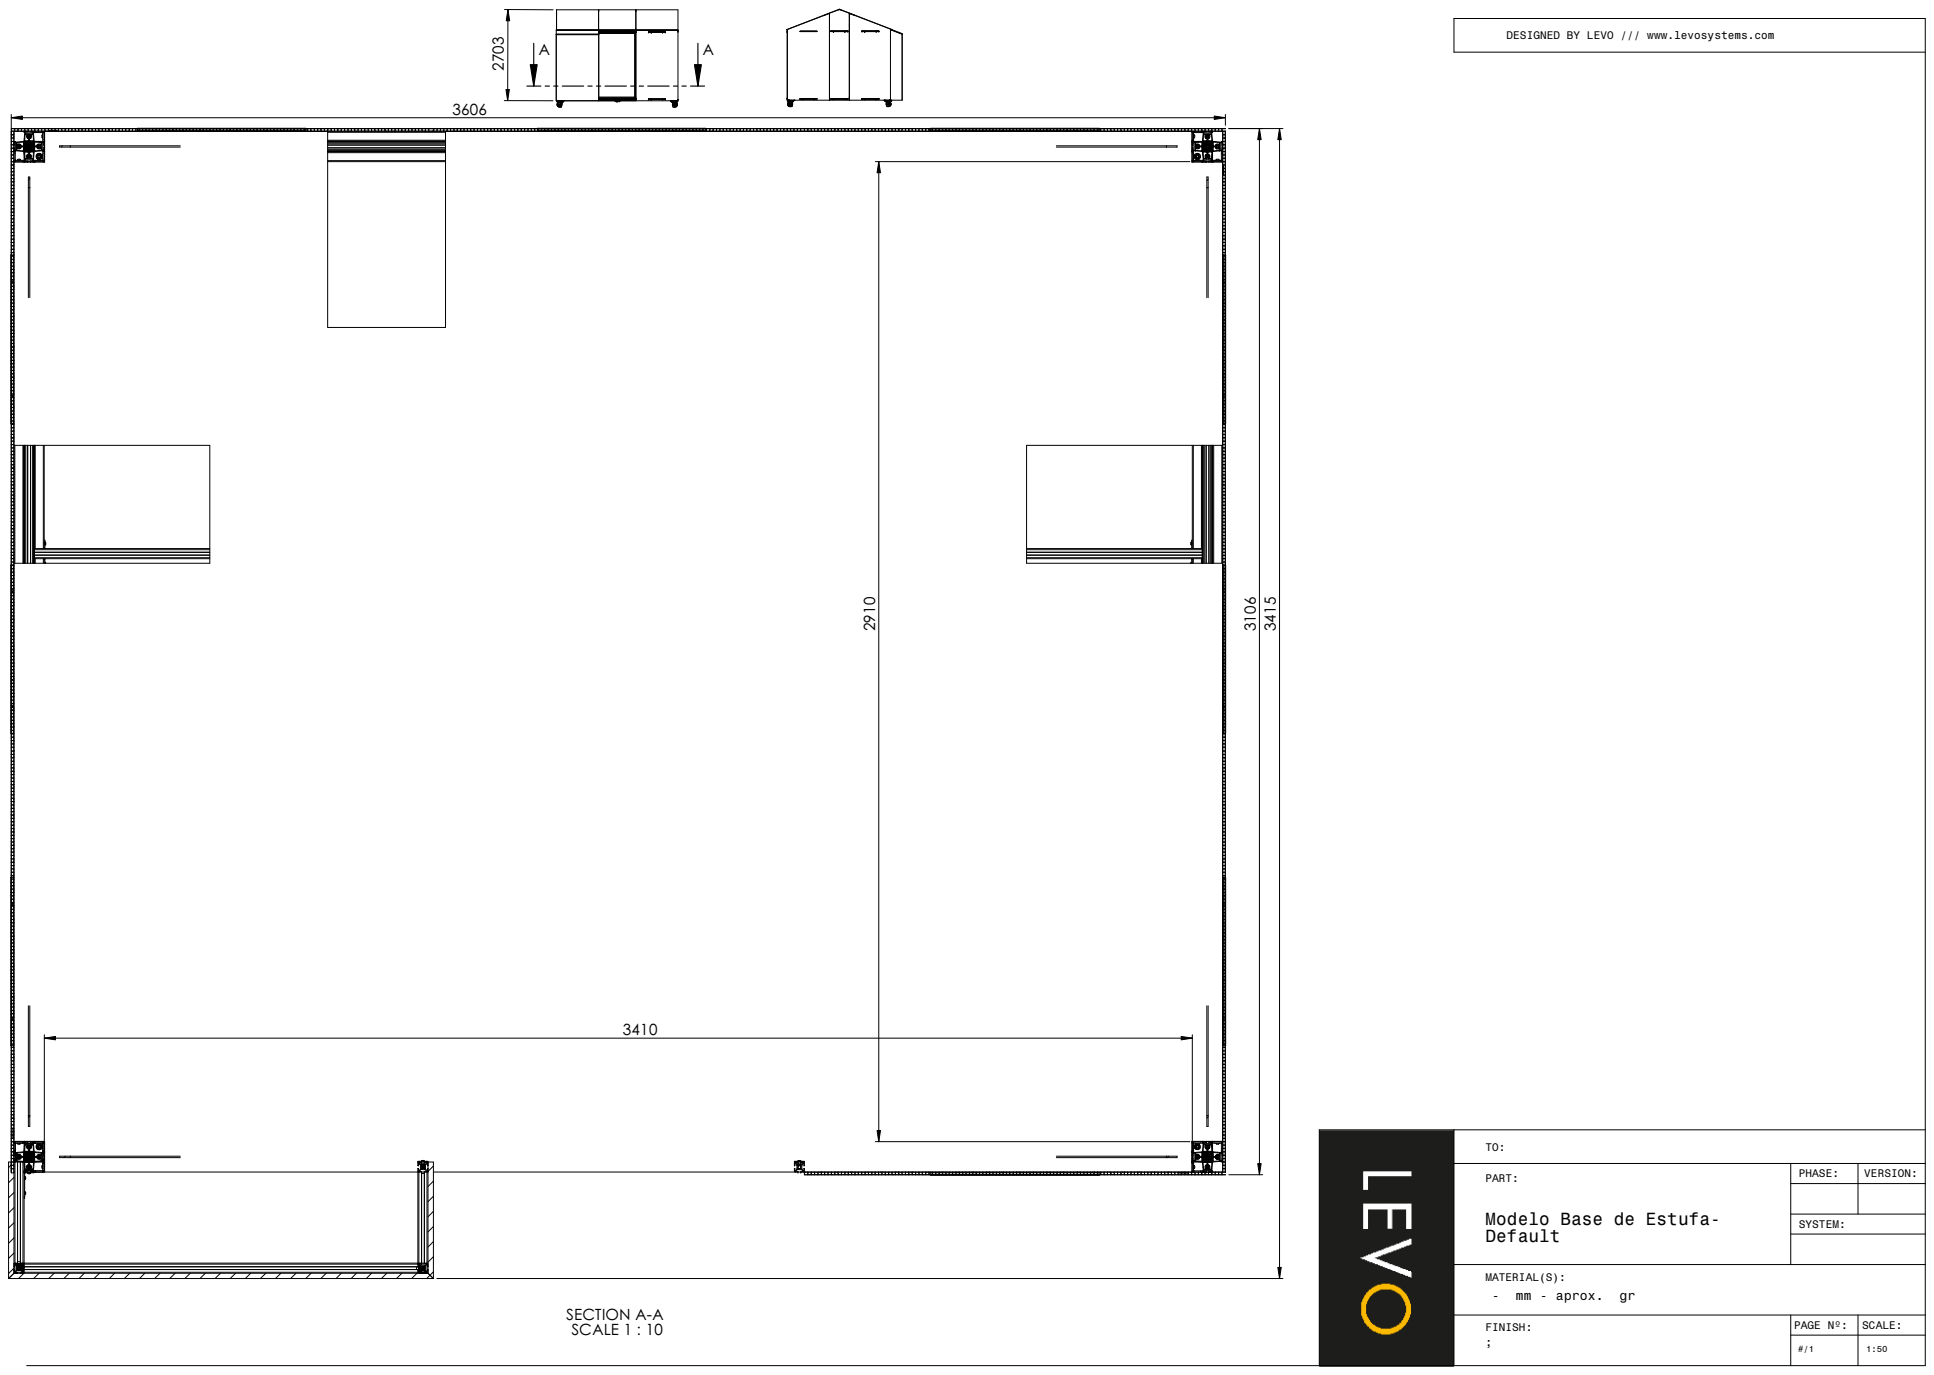
[picture p103: page 1]
SECTION A-A SCALE 1 : 10; SYSTEM:; MATERIAL(S):; mm - aprox.

DESIGNED BY LEVO /// www.levosystems.com

Modelo Base de Estufa-Default | PHASE: PART: | VERSION:

FINISH: ; | PAGE Nº: | SCALE:
