steam228/GROUU/ARCHIVE/grouu-v0/GROUU OUTLINE .pdf

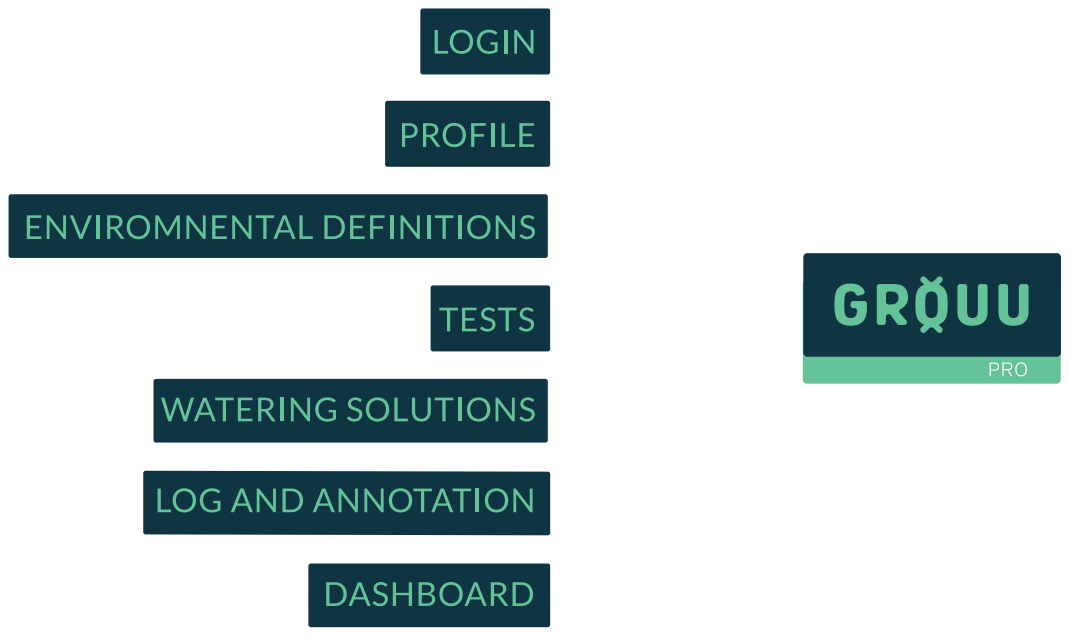
[picture p104: page 2]

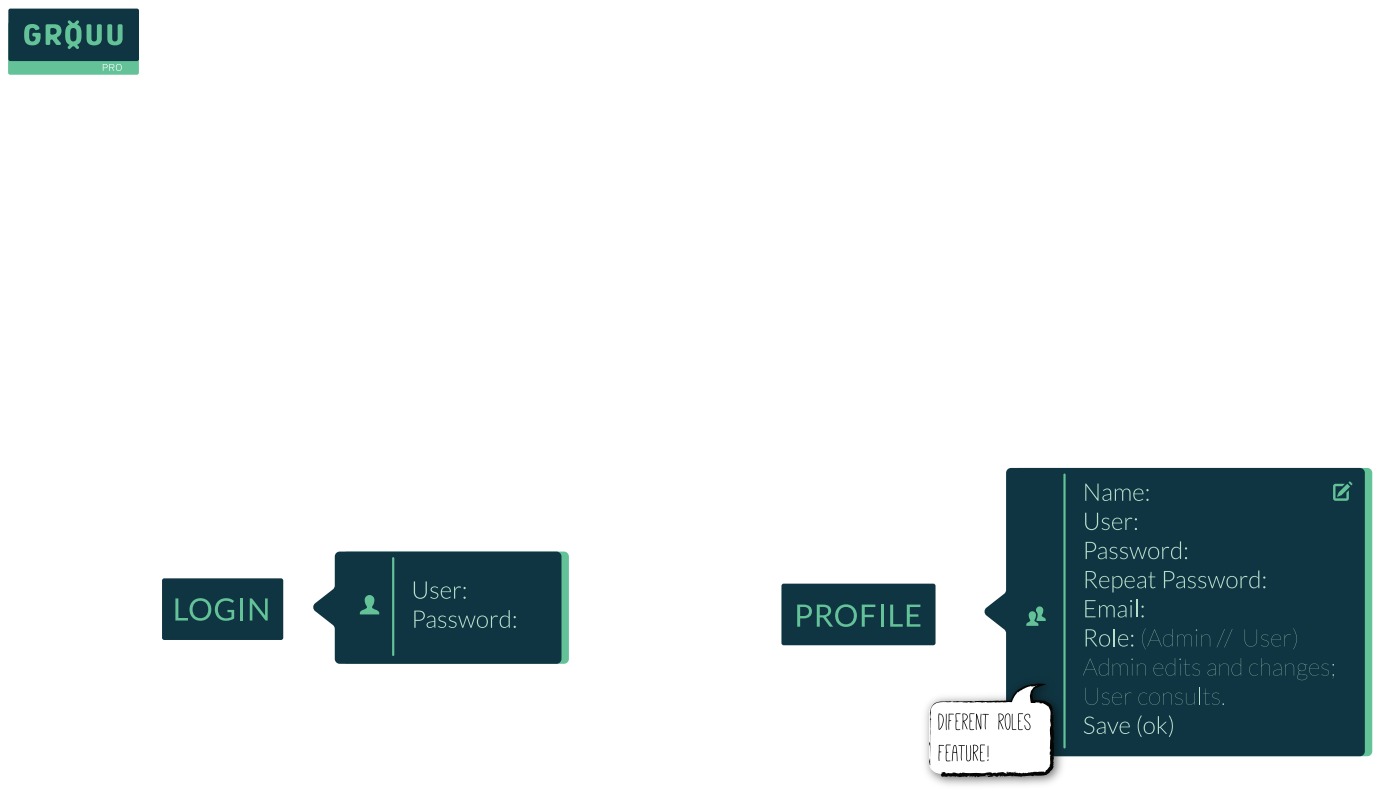
[picture p105: page 3]

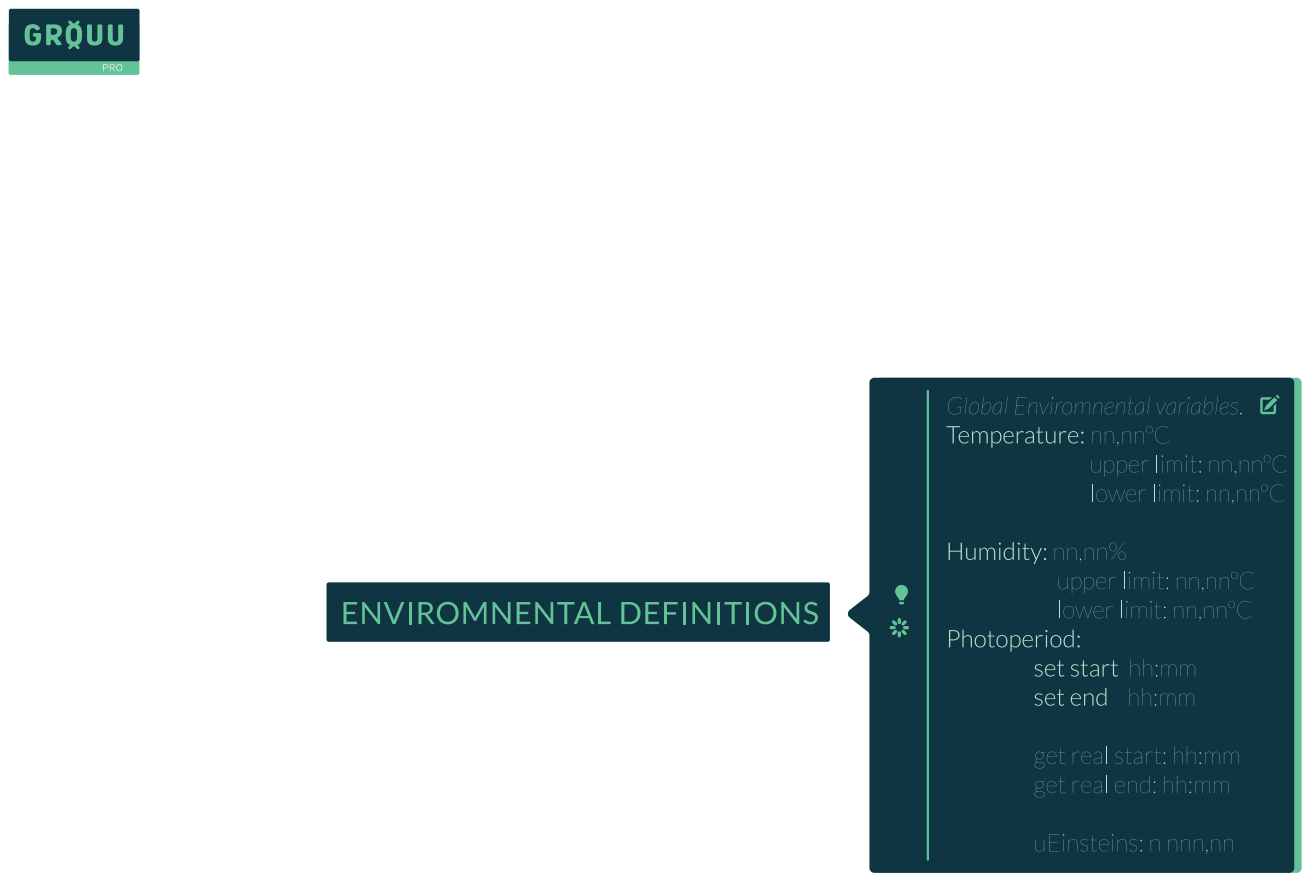
[picture p106: page 4]

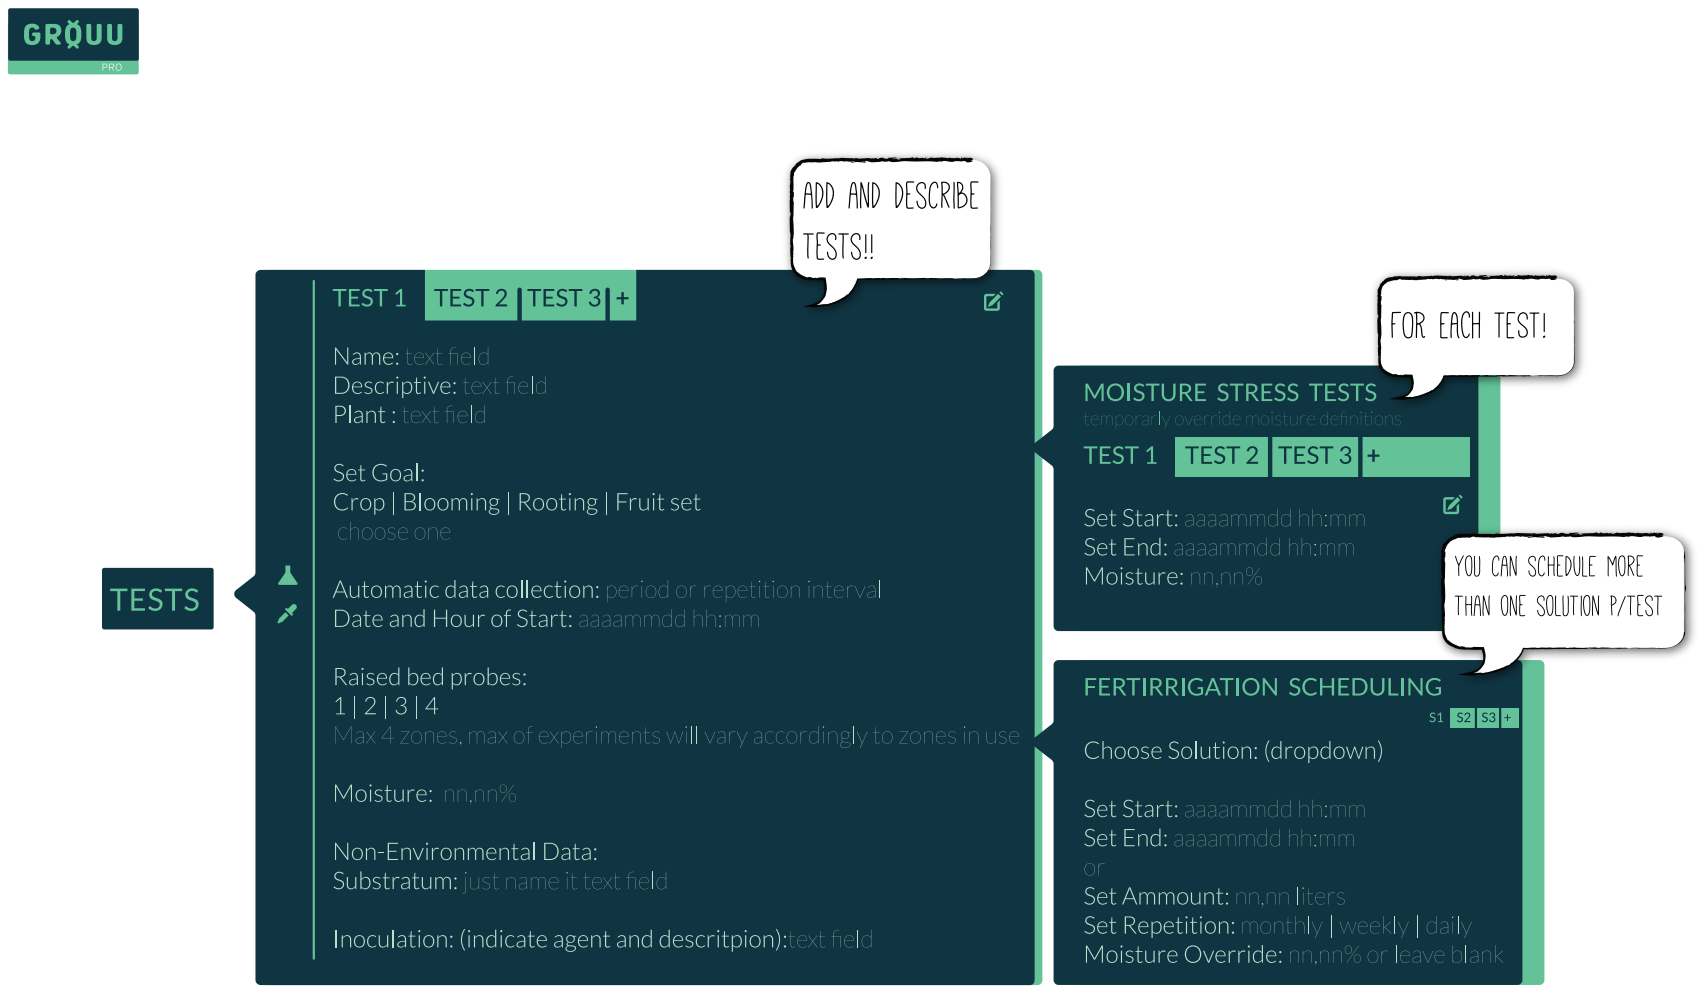
[picture p107: page 5]

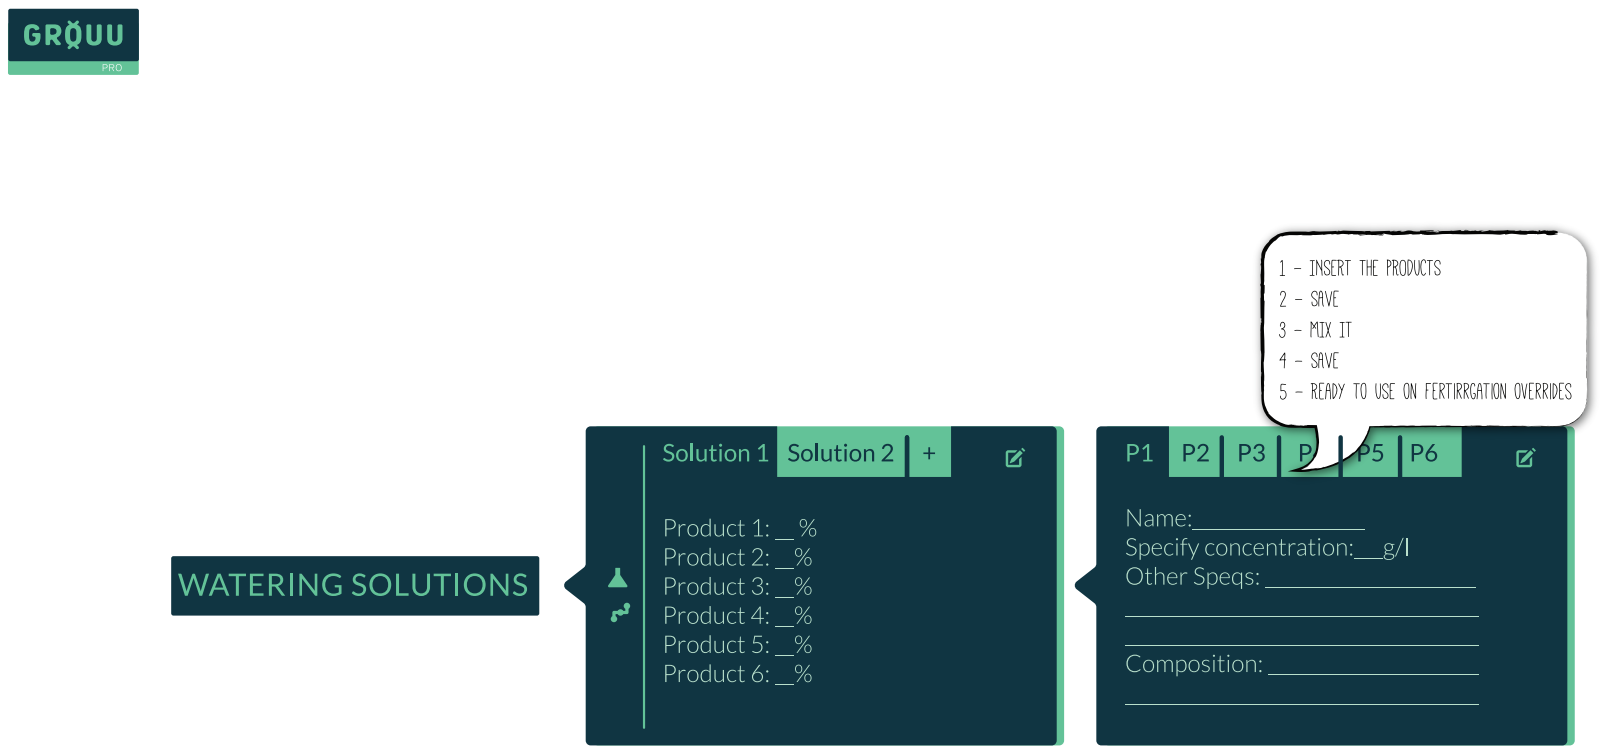
[picture p108: page 6]

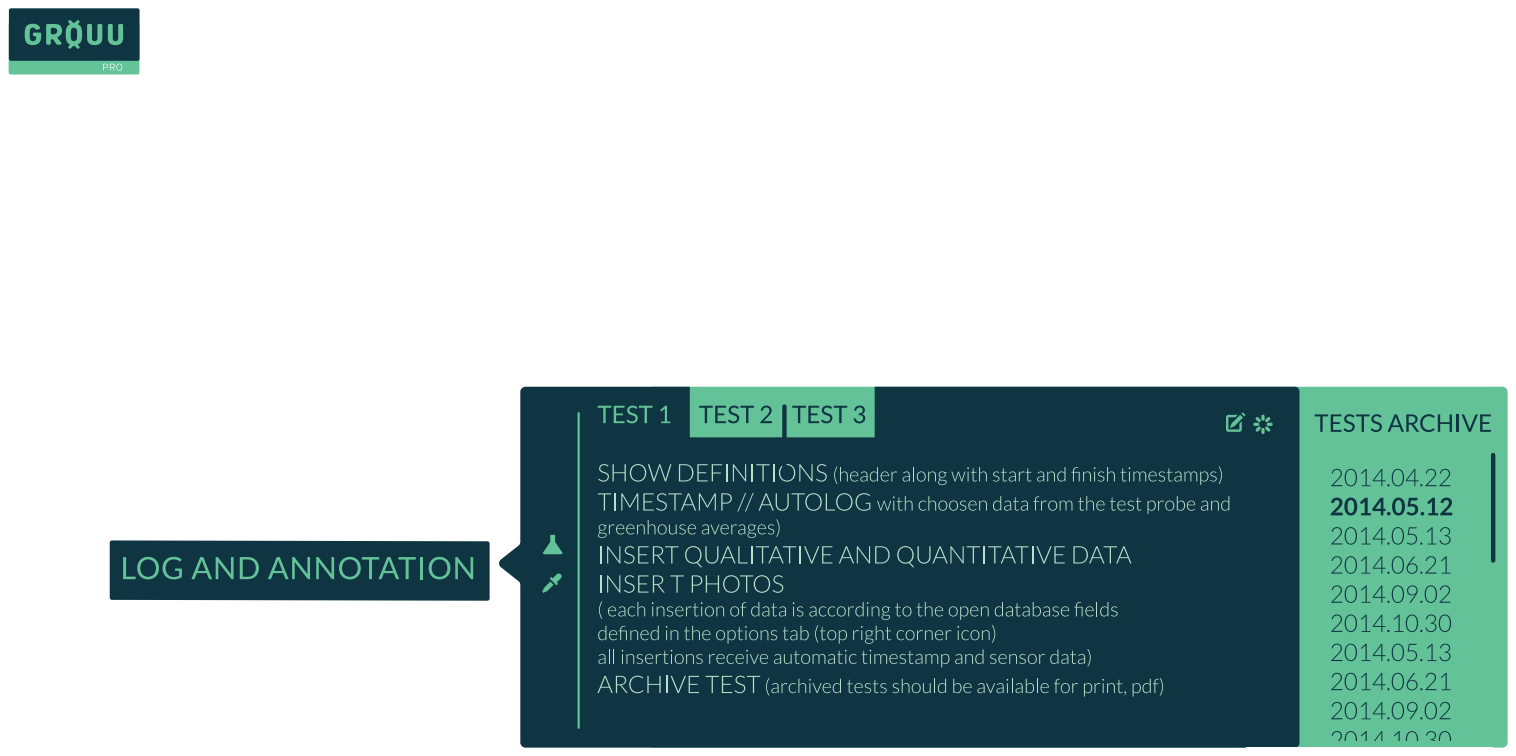
[picture p109: page 7]

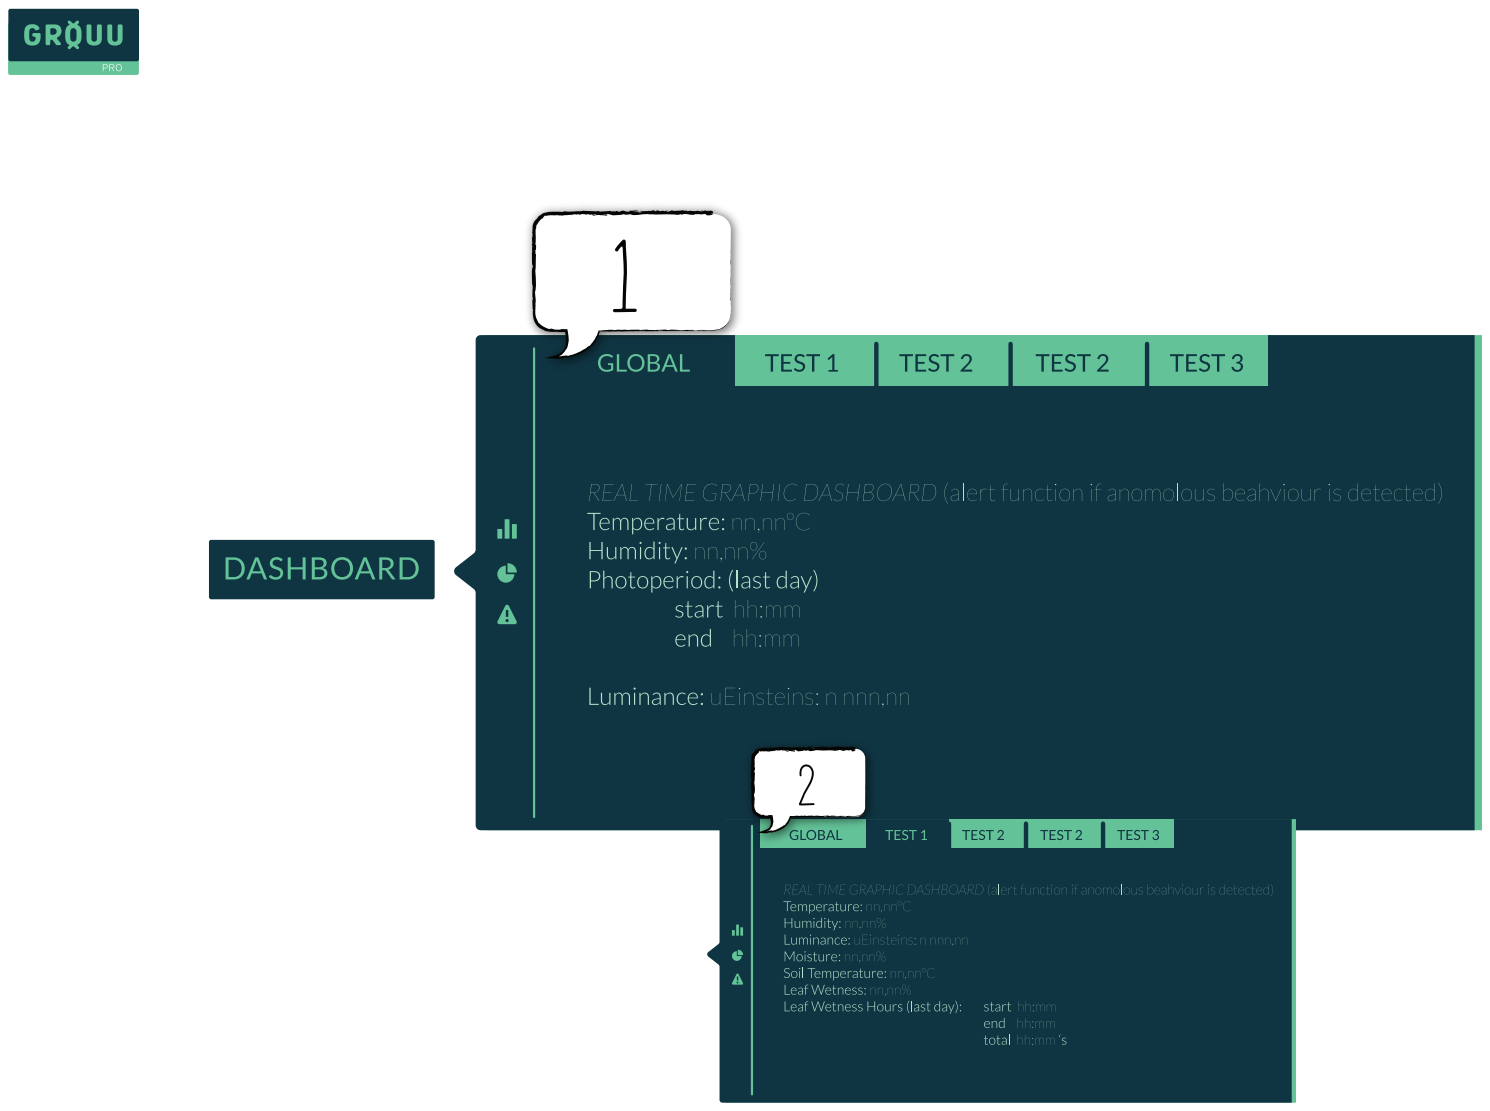
[picture p110: page 8]

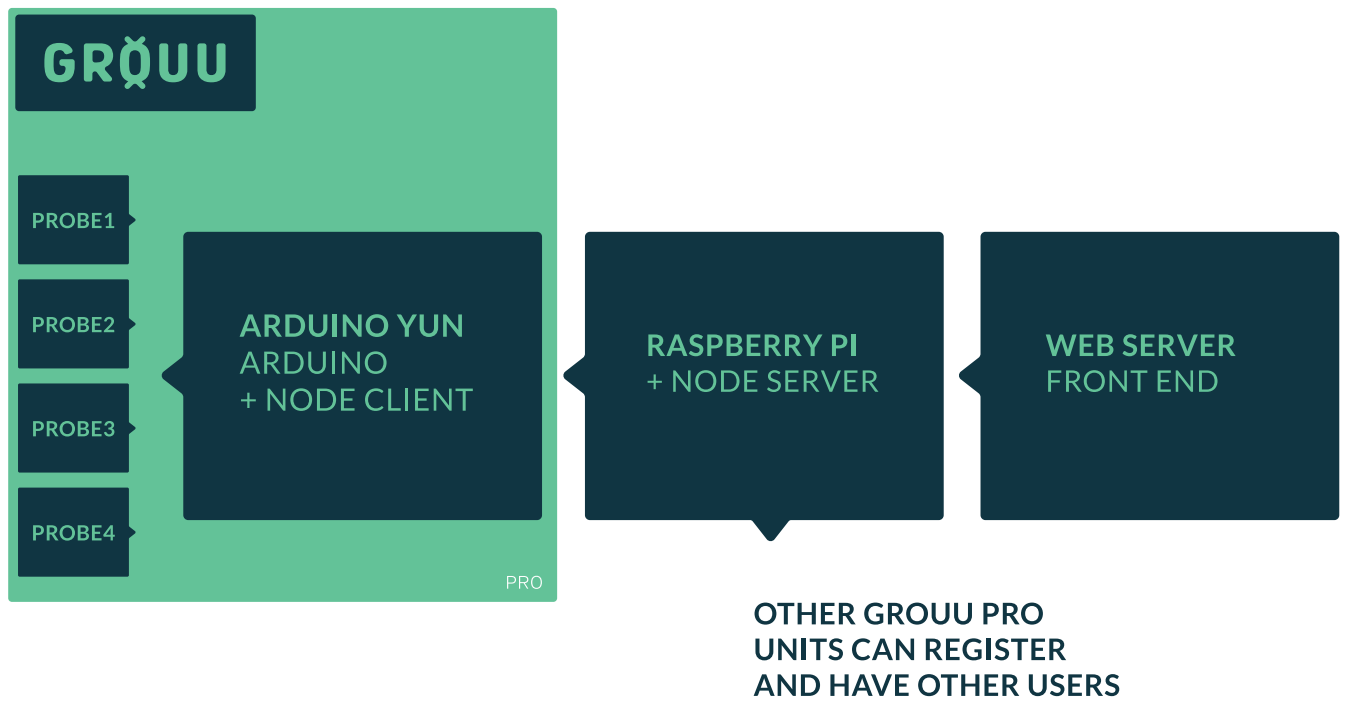
[picture p111: page 10]
