steam228/GROUU/ARCHIVE/grouu-v0/drawings/2014.06.23  Esquema Ligações GrouuPro.pdf

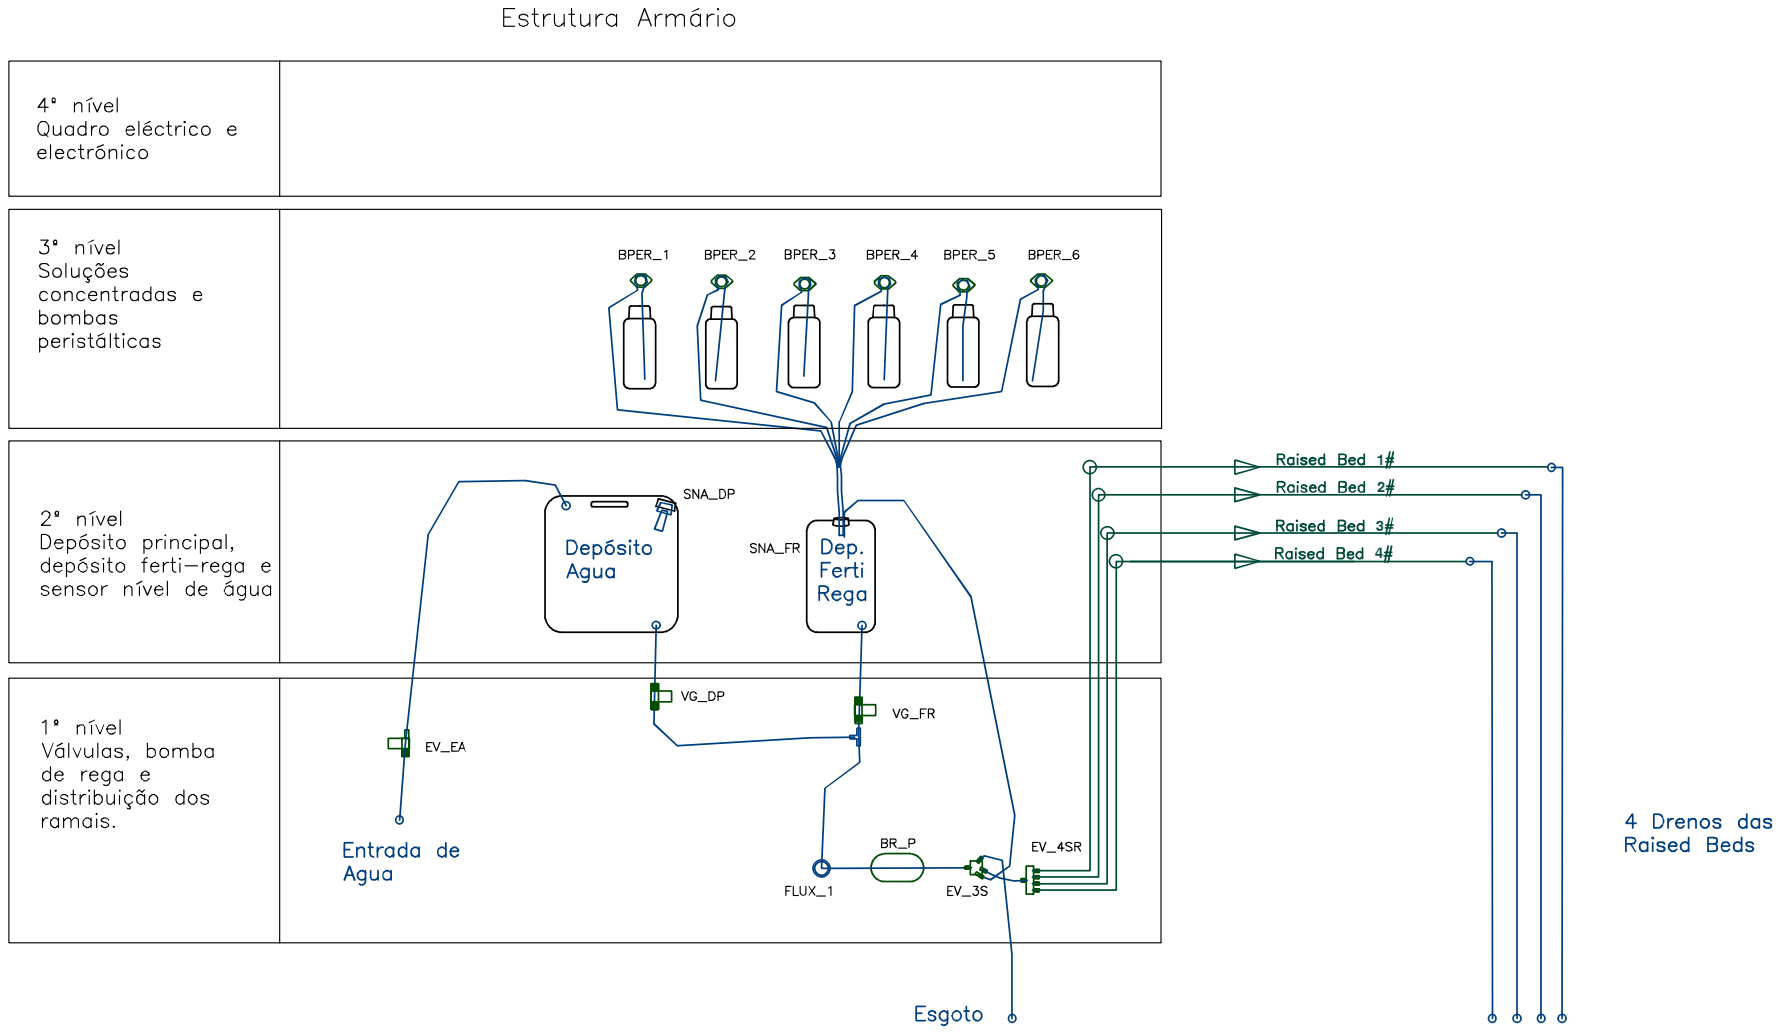
[picture p112: page 1]
