steam228/GROUU/ARCHIVE/grouu-v0/drawings/Modelo Base de DT Base.pdf

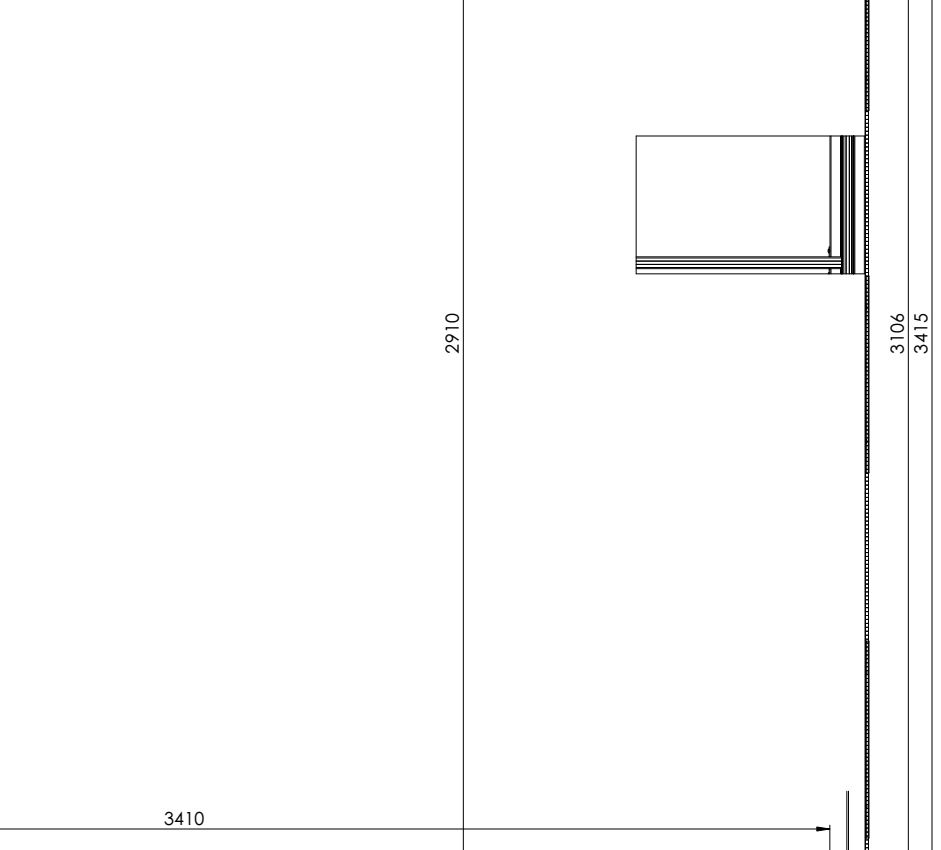
[picture p113: page 1]
