steam228/GROUU/ARDUINO/GROUU_V3/hardware/well-bouy01/layouts/default/default.kicad_pcb

## KiCad design ARDUINO/GROUU_V3/hardware/well-bouy01/layouts/default/default.kicad_pcb (2026-07-10)

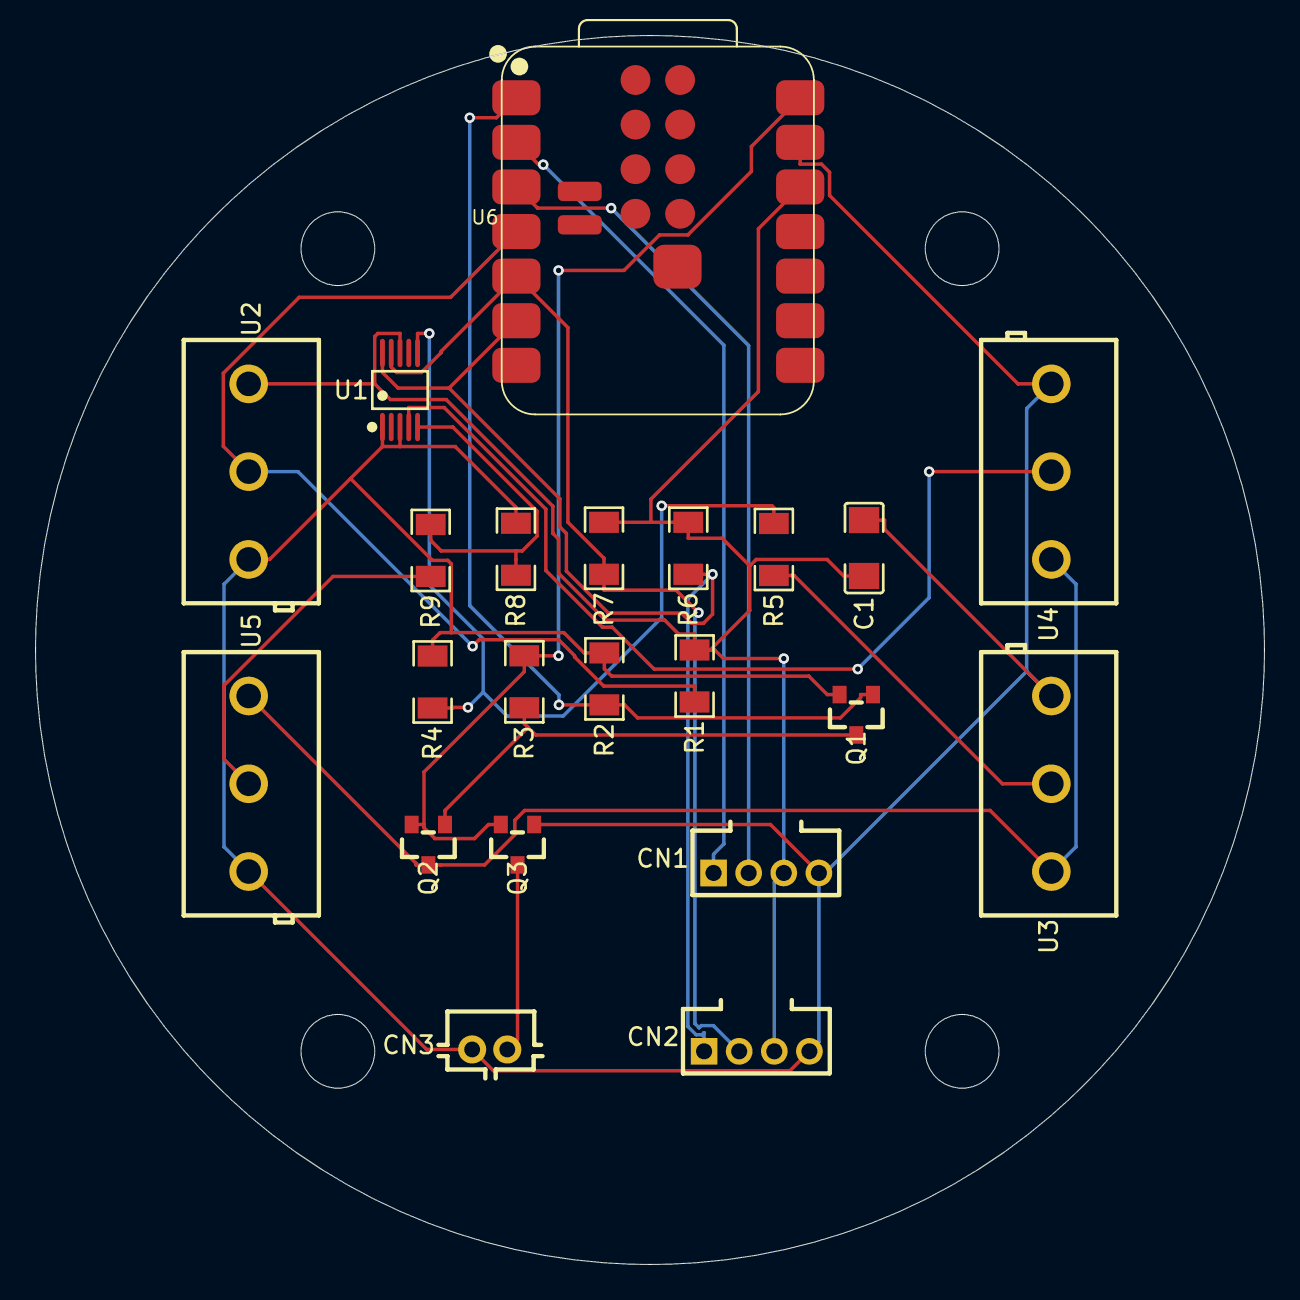
[picture p114: board default.kicad_pcb from above]

Board: 2 copper layers, 70.0 x 70.0 mm, 22 parts (0 on the bottom side), 17 nets.

Parts:
C1: 100nF ±10%; C1206
CN1, CN2: CONN-TH_4P-P2.00_L5.1-W10.0
CN3: CONN-TH_B2B-PH-K-S
Q1, Q2, Q3: SOT-23_L2.9-W1.3-P1.90-LS2.4-BR
R1, R6, R7: 4.7kΩ ±1%; R1206
R2, R3: 100kΩ ±5%; R1206
R4: 18kΩ ±1%; R1206
R5, R9: 10kΩ ±1%; R1206
R8: 6.8kΩ ±1%; R1206
U1: MSOP-10_L3.0-W3.0-P0.50-LS5.0-BL
U2, U3, U4, U5: CONN-TH_3P-P5.00_KF301-5.0-3P
U6: XIAO-ESP32-S3-SMD_PAD

Connections:
1: CN1.1, U6.2
1-1: Q2.3, U3.1, U4.1, U5.1
2: CN1.2, U6.3
5: R8.1, R9.2, U1.5
6: R4.1, R5.2, U1.6
S: Q2.2, Q3.2, R3.2, U6.14
ds_data: R1.1, U2.2, U6.4
hv: C1.1, CN1.3, CN2.3, R1.2, R6.2, R7.2, U1.8, U2.1, U6.12
lv: C1.2, CN1.4, CN2.4, CN3.2, Q1.2, Q3.1, R2.2, R4.2, R8.2, U1.1, U1.3, U2.3, U3.3, U4.3, U5.3, U6.13
pfet_gate: Q1.3, Q2.1, R3.1
ph_in: R5.1, U3.2
scl: CN2.1, R6.1, U1.10, U6.6
sda: CN2.2, R7.1, U1.9, U6.5
sensor_pwr_en: Q1.1, R2.1, U6.1
tds_in: U1.4, U4.2
turb_in: R9.1, U5.2
v5v_raw: CN3.1, Q3.3
