steam228/GROUU/BOARDS/mainProbe/mainProbe_ESP12_mill.brd

## EAGLE design BOARDS/mainProbe/mainProbe_ESP12_mill.brd (2018-08-25)

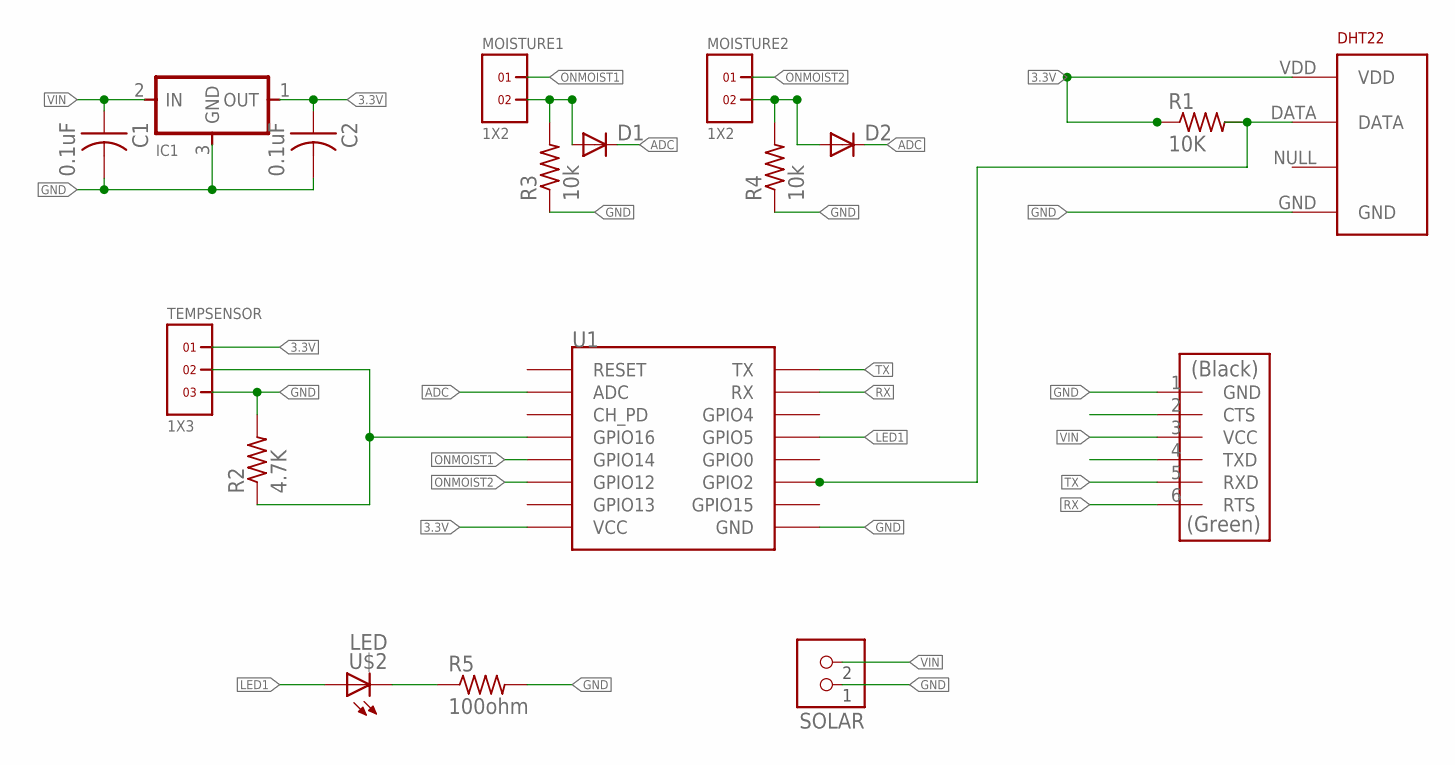
[picture p115: schematic mainProbe_ESP12_mill.sch]

Parts:
C1, C2: 0.1uF; C1206
D1, D2: DIODESOD123; SOD123
DHT22: RHT03_DHT-22_AM2302; RHT03_DHT-22
IC1: REGULATORSOT23; SOT23
MOISTURE1, MOISTURE2: 1X2
R1: 10K; R1206
R2: 4.7K; R1206
R3, R4: 10k; R1206
R5: 100ohm; R1206
SOLAR: TERM-1X02-ADAFRUIT; 3.5MMTERM
TEMPSENSOR: 1X3
U1: ESP12
U$1: FTDI-SMD-HEADER; 1X06SMD
U$2: LED; LED1206

Connections:
3.3V: C2.1, DHT22.VDD, IC1.1 (OUT), R1.1, TEMPSENSOR.1, U1.VCC
ADC: D1.CATHODE (C), D2.CATHODE (C), U1.ADC
GND: C1.2, C2.2, DHT22.GND, IC1.3 (GND), R2.2, R3.1, R4.1, R5.2, SOLAR.1, TEMPSENSOR.3, U1.GND, U$1.1 (GND)
LED1: U1.GPIO5, U$2.1 (A)
unnamed: R2.1, TEMPSENSOR.2, U1.GPIO16
unnamed: D1.ANODE (A), MOISTURE1.2, R3.2
unnamed: R5.1, U$2.2 (C)
unnamed: D2.ANODE (A), MOISTURE2.2, R4.2
unnamed: DHT22.DATA, R1.2, U1.GPIO2
ONMOIST1: MOISTURE1.1, U1.GPIO14
ONMOIST2: MOISTURE2.1, U1.GPIO12
RX: U1.RX, U$1.6 (RTS)
TX: U1.TX, U$1.5 (RXD)
VIN: C1.1, IC1.2 (IN), SOLAR.2, U$1.3 (VCC)

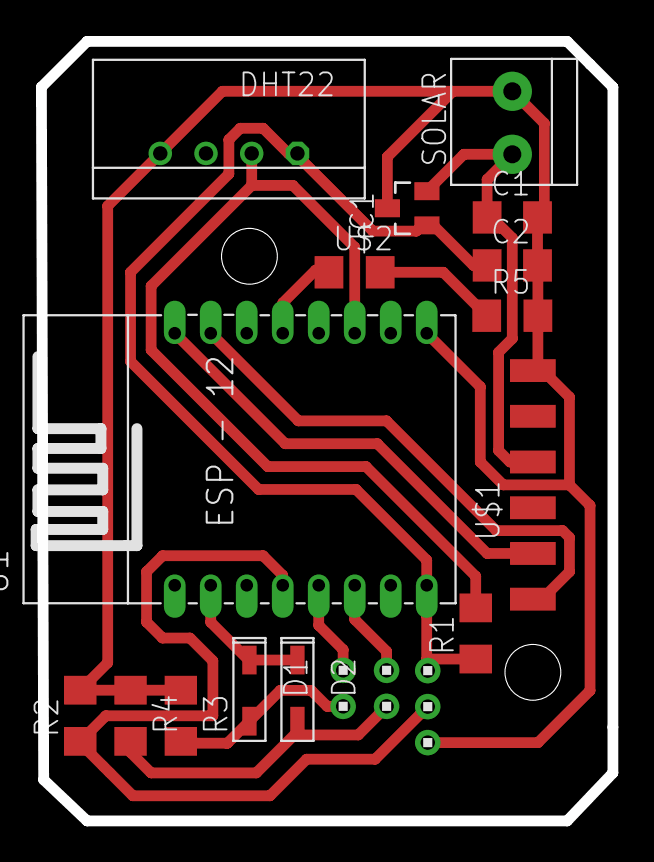
[picture p116: board mainProbe_ESP12_mill.brd from above]

Board: 2 copper layers, 31.8 x 43.3 mm, 18 parts (0 on the bottom side), 14 nets.
