steam228/GROUU/ARDUINO/GROUU_GREENHOUSE_0/GROUU_CENTRAL_GDRIVE_VF/I2C_Anything.h

// Written by Nick Gammon
// May 2012

#include <Arduino.h>
#include <Wire.h>

template <typename T> float I2C_writeAnything (const T& value)
  {
    const byte * p = (const byte*) &value;
    unsigned int i;
    for (i = 0; i < sizeof value; i++)
          Wire.write(*p++);
    return i;
  }  // end of I2C_writeAnything

template <typename T> float I2C_readAnything(T& value)
  {
    byte * p = (byte*) &value;
    unsigned int i;
    for (i = 0; i < sizeof value; i++)
          *p++ = Wire.read();
    return i;
  }  // end of I2C_readAnything
