steam228/GROUU/(commit log)

2016-10-14 w/landing page
2018-07-21 new board
    [mainProbe_ESP12.brd, mainProbe_ESP12.sch]
2018-07-25 arranjo pastas
    [GROUU_smartTankV0.brd, GROUU_smartTankV0.sch, pPump1.brd, pPump1.sch, pPump2.brd, pPump2.sch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]
2018-07-26 placa com headers thanks to FS
    [mainProbe_ESP12.sch, mainProbe_ESP12_mill.brd, mainProbe_ESP12_mill.sch, mainProbe_ESP12_mill_headers.brd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]
2018-07-27 last - mill.headers production
2018-07-31 BH, materials and workshop HW
2018-09-01 new data
    [SoilProbe_ESP12.sch, mainProbe_ESP12.brd, mainProbe_ESP12.sch, mainProbe_ESP12_mill.brd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]
2018-09-01 housekeeping over
    [SoilProbe_ESP12.sch]
2019-02-02 readme componentes para alunos
2026-07-10 GROUU V3 (WellBouy) + new docs site
    [default-B_Adhesive.gbr, default-B_Courtyard.gbr, default-B_Cu.gbr, default-B_Mask.gbr, default-B_Paste.gbr, default-B_Silkscreen.gbr, default-Edge_Cuts.gbr, default-F_Adhesive.gbr]
2026-07-10 fix: TDS sensor is Seeed Grove (DFRobot Gravity is the algorithm)
2026-07-12 docs: extract inline CSS to style.css, fix power + licence accuracy
    - Move all inline CSS from the 5 docs pages into a shared docs/style.css
    (294 deduped classes + base rules + class-based responsive @media rules);
    pages now carry zero inline styles and link the stylesheet.
    - WellBouy power: correct "solar-fed / 1S 18650 / MPPT" to the deployed
    config — mains-rechargeable 1S LiPo 4500 mAh, no solar (board stays
    solar-capable). Matches the locked B1 spec.
    - Licence: dual-license the project — GPLv3 for code, CC-BY-SA 4.0 for
    hardware & docs. Update hero + all footers, rewrite the placeholder
    LICENSE.txt as a dual-licence notice, add full LICENSE-GPLv3.txt and
    LICENSE-CC-BY-S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
2026-07-13 docs: mobile fixes + per-recipe pages with code, repo links & BOM
    Responsive
    - Add a mobile burger menu (menu.js) for the home nav.
    - Stack the horizontal flows and rotate the → arrows to ↓ on mobile.
    - Un-squeeze the node/evolution grids (3 → 2 tablet → 1 phone); hide hero
    dividers on mobile.
    Content
    - New dedicated pages: actuator.html (V1 grouu-wrout relay router),
    aquaponics.html (fishTank precursor), greenhouse.html (archived) — each
    linked from its home card.
    - Add a repo link + representative code snippet + BOM to every recipe page;
    WellBouy gets a fully-linked BOM (Seeed/DFRobot/Phidgets/Adafruit/Mauser).
    - Correct GROUUWAN: the committed V2 firmware uses a Wio-E5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
2026-07-13 docs: refine mobile burger menu
    - Drop the button's border box; render a clean, flex-centred glyph in the
    theme colour so it aligns with the logo instead of hanging low.
    - Normalise the dropdown: all items left-aligned to the logo inset, and the
    GitHub link loses its pill background so it aligns by text, not shape.
2026-07-16 firmware: pH 3-point (4/7/10) segmented calibration
    Recalibrated the Phidgets 1130 pH probe with three buffers and switched from a
    two-point (4/7) linear fit to a segmented fit pivoting at pH 7:
    - acid slope from pH4/pH7 below V7, base slope from pH7/pH10 above it.
    Handles the electrode's lower alkaline slope (measured 177 vs 153 mV/pH); a
    2-point fit read ~9.6 at true pH 10.
    Measured 2026-07-16 at the ADS pin: pH4=0.987V, pH7=1.519V, pH10=1.980V.
    Verified live: buffer 10 reads 10.00. prod uses it via ph_sensor.cpp.
2026-07-17 archive: GROUU V0 (GrouuPro) + docs V0 page
    Archive the original centralized greenhouse (GrouuPro, ~2013-14) under
    ARCHIVE/grouu-v0/ — the full-stack ancestor of GROUU's sense->serve->visualise
    architecture (Arduino -> Node.js/socket.io on a Pi -> Angular/d3 dashboard,
    custom EAGLE control board, LEXAN/aluminium structure).
    Committed light IP only (~2 MB): the Grow web app + Arduino (git cruft and
    vendored libs stripped), the hex-motor-controller PCB, and key drawings. The
    1.5 GB of CAD/photos/Keynote stays on backup and is catalogued in MANIFEST.md
    + full-file-index.txt. Sole-authored; build assistance credited to Rui Lopes.
    Docs: rewrite greenhouse.html into the real GrouuPro V0 page (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
    [hex-motor-controler.brd, hex-motor-controler.sch]
2026-07-17 archive: correct V0 to the real GrouuPro system; redact creds; purge cruft
    The V0 firmware is the Yún/Temboo code already in ARCHIVE/arduino/GROUU_GREENHOUSE_0
    (not the Node/Angular experiment I first assumed). Corrected everywhere to the
    actual, factual system:
    - Arduino Uno probes (DHT22, LDR, soil moisture, leaf wetness, DS18B20, pH) →
    I2C → Arduino Yún → Temboo → Google Spreadsheet "GROUU_EXP".
    - Local actuation only: top-hatch servo + DC pumps/valves via perfboard MOSFETs
    feeding a 6-pump fertigation cabinet and 4 raised beds. No custom PCB.
    - Remote control and automation were never implemented.
    Also:
    - Redact Temboo app key + Google username/password to "REDACTED" acros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
    [hex-motor-controler.brd, hex-motor-controler.sch]
2026-07-17 docs/archive: GrouuPro V0 photos + master-plan outline
    - Add 16 web-sized build photos (docs/site/img/v0 + ARCHIVE/grouu-v0/photos;
    full-res stays on backup): greenhouse, construction, ventilation hatch,
    fertigation cabinet, pumps, inlets, the Arduino Yún control unit, probes,
    raised beds. built.jpg is the page hero.
    - Archive the GROUU OUTLINE PDF — the envisioned master plan (login/profiles,
    environmental definitions, tests, watering solutions, log & annotation,
    real-time dashboard w/ alerts) on a Yún → Node → RPi → web architecture,
    designed but never built.
    - Rewrite greenhouse.html: hero image, real photo gallery, and a "master plan"
    section distinguishing what s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
2026-07-17 docs: fix V0 gallery captions & raised-bed order
    built3 is an interior detail; fertirrigation.jpg is the peristaltic pumps and
    pumps1.jpg the main pump; raised-bed photos reordered (2, 3, 1).
2026-07-17 archive: consolidate V0 firmware into grouu-v0/firmware
    Move the greenhouse firmware ARCHIVE/arduino/GROUU_GREENHOUSE_0 → ARCHIVE/grouu-v0/firmware
    so the whole V0 archive lives in one place; update docs/README/MANIFEST links.
    ARCHIVE/arduino/ is now empty (GROUU_BASIC_0 is a separate project).
2026-07-17 archive: add audited SolidWorks model tree to grouu-v0
    Commit the recovered + reorganised SolidWorks greenhouse project (EVOL 2013-14):
    master assembly (2013.09.28 Modelo Base de Estufa_AR, Nov-2013 state) + flat
    Dependencies/ + Detached Modules/ (five 2014 subsystems never integrated + two
    2013 studies). 188 files, ~194 MB, largest 7.1 MB. Full forensic audit in
    solidworks/README.md. Wire it into the grouu-v0 README/MANIFEST + docs page.
    [2013.08.28 Modelo Base de Estufa_AR.SLDASM, 2013.09.28 Modelo Base de Estufa_AR.SLDASM, 2014.02.25 Apoio Motor.SLDPRT, 2014.02.25 Dobradiça.SLDPRT, 2014.02.25 Perfil em T.SLDPRT, 2014.02.26 Conjunto escotilha Lateral.SLDASM, 2014.02.26 PC Escotilha.SLDPRT, 2014.02.26 PC lateral.SLDPRT]
2026-07-21 docs: replace V0 prose sections with the four system schemes
    Import the GROUU Schemes design (claude.ai/design) as four diagram sections on
    the greenhouse V0 page — 1a system block, 1b fertigation P&ID, 1c envisioned
    architecture (dark), 1d app map — extracted into a .sch* CSS system recoloured to
    the site palette (no inline styles) and made responsive. Replace the prose/table
    sections; de-promotionalize the header, 3D and related copy (factual, listing).
2026-07-21 docs: update V0 scheme 1c to the redesigned architecture diagram
    Re-import scheme 1c (envisioned architecture) from the GROUU Schemes design: a
    central-core spatial diagram (wired probes → dual-role Yún MCU/Linux → global
    actuators, and two server paths A envisioned / B as-deployed) with an SVG line
    overlay. Extracted into .c1* classes recoloured to the site palette (SVG lines
    to #65c298), on a fixed 680x640 canvas wrapped for horizontal scroll on small
    screens. Only 1c changed.
2026-07-23 docs(wellbouy): add live Fusion 360 embed + enclosure section (renders, sketching timelapse); fill power photo. Remove greenhouse Fusion placeholder.
2026-07-23 docs(basic-node): common structure — Overview scheme, goals/context, Completed status, Projects nav
2026-07-23 docs: promote LoRaWAN Basic Node to Completed (peer to WiFi node) — reframe grouuwan status, fix board to XIAO SAMD21, add Completed card
2026-07-23 docs(wellbouy): implement the five system schemes (2a ecosystem, 2b architecture, 2c lifecycle, 2d dashboard, 2e firmware UML) in .sch* vocabulary — from GROUU Schemes design
2026-07-23 docs(wellbouy): distribute the five schemes into topical sections (Overview 2a/2b · Firmware 2c/2e · Data 2d), split BOM, ease scheme spacing
2026-07-23 docs: full section skeleton on aquaponics + actuator (placeholders on empty sections, overview schemes, nav fixes)
2026-07-23 docs(wellbouy): adopt the common 5+2 spine — 01 Overview · 02 Design · 03 Hardware · 04 Software · 05 Process + Gallery + References, each with repo links and images
2026-07-23 docs(wellbouy): add hero, move board photo into Hardware, Gallery keeps renders + sketch
2026-07-23 docs: nursery/aquaponics/actuator onto the 5+2 spine (Overview·Design·Hardware·Software·Process + Gallery + References), photos in-section
2026-07-23 docs(greenhouse): move app-map/UML to Software; fix contrast — wrap architecture canvas in a dark panel, recolor status-card text on dark Process sections
2026-07-28 docs(css): align inner pages + template to the index grid — containers 1120→1200, nav logo .s5 matched to .s87 (36×102, no longer cut)
2026-07-28 WellBouy: Grove turbidity swap + new-board bring-up
    - Turbidity: DFRobot SEN0189 -> Seeed Grove; per-sensor TurbidityCal,
    clear-anchored relative index (3.79 V->0), config + driver + docs.
    Legacy SEN0189 kept as a selectable variant; dev-board direct-ADC
    path untouched.
    - TDS calibrated k=0.944 (705 ppm @ 1413 uS/cm)
    - Bring-up fixes: deep+ LDF, EU868 duty-cycle off (bench), 5 V rail
    enable in b03/b04/b05; remove temp b_iscan diagnostic
    - Confirmed terminal->ADS map from PCB (U5=turbidity/A1, U3=pH/A2)
    - Add docs/Bringup-Log.md; site BOM/sensor cards -> Grove
2026-07-28 WellBouy: pH 3-point recalibration on well-bouy01
    Re-measured against 4/7/10 buffers (IDs inferred from voltage):
    V4 0.987->0.969, V7 1.519->1.507, V10 1.980->1.889. Base slope
    aged to 127 mV/pH (segmented fit handles it). Log updated.
2026-07-28 WellBouy docs: add bench bring-up photos to gallery
    Two bench shots from the new-board bring-up — probes calibrating in a
    mug and the wired-up setup. Downscaled to web size (1600px long edge).
2026-07-30 WellBouy: rev-B feedback + atopile rev-B scaffold; gallery photos
    - Gallery: add hand-solder casualties (3 boards) and the opened Grove
    turbidity sensor to the WellBouy page
    - Board-Design.md: rev-B change list from rev-A build/bring-up — ADS
    SMT-assembly, function silk on terminals, input fuse+TVS + test
    points, Grove turbidity BOM
    - atopile: new WellBouyRevB module (wellbouy_revb.ato) inheriting the
    frozen rev-A netlist + rev-B changelog; new `revb` build. Compiles
    through electrical verification (part-pick needs network). rev-A
    (main.ato) untouched as the fabricated board of record.
